alan9900/Thermal-coupling-analysis-under-drive-control-integration/reports/M3_HELICAL_CHECKLIST.md

# M3 斜齿限定修订验收表（2026-10-20）

PR #4 / stage/M3-geometry；本轮概念几何通过，M3整体仍PARTIAL。

- [x] 原三轴坐标、100/120mm中心距、20/60齿、9.0、50mm输出轴保持。
- [x] 固定端面模数2.5/3.0mm；mn=2.34923155/2.81907786mm，非标准法向模数如实说明。
- [x] 真实螺旋扫掠实体；每对相反旋向，真实B-rep长边反算±20°与端面齿数计数通过。
- [x] 原轴向位置及25/32mm齿宽，中间轴两齿轮间37mm保持。
- [x] Case0/A/B/C各完整、热版共8装配；18STEP实际导出并回读检查。
- [x] 3006对全装配AABB后精确布尔零体积穿透；14对旋转啮合几何检查通过。
- [x] 124个未改零件真实位置、边界框与原STEP一致。
- [x] 齿轮和整部件体积/质量/热容表齐备，541项逐体全/热版热容一致性通过。
- [x] 原直齿源码/CAD/结果、M2固定成果与原映射不覆盖。
- [x] 独立热源映射归一，原真实接触/冷却null保持；M1损耗暂沿用且未重标定。
- [x] 数量级轴向力记录；中间轴推力约6.624kN，明确不默认抵消。
- [x] 源代码、配置、报告MD/DOCX/PDF、5图、CSV/JSON/日志及来源PDF归档。
- [ ] 轴承轴向承载与定位验证：BLOCKED，本轮未扩展设计。
- [ ] 齿轮制造、疲劳、真实效率与温度标定：未完成，不在本轮范围。
- [ ] 原连接套/罩支点热态/实际接触及冷却限制：继续保留。
- [ ] 研究者批准M3合并/正式Tag及下一阶段：待审核；不合并、不打Tag、不进入M4。

5个可编辑Word公式与PDF实际渲染检查见document_checks.json；原始失败日志保留，测试通过不代表上述BLOCKED项通过。
