alan9900/Thermal-coupling-analysis-under-drive-control-integration/reports/M1_GATE_ACCEPTANCE_2026-10-19.md

# M1 正式验收关卡（2026-10-19）

研究者明确授权：按“具有明确来源、参数化假设和不确定性分析的概念数值热源模型”限定范围验收M1，要求合并PR #2并创建M1-v1.0；仅在远端归档核验成功后，从最新main创建M2阶段分支。

本次最终复核：原18组及新增11组MATLAB R2025a测试记录齐备；23整车轨迹、46对单侧CSV/JSON、322次敏感性结果及参数矩阵、MAT、PNG/SVG、日志、Markdown/Word/PDF报告和验收表均在Git中。Python独立检查已再次实际执行PASS。数值代码 `2b336e62485e0183f79428dd6009ec7aa32a1ab3`，原完整证据 `ec134044c346e10cac3f7d31e0bfc99dc641ec13`。数值代码未改，不重复宣称重新运行MATLAB。

验收不包括真实损耗标定、实体温度验证、连续能力或法规符合性：实际电流、铁/转子损耗分离、真实再生、减速器方向图/空载搅油、BMS及材料/冷却仍有缺口，**真实标定仍PARTIAL**。原NaN/null不回填；工程区间不是统计置信区间，各热源独立上界不能拼成共同工况，逆变器不默认计入电机绕组，转子其他不等同磁钢热源。

计算结果JSON中未批准/未建Tag字段是当时运行状态，不覆盖本次明确验收；当前审批及实际Tag目标以STAGE_VERSIONS和远端Git验证为准。M1-v1.0必须为本次实际main合并提交的附注Tag；不得指向仅代码提交或旧证据提交。M0-v1.0保持不变。

M2获准范围是单侧概念LPTN、来源与工程参数分离、四类工况、三类路径、能量/数值验证与敏感性，以及报告/PR。不包含M3 CAD、ANSYS或Fluent；M2 PR/正式Tag/进入M3均须用户另行批准。
