alan9900/Thermal-coupling-analysis-under-drive-control-integration/docs/DUAL_MOTOR_V03_ARCHITECTURE.md

# V0.3 双独立电机、单侧热耦合研究架构（当前有效）
日期：2026-10-18。此文件与 `configs/baseline_vehicle.yaml` 是新的**权威基准**；此前 V0.1/V0.2 文字中“中央单电机+差速器”全部为历史设计，不得用于新模型。数值属于概念研究假设，未经厂家或试验验证。

## 1. 机械拓扑和研究边界
1800kg前驱纯电动乘用车；前轴左、右各装**一台独立牵引电机、一套固定减速器、一套输出端内移摩擦制动盘与独立卡钳**；**无机械差速器**，车轮速度差通过电机独立调速实现。制动盘布置于**单侧减速器输出轴**，与对应车轮输出转速1:1（没有下游额外速比时），而不是电机输入轴转速。两个单元在整车动力学中同时存在；热网络/CAD/ANSYS/Fluent只对**单侧**详细建模。后轴保留常规制动器，在整车模型中承担其分配制动力。

## 2. 推荐参数（只为可复现概念基线）
| 项 | 整车/前轴 | 每侧电驱单元 |
|---|---|---|
| 整车质量 | 1800 kg | - |
| 前轴电机数量 | 2 | 1 |
| 电机峰值机械功率 | 合计120 kW | 60 kW |
| 电机峰值机械扭矩 | 峰值扭矩代数和260 N·m | 130 N·m |
| 电机候选最高转速 | - | 14000 rpm（未验证） |
| 传动比 | 两个独立9.0 | 9.0 |
| 减速器牵引效率 | - | 0.96，粗略假设；反拖分开 |
| 制动盘 | 前轴共2个 | 外径280mm、厚22mm、摩擦系数参考0.40 |
| 轮胎有效半径 | 0.32m | 对应轮速 |
| 轴距、重心高、静前轴载荷比 | 2.8m、0.55m、55% | 不再对单侧重复使用整车质量 |

潜在调整：如果每侧都需承担强的再生制动/高速驱动，选择65–75 kW、150–170 N·m也可作为后续替代方案，但前轴合计动力性能将提升，需要统一更新能耗与控制约束。**不要为了制动盘1132 N·m机械制动力矩就盲目把电机130 N·m放大到同等折算值**，摩擦制动盘由卡钳独立产生制动扭矩。

## 3. 自洽性验算（无风阻/滚阻/旋转惯量的演示）
`v=100/3.6=27.778 m/s`；`n_w=v/(2π*0.32)*60=828.93rpm`；`n_m=9*n_w=7460.39rpm`；每侧60kW/130Nm的理想基速`n_b=60k/(130*2π/60)=4407.37rpm`；100km/h时理想峰值转矩受功率限制为`76.80Nm`；160km/h电机转速约11936.6rpm。
每侧低速牵引轮端峰值转矩`130*9*0.96=1123.2Nm`；两侧之和2246.4Nm。注意这仅说明理想稳态动力输出与旧中央单电机方案一致，不代表加速极限受附着或电池功率满足。
100→0平动动能约694.44kJ。平路0.6g制动前轴理想动态分配系数`0.55+0.6*0.55/2.8=0.667857`，前轴总制动力约7075.8N；左右对称，各侧输出端摩擦盘需要`7075.8*0.32/2=1132.13Nm`（**仅零再生的例子**）。0.3g约516.12Nm，0.8g约1598.30Nm。与旧方案相比单盘负荷**不再除以二**：之前本身已有两个前盘。
100km/h下0.6g前轴需求总机械制动功率约`7075.8*27.7778=196.55kW`，单侧约98.28kW。每侧60kW为**电机峰值机械驱动额定定义**，不保证连续再生60kW，也不是卡钳摩擦制动上限。若做概念再生上限估算，单侧回生电机轴端与轮端的能量需要分清反拖效率，受电池接收功率、转矩、电压、SOC和温度制约；无数据默认零再生进行安全边界热负荷仿真。

## 4. 必须区分三个机械功率
1. 摩擦制动热功率`P_fric=T_fric_disc*omega_disc`。
2. 电机在驱动时机械轴端功率，及反拖时从轮端传入的机械功率；传动损耗方向不同。
3. 单侧减速器损耗热，在驱动/再生情况下按不同效率或损耗MAP单独计算。不可把整车制动功率全部作为摩擦热，也不可简单把摩擦热直接加到电机热节点。

## 5. 单侧热网络建议
节点：制动盘、摩擦片/卡钳、护罩、输出轴/轴承、减速器壳体、齿轮与油液、电机壳体/定子/绕组、转子磁钢、周围空气与冷却液边界。路径：盘→护罩/壳体辐射；热空气→壳体对流；盘→输出轴→轴承→壳体固体导热。电机自身铜耗/铁耗与减速器啮合/搅油损耗独立加入。冷却边界保持简单参数化，不先做全车热控制。

## 6. 优化设计
对照Case0 无护罩，CaseA单层，CaseB双层间隙，CaseC隔热+导流，CaseD CaseC参数优化。单侧模型保持相同制动机械热源和初始条件。变量`[盘-护罩间隙,厚度,导流出口角度,出口面积比]`。目标筛选为电机绕组最高温度、减速器油温、制动盘峰值温度与附加质量；在可靠热限未知前只做相对改善，不宣称可量产。
输入工况：M1首版0.3/0.6/0.8g零再生，再生场景需双方电机和电池总限值分配；M7主工况为高负荷牵引预热后循环制动。

## 7. 必须优先确认（P0）
(1) 60kW/130Nm单侧电机的最大转速与正/反拖效率或损耗MAP；(2) 单侧减速器速比/减速级数/齿轮箱几何/损耗；(3) 输出端制动盘实际质量、有效摩擦半径、卡钳转矩容量与热衰退；(4) **制动盘至减速器壳体的最小净距离**，并区分与制动盘到护罩间距；(5) 单侧电机和减速器冷却边界与允许温度；(6) 左右驱动功率/再生分配、后轴制动及轮胎附着约束。

## 8. Codex M0 Gate
M0首先检查项目中是否残存 `differential`、`single_motor`、`motor_peak_power_kw:120` 被当作*单侧*输入的旧逻辑。测试理想速度换算、60kW分段功率-转矩限制、左右功率合计、动力学制动力、单侧盘负荷及每侧热源能量闭合；未通过不进入M1。旧`docs/BASELINE_V02_AUDIT.md`历史数值仍可作为**整车制动边界**参照，但其“中央单电机”架构结论失效。所有结果标明ASSUMED/SYNTHETIC与模型版本。
