alan9900/Thermal-coupling-analysis-under-drive-control-integration/docs/M2_SOURCE_REVIEW.md

# M2 参数、资料与适用范围审查

本阶段为S3概念LPTN，未做实物温度标定。参考数据、方法依据和工程等效参数严格分开；`configs/baseline_vehicle.yaml`及已验收M1不改。检索采用已读取的nature-academic-search多来源检索流程：学术MCP未挂载，使用NIST、作者期刊页面、制造商原始资料和CrossRef；并非穷尽检索。

| 来源 | 核实内容与实际用途 | 限制 |
|---|---|---|
| ORNL 2011 Prius报告，表2.7，印刷46/PDF55页；M0已存原件 | 参考定子铁心10.36kg、绕组铜4.93kg、转子6.7kg（含电机轴）；作为等效热容的质量参照 | 不是本概念总成实测质量；输出轴为减速器另一根轴，不重复计入电机轴；材料复合热容仍是假设 |
| [NIST Copper](https://webbook.nist.gov/cgi/cbook.cgi?ID=C7440508&Mask=2) / [Aluminum](https://webbook.nist.gov/cgi/cbook.cgi?ID=C7429905&Mask=2) / [Iron](https://webbook.nist.gov/cgi/cbook.cgi?ID=C7439896&Mask=2)，Chase1998 | 固相Shomate式及摩尔质量；298.15K折算cp约385.08、897.14、449.41 J/(kg·K)，铜385、铝类900的候选量级可追溯 | 纯材料，不是浸漆绕组、叠片、齿轮钢或复合转子；模型常数cp忽略温变，整体热容仍S3 |
| [Hydro EN AW6082资料线索](https://www.hydro.com/Document/Index?id=7824&name=Hydro+EN+AW+6082.PDF) | 官方搜索索引可见密度2.71g/cm³、cp897 J/(kg·K) | 直接PDF获取失败，未声称取得本地原件。ρ2710、k170作为铝类S3候选，尤其k170未据此冒称具体牌号已核验 |
| [Fluke金属发射率表](https://www.flukeprocessinstruments.com/en-us/service-and-support/knowledge-center/infrared-technology/emissivity-metals) | 原厂页面可读，表明抛光/氧化与波段显著影响发射率；氧化铸铁可见约0.7–0.9的部分波段条目 | 红外测温表的谱发射率不等于本模型的总半球灰体值；盘0.8、壳体0.7、护罩0.2均为S3，不能由材料名直接标定 |
| [COMSOL自然/强迫对流方法说明](https://www.comsol.com/blogs/modeling-natural-and-forced-convection-in-comsol-multiphysics/) | h与自然/强迫流动、几何及工况相关，方法页举强迫换热量级 | 本模型h=h0+hv√v并非该文拟合关联式，未做CFD、未证实内移盘局部气流；所有面积/h/通风参数S3 |
| Xiao & Griffo 2020，[DOI10.1049/iet-epa.2020.0119](https://doi.org/10.1049/iet-epa.2020.0119) | 期刊全文浏览可读：电机定子、绕组、转子网络与热参数辨识；需要测温等证据才能辨识热阻 | 不移植其机器热阻或温度误差。Python直接下载失败，保留限制，不伪造本地全文 |
| Corley等2019，[DOI10.1049/joe.2018.9282](https://doi.org/10.1049/joe.2018.9282)，M1已有公开PDF | 分项损耗分别加载节点、C=mcp及热网络方法；CrossRef元数据复核 | 原对象为风机减速器，仅借鉴方法，不转用几何与标定 |
| NASA早期发射率检索路线 | 原始路线直接下载失败；另有表面氧化/高温谱发射率研究线索 | 未用于填任何“实测”参数，失败记录保留在manifest |

检索时间、URL、HTTP状态、摘要性用途及内容哈希见 `data/raw/m2/manifest.json`。可复算材料参考式/数值见 `material_reference_values.json`，不复制受版权限制的整页数据库。Fluke补充浏览核对在该材料登记中另列；并非热参数标定。资料可能有访问限制，未因下载失败而假造原件或无限等待。

## 数值候选与实际使用

13节点的质量、cp、ρ、k、ε、热容和假设级别均导出到 `results/m2/parameter_source_table.csv`。**只有质量×cp参与C；ρ、k是材料与后续几何审查候选，本阶段没有用它们反推出真实尺寸或接触R。** 质量和cp中部分S1/S2标量的组合不使整个节点或总成成为已标定对象。

盘4.5kg、片/钳等效2kg、输出轴1.2kg、轴承0.35kg、齿轮2.5kg、油0.8kg、减速器壳4kg、电机壳5kg、护罩0.4kg及局部空气0.05kg均为S3。片/钳合并保留总热容，仅预测平均等效温度，不给片面热点或制动液温度；转子/其他是合并损耗节点，不是永磁体热点；油节点也承担未分离齿轮箱其他损耗，不能等同真实均匀油池温度。

导热网络15条等效R（0.08–8K/W）、对流面积、有效辐射面积/视角因子、液冷G=25W/K均为S3。盘—轴、轴—轴承/齿轮、轴承—壳体、壳体法兰、定子/绕组接触及钳支架这9组等效R共同乘接触尺度0.3–3；该尺度覆盖的是包含接触与部分几何的等效热阻，不是分别识别的真实接触热阻。

环境和入口冷却液候选均298.15K，用以隔离热源效应；冷却液温度另扫到333.15K。液冷通过电机壳体的固定温度热库与总导热能力表示，不虚构流量或泵参数。若冷却液更热，热量可以倒流进入网络，必须保留负的“冷却净带走热量”。

## 不确定性口径

热容0.6–1.4、接触R0.3–3、对流0.5–2、液冷G0.5–2、辐射交换0.5–1.5、电机联合损耗0.8–1.2、减速器损耗0.7–1.3及冷却液298.15–333.15K为S3单因素探索范围，不是概率分布，也不保证包含真实值。辐射尺度改变内部有效交换，未穷尽外界辐射、遮挡、表面老化及几何不确定性。

两组M1分配参数联合端点也分别重算整套守恒分项，不拼接各项上界。总损耗尺度把相关分项共同缩放，保持组内预算，但没有重新求电池限充和再生控制；属于固定运动/控制工况下施加热源误差，不称为重新闭合的整车能量轨迹。

空载电驱拖曳、齿轮搅油与温度反馈仍未建模：停用时真实附加热可能大于零，乘法尺度不能恢复基准为零的损耗；真实油黏度、绕组R、磁性和冷却随温度变化会改变热源/热阻。当前不做闭环追加3RI²，避免在M1总预算之上重复加热。缺少真实冷却和内部热阻是绝对温度可信度的主要限制，不能用数值守恒替代实验验证。
