alan9900/Thermal-coupling-analysis-under-drive-control-integration/docs/REAR_DRIVE_V04_SOURCED_BASELINE.md

# V0.4 后驱分布式双电机 / 单侧驱制热耦合方案（当前权威）
更新：2026-10-18。主配置文件：`configs/baseline_vehicle.yaml`。原V0.1中央单电机、V0.3双前驱均**失效**，只作为历史记录。所有跨车型拼接的硬件为**概念研究**，不是实际大众ID.3或丰田电驱桥的量产总成。

**M0审查已完成（2026-10-18）**：见 [M0报告](../reports/M0_report.md)、[复算说明](../scripts/m0/README.md)。EPA MG2原包已下载并核验：`.m`含14×39联合电功率表，0–13000rpm、−200至200Nm；负转矩区由驱动损耗乘1.05镜像估计，**不是实测再生图**。另发现137个配对的独立电机/逆变器驱动效率点；仍没有绕组损耗图。13000–13500rpm不可直接外推。M0之后的热源、热场与优化仍须用户确认。

## 1. 来源可信度与引用
**整车尺寸参照**：Volkswagen ID.3（2023）官方技术资料：https://www.volkswagen.ie/idhub/content/dam/onehub_pkw/importers/ie/models/product-guides/my23/ID3_MY23.pdf ，可确认相关车型动力水平、160 km/h最高车速、215/55R18轮胎；轴距2765mm已在MY21官方PDF第19页图示L101目视核实：https://www.volkswagen.ie/idhub/content/dam/onehub_pkw/importers/ie/models/product-guides/2021/my21_master/ID3_MY21.pdf ，属于较早版本几何参照。Cd=0.27的2020官方技术页本次直接访问404，仅搜索索引可见，保留为未验证筛查值。概念车质量1800kg、后轴静载55%、重心高0.55m等是**工程假设**，不能归为同一版本厂商测量值。大众减速器资料：https://www.volkswagen-group.com/en/press-releases/in-brief-the-all-rounder-the-1-speed-gearbox-17030 ，公布2级单速减速器及约10倍速比（非本研究减速器9.0的真实来源）。
**电机额定能力参照**：Toyota 2009第三代Prius发布 https://global.toyota/en/detail/308252 (60kW、207Nm)；ORNL FY2009基准研究 https://info.ornl.gov/sites/publications/files/Pub21475.pdf (额定最大速度13500rpm、60kW、207Nm)；单侧电机为概念移植，**不代表此电机能在1800kg纯电后驱车中以60kW持续工作**。
**效率数据**：美国EPA https://www.epa.gov/vehicle-and-fuel-emissions-testing/combining-data-complete-emotor-alpha-maps ，其中“2010 Toyota Prius 60kW 650V MG2 EMOT”数据包。EPA定义EMOT=电机+逆变器（不包含齿轮）；**不等于纯电机铜/铁损耗MAP**。原包已于M0下载核验，原始文件及哈希见`data/raw/m0/`。数值再生区存在但为镜像估计；`3c`有独立电机和逆变器的稀疏驱动效率。不能据此直接建立绕组发热图，`motor_loss_map_file`仍为null。
**制动盘几何参照**：Brembo https://www.bremboparts.com/europe/en/view-document/catalogue/disc/09-9908-21 ，后轴通风盘：直径280mm、厚22mm、总高度42mm、中孔68mm。该产品是量产后制动盘几何参照，**不能直接断言可以安装于单侧电机减速器输出轴**；必须重新设计盘毂、轴承、卡钳支架并校核强度与温度。
**原方法学借鉴**：Park et al. (2025), Energy Conversion and Management 325,119406 DOI:10.1016/j.enconman.2024.119406，原文对象是轮边EMB执行电机，不等于主牵引电机。
文献都只支持其明确披露的参数；缺乏的重心、轴荷、负载、效率与结构尺寸全部按概念假设处理。

## 2. 当前架构
1800kg **后驱**纯电概念车型。后桥左侧、右侧各1套**独立永磁同步驱动电机(参考2010 Prius MG2) + 独立双级减速器(设计候选总速比9.0) + 减速器输出端内移摩擦制动盘**。不设机械差速器；每侧轮速/制动盘转速独立；前桥保留常规摩擦制动器。**只对一侧电机、减速器、内移制动器开展详细三维温度场/隔热导流优化**；整车制动力与再生分配必须同时计入两侧及前轴。对称直线工况每侧后轴需求 = 后轴总需求/2；非对称工况只在鲁棒性阶段处理。

## 3. 建议的当前基准值及判据
| 参数 | 数值 | 证据/状态 |
|---|---:|---|
| 整车质量 | 1800 kg | 概念基准（不是该版本ID.3实测值） |
| 轴距 | 2.765 m | ID.3级尺寸参照；待在具体车型官方规格中核实 |
| 后轴静态荷重比例 | 0.55 | 假设，扫描0.50–0.60 |
| 重心高度 | 0.55 m | 假设，扫描0.45–0.65m |
| 轮胎标称规格 | 215/55R18 | VW官方参考 |
| 轮胎标称未加载半径 | 0.34685m | 按轮胎标称尺寸几何换算 |
| 有效滚动半径 | 0.33 m | 假设，需测量/扫描0.32–0.34m |
| 设计最高车速 | 160 km/h | 参考ID.3目标；动力性能待验算 |
| 电机每侧 | 60kW、207Nm、13500rpm | Toyota/ORNL原始电机能力参照 |
| 软件牵引转矩限值 | 130Nm/侧 | 设计假设；非电机硬件铭牌值 |
| 电机连续功率、回生极限、铜/铁损耗 | 未知 | 必须确认；不可直接采用60kW |
| 每侧减速比 | 9.0 | 两级候选方案；需几何参数化 |
| 减速器驱动/反拖效率 | 分别初设0.96 | 粗略估计，后续损耗MAP |
| 制动盘几何 | φ280×22mm,高度42mm | Brembo原后制动盘参照，改内移需要设计 |
| 电驱冷却液温度/流量、允许温度、制动盘质量 | 未知 | P0/P1重点数据 |
| 盘-壳体净间距、轴径/支架/壳体几何 | 未知 | 不能提前冻结隔热罩 |

## 4. 可复核自洽性算例：驱动
`r=0.33m, i=9, P_motor_peak=60kW, T_motor_hardware_peak=207Nm, T_software_limit=130Nm`；假设平路直线、左右轮速相等。
- 100km/h `n_w≈803.81rpm; n_motor≈7234.32rpm`。
- 160km/h `n_motor≈11574.9rpm < 13500rpm`，**仅转速约束通过，不等于总动力/空气阻力/电池条件已验证**。
- 13500rpm对应的理想车速约186.61km/h，但整车设计最高车速仍保持160km/h。
- 原硬件60kW/207Nm理想恒转矩/恒功率转折点约2767.9rpm；若施加130Nm软件限扭并允许60kW，则理想转折点为4407.4rpm；两者不能混为一张真实MAP。
- 100km/h时，每侧理想60kW功率上限对应约79.20Nm轴端转矩。
- 软件限扭130Nm时，每侧低速轮端最大驱动转矩约1123.2Nm（粗略假设传动效率0.96），两侧总轮端2246.4Nm。该值还要受后轴轮胎附着限制。峰值硬件207Nm全开为1788.5Nm/侧，不应该默认用于整车。
- **再生**上限不等同60kW驱动上限。使用EPA MG2数据前，核验负转矩/发电区与电池功率吸收限制，不能将正向牵引效率简单逆用。

## 5. 可复核自洽性算例：制动（重点改动）
平直道路减速，动态后轴法向载荷比例
`f_rear_dynamic=0.55 - z*0.55/2.765`，其中`z=a/g`，这只是同附着利用率理想制动力分配基线，**不是量产EBD/ABS控制律**。忽略滚阻、风阻、旋转惯量，无再生、后轴左右对称，`m=1800, r=0.33m, v0=100/3.6m/s`：

| 减速度 | 后轴动态载荷比例 | 后侧单盘摩擦扭矩(Nm) | 初始单盘摩擦功率(kW) | 单盘接触摩擦总功(kJ) |
|---|---:|---:|---:|---:|
| 0.3g | 0.49033 | 428.6 | 36.1 | 170.3 |
| 0.6g | 0.43065 | 752.8 | 63.4 | 149.5 |
| 0.8g | 0.39087 | 911.1 | 76.7 | 135.7 |

**后驱与前驱必须区别**：制动时重心前移、后轴载荷比例下降；不能将先前“前盘0.6g约1132Nm”搬到后盘。此处0.8g需足够路面附着和前轴制动能力才能实现；例如假设`mu_tire=0.8`且整车理想四轮同利用率，已接近总附着极限。
此外，对本研究后轴双电机纯后驱：加速时后轴增载，后轴附着约束应为`a/g<=mu*0.55/(1-mu*0.55/2.765)=0.52327`（`mu=0.8`，忽略路阻）。M0修正了原稿正号分母及0.3796的错误。当前130Nm/侧软件限扭对应低速约0.38551g，先受力矩而非上述附着上限约束。先前单前驱和双前驱时的公式不能直接照搬。

**单盘接触热≠单盘储热，更不等于热侵入电机的能量**；需盘/片热分配、对流、辐射与输出轴导热求解。高SOC、电池低温、低速回生衰减可导致后轴摩擦热增加；也必须比较高负载驱动热浸后紧急/重复制动时的温升。

## 6. M1-M7对新架构的改变
M0读取本文件和V0.4配置，**阻断front_axle/differential/120kW_single_motor**旧变量作为当前参数；检查前后轴动态载荷与后轴左右各半、速度转矩和能量守恒。
M1单侧电机热源优先用来自EPA/ORNL的完整MAP；必须给出是否包含逆变器损耗，热源进入机壳/绕组/逆变器的比例需要进一步资料，不可把EMOT全部损耗加到电机绕组。减速器独立loss map。
M2热网络以单侧后制动盘、输出轴、轴承、减速器齿轮油液与壳体、电机定转子、护罩及空气为节点；包含辐射、自然/强制对流、盘-毂-轴-轴承固体导热。若逆变器未布置在单侧电机旁，可以作为电热功率边界不纳入单侧3D热域，但不能错误计入绕组。
M3/M4首先确认制动盘旋转支撑、夹紧反力路径、轴承负荷、壳体净间距，再设计Case0/A/B/C/D护罩方案。参考Brembo盘不能直接宣称可用。
M5局部CFD优先考虑内移制动盘附近真实底盘气流，单侧电驱周围空气对流的边界与轮边EMB不同；MRF稳态不能替代制动瞬态。
M6优化目标以`T_motor_winding_peak`、`T_gear_oil_peak`、`T_disc_peak`、附加质量/热侵入量为候选，敏感性决定主目标。
M7强调“高负载牵引预热后循环制动”、“再生功率受限”和“低速通风变弱”的联合工况。必须以热数据和符合能量收支的数值计算支撑结论。

## 7. 数据获取任务（Codex必须优先处理）
- 读取EPA页面MG2 EMOT ZIP，验证文件内轴转矩符号、扭矩转速范围、效率定义、发电象限、工作电压；保留原始引用URL及许可，自己编写读取/插值测试。
- 确认ORNL报告中的电机体积、热容、冷却方式和最高转速适用范围；若无法获得相匹配的电机内部发热分布，先研究总电热损耗的热网络并给不确定性区间。
- 选择固定单侧减速器的两级齿比组合与CAD尺寸，计算轴承力与输出端制动盘的安装空间，避免只用传动比代表实际产品。
- 根据可靠材料/部件数据确定绕组/磁钢/润滑油/卡钳热限。没有这些数据时保留null。

## 8. 来源和数据级别
S1：指定版本OEM/ORNL/EPA/Brembo原始数据。S2：论文同类数据。S3：解释明确的工程估算。S4：演示假设。每个参数另记物理范围、温变、设计模型版本和验证状态。**当前尚无该概念总成的实体实测验证**。
