alan9900/Thermal-coupling-analysis-under-drive-control-integration/data/raw/m0/epa_mg2/2- Related NCAT Packages.docx

2- Related NCAT Packages

The following is a listing of the NCAT Test Data and ALPHA Map Packages which contain results or testing associated with or referenced to the testing contained with the provided package. Use of any NCAT documents listed below, included as part of the complete test data package, should reference the suggested citation provided.

RELATED NCAT PACKAGES:

2010 Toyota Prius 60kW 650V MG2 EMOT – ALPHA Map Package

EST 2010 Toyota Prius 60kW 650V MG1 EMOT – ALPHA Map Package

NCAT – National Center for Advanced Technology National Vehicle and Fuel Emissions Laboratory – Office of Transportation and Air Quality U.S. Environmental Protection Agency
