alan9900/Thermal-coupling-analysis-under-drive-control-integration/reports/planning/research_work_plan_v04_2026-10-19_v1.prompt.md

# 工作安排图生成记录

日期：2026-10-19（Asia/Shanghai）。配置版本：V0.4。图片修订：v1（图稿版本，不是阶段Git Tag）。

模式：imagegen技能，内置image_gen工具；没有使用CLI或外部API脚本。

来源：`docs/REAR_DRIVE_V04_SOURCED_BASELINE.md`、`configs/baseline_vehicle.yaml`、`docs/CODEX_EXECUTION.md`、`docs/GIT_VERSIONING_POLICY.md`、本分支`docs/STAGE_VERSIONS.md`及当时打开的PR #1。

图片：`research_work_plan_v04_2026-10-19_v1.png`。内容表达M0–M7共8个阶段的先后安排，未分配工期。状态截点为2026-10-19：M0技术交付完成但待研究者验收，PR未合并，M1–M7未开始。图稿不表示阶段已获批准。

## 最终生成提示词

```text
制作一张高分辨率、中文文字清晰且完全准确的科研项目工作安排信息图，竖版，建议约1800×2600像素。主题是电动车驱制融合热耦合研究的八阶段计划，不是汽车宣传海报。使用纯白或极浅蓝背景、深海军蓝标题、蓝色和青色细线，只有当前M0使用琥珀色强调，简洁严谨的科研汇报风格。不要照片、写实汽车、无关插图、水印。大字体、充分留白。用纵向八行、从M0至M7的编号进度轴，右侧八张等宽卡片，必须恰好八个阶段，全部按顺序排列，不得遗漏重复。每卡写阶段标题、一行或两行工作内容和一行交付物，文字必须逐字遵守下列内容，不要新增数据、工期或已完成标记。

顶部主标题：“驱制融合热耦合研究工作安排”
副标题：“V0.4 后驱双独立电机｜共 8 个阶段”
对象说明：“1800 kg 概念车 · 左右独立电驱 · 无差速器 · 详细热场研究单侧”
醒目的当前进度横条：“当前：M0 已提交，待验收；M1—M7 尚未开始”

八张卡片文字：
M0 参数与资料准备
内容：“核验 EPA／ORNL 数据，审查整车参数、制动能量与功率匹配，登记未知项。”
交付：“交付：来源清单、计算脚本、参数审查报告”
状态小标：“待验收”

M1 多热源模型
内容：“建立制动摩擦、电机及减速器损耗模型，考虑再生限制并校核整车能量守恒。”
交付：“交付：MATLAB 热源程序、功率与能量曲线”
状态小标：“未开始”

M2 瞬态热网络
内容：“建立单侧盘—轴承—减速器—电机热网络，计算导热、对流、辐射与温度响应。”
交付：“交付：热网络、温度曲线、敏感性分析”
状态小标：“未开始”

M3 结构与安装方案
内容：“确定内移盘、轴承、支架和壳体布局，设计隔热与导流方案，检查受力与间隙。”
交付：“交付：参数化几何、候选结构与可行性清单”
状态小标：“未开始”

M4 ANSYS 瞬态传热
内容：“计算三维温度场与热侵入路径，检查网格及时间步独立性，对照热网络。”
交付：“交付：有限元模型、温度场与验证记录”
状态小标：“未开始”

M5 Fluent 流动换热
内容：“分析内移盘附近气流、旋转与通风，比较导流方案并提取换热边界。”
交付：“交付：流场、换热参数与数值检查记录”
状态小标：“未开始”

M6 多目标优化
内容：“开展试验设计、代理模型和多目标搜索，权衡部件温度与质量，回代验证。”
交付：“交付：Pareto 方案、优化结果与复核报告”
状态小标：“未开始”

M7 综合验证与论文
内容：“检查热浸后制动、重复及再生受限工况，评估不确定性，整理论文与复现资料。”
交付：“交付：综合验证、论文图表与研究归档”
状态小标：“未开始”

底部放清晰的制度流程条：“每阶段：独立分支 → 提交与推送 → PR 审查 → 用户批准后合并 → Tag 与版本登记”
在流程条下突出：“未经批准，不进入下一阶段”
小字注明：“按验收顺序推进；工期尚未确定。数值验证与实体实验须明确区分。”
最底部：“依据：仓库 V0.4 方案、阶段执行规范及 Git 版本制度｜状态：2026-10-19”

请确保简体中文没有错字，没有丢失标题与交付行，字号适合在聊天中放大阅读，八行之间用细箭头串联。
```
