alan9900/Thermal-coupling-analysis-under-drive-control-integration/docs/STAGE_VERSIONS.md

# 研究阶段版本登记（正式Tag由研究者审批后创建）

规则详见 [Git阶段版本管理制度](GIT_VERSIONING_POLICY.md)。研究基准V0.4是车型配置版本，不是里程碑Tag版本。

| 阶段 | 审核状态 | Git Tag | Commit SHA | PR | 配置版本 | 测试与成果 |
|---|---|---|---|---|---|---|
| M0 参数审查 | APPROVED（参数与资料准备范围） | [M0-v1.0](https://github.com/alan9900/Thermal-coupling-analysis-under-drive-control-integration/releases/tag/M0-v1.0)，附注Tag已推送验证 | 验收main `b13f265b1ff0add1f9e8b166d2c1bfa4ac8a8d16`；Tag对象 `d50d3896b71480bc3793a82d274f862afac1f8ec` | [PR #1](https://github.com/alan9900/Thermal-coupling-analysis-under-drive-control-integration/pull/1)，MERGED | V0.4 | [关卡记录](../reports/M0_GATE_ACCEPTANCE_2026-10-19.md)；Python 3项／MATLAB既有12组检查及18组制动积分通过；批准日期2026-10-19，用户授权简验后进入M1 |
| M1 热源建模 | APPROVED（概念数值模型）；真实标定PARTIAL | [M1-v1.0](https://github.com/alan9900/Thermal-coupling-analysis-under-drive-control-integration/releases/tag/M1-v1.0)，附注Tag已推送核验 | 验收main `9d545ab39a3efcce857573af74f7e325b74a2b15`；Tag对象 `9b3c7f97c63b56b50eb7c0477a72ad03060cae39` | [PR #2](https://github.com/alan9900/Thermal-coupling-analysis-under-drive-control-integration/pull/2)，MERGED | V0.4 | [报告](../reports/M1_report.md) / [Word](../reports/M1_report.docx) / [PDF](../reports/M1_report.pdf) / [验收表](../reports/M1_ACCEPTANCE_CHECKLIST.md)；R2025a原18+新11测试组、23整车轨迹、46单侧接口及322敏感性运行通过；Python独立复核通过；严格模式拒绝、工程模式S3；M2 NOT EXECUTED |
| M2 热网络 | APPROVED（概念瞬态网络限定范围）；实物标定未完成 | M2-v1.0，附注Tag已推送核验 | 验收main `1d51c22d94577ff8f52be785300b5f6b4aadee37`；Tag对象 `4ad89c4a220174de741b4ba48706279d3b7cb2d1` | [PR #3](https://github.com/alan9900/Thermal-coupling-analysis-under-drive-control-integration/pull/3)，MERGED | V0.4 | [报告](../reports/M2_report.md) / [Word](../reports/M2_report.docx) / [PDF](../reports/M2_report.pdf) / [验收表](../reports/M2_ACCEPTANCE_CHECKLIST.md)；11组测试、4+3+18场景及Python/SciPy复核PASS；2026-10-20批准，真实几何/热阻/换热/温度未标定 |
| M3 几何设计 | APPROVED（参数化概念几何及传热准备）；机械认证未完成 | [M3-v1.0](https://github.com/alan9900/Thermal-coupling-analysis-under-drive-control-integration/releases/tag/M3-v1.0)，附注Tag已推送核验 | 验收main `7a6b9b1512495283fa12dd4a2a7ffdf698554d3e`；Tag对象 `c958ec76330c016e0dc3f8ca141f2b139f6c53f3` | [PR #4](https://github.com/alan9900/Thermal-coupling-analysis-under-drive-control-integration/pull/4)，MERGED | V0.4 | [斜齿修订报告](../reports/M3_helical_revision.md) / [Word](../reports/M3_helical_revision.docx) / [PDF](../reports/M3_helical_revision.pdf) / [验收表](../reports/M3_HELICAL_CHECKLIST.md)；[批准范围](../reports/M3_APPROVED_SCOPE_2026-10-21.md)；2026-10-21批准，18 STEP及66个Git blob核验；轴向承载、连接、实际接触与冷却等限制保留 |
| M4 ANSYS | PARTIAL（暂停求解；后续零再生计划待执行） | NOT CREATED，未经批准不创建 | 既有云图交付登记 `602e72e34301bd2ae27c0c7abde84e27c06ea863`；本轮计划更新另见最新登记 | [PR #5](https://github.com/alan9900/Thermal-coupling-analysis-under-drive-control-integration/pull/5)，DRAFT | V0.4 | [历史报告](../reports/M4_report.md) / [验收表](../reports/M4_ACCEPTANCE_CHECKLIST.md) / [当前零再生计划](NO_REGEN_WORK_PLAN.md)；原含再生证据保留，未生成新零再生结果，数值与敏感性验证待后续授权 |
| M5 Fluent | NOT_STARTED | NOT CREATED | — | — | V0.4 | 后续采用零再生热负荷，需前序归档及独立授权 |
| M6 优化 | NOT_STARTED | NOT CREATED | — | — | V0.4 | 零再生条件下隔热导流比较；未经批准不开展 |
| M7 验证 | NOT_STARTED | NOT CREATED | — | — | V0.4 | 零再生单次/重复制动与预热组合；未经批准不开展 |

正式完成时需将Git Tag、PR URL、Git commit SHA、配置版本、批准日期、测试通过/失败/未运行项目写入此表。禁止将本次增加管理制度的Git commit SHA冒充M0正式版本。

下文按时间顺序保留历史送审与开发状态；当前阶段状态以本表和最新登记为准。2026-10-22再次核对远端M0–M3 Tag对象及目标均未改动，main仍为M3验收合并提交；无M4-v1.0。

M0本次使用`stage/M0-parameter-audit`分支补齐历史成果送审。`PARTIAL`表示正式审批流程尚未完成，不表示已重新验收失败；技术完整性与未验证数据见验收摘要。原M0结果、配置及报告不被此次复核覆盖。候选版本名不代表Git Tag已经存在，尚未尝试创建正式Tag。

治理基线为`fe434fb1f846b96474a6736d77bdc20f66dc2cb7`；这不是已批准的M0阶段版本。M1–M7保持`NOT_STARTED`。后续批准后只从相应验收后的main创建下一阶段分支；修复另建版本，禁止移动或删除旧Tag。

复核脚本提交为`10f16519e332dcb32ac9c8927a5a303cbf8b54a6`。上述复核证据SHA固定指向保存日志、MAT、CSV与图的提交；本次PR链接登记在后续提交中，避免文档自引用自身提交SHA。批准后需登记实际验收main提交及不可变Tag，不将证据SHA或登记SHA自动当作正式版本。

2026-10-19送审说明补充：[工作安排图片](../reports/planning/research_work_plan_v04_2026-10-19_v1.png)及[生成提示词](../reports/planning/research_work_plan_v04_2026-10-19_v1.prompt.md)随现有M0分支提交PR #1。`v1`仅指图稿修订，不是正式阶段版本；未改变M0待验收及M1–M7未开始的状态。

## 2026-10-19当前关卡更新

用户已授权简单验收M0通过后进入M1，复核已通过。上方旧送审说明、验收摘要及工作安排图均为其生成时状态，保留追溯；当前状态以上表与[M0关卡记录](../reports/M0_GATE_ACCEPTANCE_2026-10-19.md)为准。合并后将验证Tag是否成功创建并在后续提交登记实际SHA；不把拟议Tag冒充现有Tag。

M0已于本轮合并且附注Tag实际创建成功，远端剥离Tag后的目标SHA已核对为`b13f265b1ff0add1f9e8b166d2c1bfa4ac8a8d16`。本登记属于之后的M1开发提交，**M0-v1.0固定指向实际验收合并提交**，不移动Tag以包含后来的登记文字。M1仅被授权开发，M2–M7仍未授权。

## M1 数值交付（2026-10-19）

分支 `stage/M1-heat-sources` 直接从已验收的M0 main提交创建。全部23组轨迹保存在 `results/m1/traces/`，配置快照、文本SHA-256、实际MATLAB日志、MAT结果、曲线和独立复核见 `results/m1/`；复现命令见 `scripts/m1/README.md`。数值代码SHA与输入哈希固定在 `inputs.json` 和 `independent_checks.json`。报告包含27个可编辑公式，Word经实际导出PDF并逐页检查。真实标定缺口使本阶段保持PARTIAL；M1未合并、TAG NOT CREATED，M2–M7未开展。

证据归档提交：`2514a6d337eb5300b4f807419a3e1f7b66a72cd7`，含报告Markdown/Word/PDF、23条CSV轨迹、MAT、图表、运行日志、独立复核与文档检查；本行在后续登记提交加入，避免提交SHA自引用。送审为上述PR #2，不将草稿PR视为已验收版本。

## M1 参数化与不确定性补充（2026-10-19）

用户已授权继续同一分支/PR，允许明确标识的工程替代模型，不批准合并/Tag/M2。代码提交 `d3dbf6c5839b9d228db8665e76da0c5d7549c0dd` 引入参数化分项；`2b336e62485e0183f79428dd6009ec7aa32a1ab3` 补充时序输入溯源保护及图表标识，最终实际运行采用后者。旧证据提交保留，可从历史恢复；本轮更新M1报告及结果，不改M0固定版本。

独立工程配置 `configs/m1_source_partition.yaml`，资料审查 `docs/M1_SOURCE_REVIEW.md`，未来输入合同 `docs/M1_HEAT_SOURCE_INTERFACE.md`。46对CSV/JSON、161×2参数运行、MAT/图表/日志及检查位于 `results/m1/engineering/`。范围为固定联合/传动总损耗下的守恒分配及条件区间，非实测置信区间；真实绕组数据仍NaN/null。概念数值验收条件已具备，研究者验收PENDING；M1未合并，TAG NOT CREATED，M2–M7未开展。

本轮完整证据归档SHA：`ec134044c346e10cac3f7d31e0bfc99dc641ec13`。含12页Markdown/Word/PDF报告、52个可编辑数学对象、5幅报告图、验收表、46对单侧接口、322次敏感性结果及参数矩阵、独立检查与运行日志。文档逐页视觉检查PASS；本行在后续登记提交加入，避免自引用。后续登记不改数值代码或证据内容，不表示已经批准M1。

## M1 最终验收授权

2026-10-19研究者按“具有明确来源、参数化假设和不确定性分析的概念数值热源模型”验收M1，批准合并PR #2及附注Tag归档；真实损耗标定仍PARTIAL。见reports/M1_GATE_ACCEPTANCE_2026-10-19.md。下阶段授权须以M1远端归档核验成功为前提。旧段落及计算JSON中的待审状态是历史快照，当前以本关卡为准。合并及Tag核验后的准确SHA在后续登记，Tag固定指向实际合并main提交。

## M1远端归档核验与M2启动

PR #2已合并，M1-v1.0附注Tag对象 `9b3c7f97c63b56b50eb7c0477a72ad03060cae39`，远端剥离目标已核对为实际验收main合并提交 `9d545ab39a3efcce857573af74f7e325b74a2b15`。M0-v1.0仍为 `b13f265b1ff0add1f9e8b166d2c1bfa4ac8a8d16`。本段在之后的M2分支登记，Tag固定在真实验收提交，不移动Tag以包含后续登记文字。M2分支从该最新main创建，M2合并/正式Tag/M3仍须另行批准。

## M2数值送审（2026-10-19）

运行源提交`ff818ccb35daf8d70d0cbafbf28fc6690ab457a8`；后续仅完善资料说明、图稿颜色/布局及报告。13节点、4基础场景、3路径移除、18敏感性均已实际运行MATLAB25.1/R2025a。11组测试PASS；C名义/细步峰值差0.001203K，D0.001562K；全网络最大相对能量残差5.28e-14；Python独立复核7场景及自适应RK45比较PASS，最大温差0.002916K。初次12,000s无源测试未达0.1K要求，日志保留；延长至24,000s后通过，未放宽阈值。

成果位置`results/m2/`，代码`scripts/m2/`，配置`configs/m2_thermal_network.yaml`，来源审查`docs/M2_SOURCE_REVIEW.md`。限S3概念预测；M1真实损耗仍PARTIAL，实际热阻/冷却/几何未知，空载拖曳、零功率搅油及温度反馈尚未建模。完整证据SHA在后续登记提交追加，避免自引用。本次没有M2验收授权，PR保持草稿、正式Tag NOT CREATED；M3/CAD/ANSYS/Fluent未开展。

### 2026-10-20中断恢复及完整证据登记

完整证据提交为`d19bae2f3691ee2501c1659beb8135a2e004ee9d`，包含7场景CSV/JSON、18敏感性MAT结果、原始源项、PNG/SVG、实际日志、独立检查及9页Word/PDF（18个可编辑数学对象、6幅报告图、逐页视觉检查PASS）。报告/资料/图稿布局准备提交为`229939cb588a8cb52c6c43b62b28ae9255799cc9`；数值方程/配置实际运行源仍为`ff818ccb35daf8d70d0cbafbf28fc6690ab457a8`，未因恢复归档而改写模型或重称新数值运行。

恢复后实际重跑Python独立复核PASS；7场景最大能量相对残差1.4539e-13，与SciPy温度差0.002916K；归档完整性检查PASS，记录于`results/m2/delivery_checks.json`。56个新增证据文件按有限结果归档方案保存，最大MAT约13MB；源码、原始未知量及M0/M1固定文件未改。当前PR #3仍待研究者批准；M2未合并、无正式Tag，M3未开始。本行在证据提交后的登记提交加入，不将证据SHA误称已验收main版本。

## M2正式验收授权（2026-10-20）

研究者已按“具有明确工程假设、通过能量守恒及数值验证的概念瞬态热网络模型”批准M2、PR #3合并和M2-v1.0附注Tag。真实几何、热阻、换热及温度标定仍未完成，见reports/M2_GATE_ACCEPTANCE_2026-10-20.md。本轮独立复核再次PASS；报告仅更新批准口径，数值方程和候选参数未改。只有远端Tag实际核验成功后才开展M3，实际合并SHA/Tag对象在后续登记，不覆盖M0/M1。本段之前PENDING描述与运行JSON是历史快照。

## M2远端归档核验及M3启动

实际合并提交`1d51c22d94577ff8f52be785300b5f6b4aadee37`，远端M2-v1.0附注Tag对象`4ad89c4a220174de741b4ba48706279d3b7cb2d1`，剥离目标与合并提交一致。M0/M1原Tag对象及目标不变。M3分支stage/M3-geometry从该最新main创建；本登记属于后续M3提交，不移动M2 Tag以包含后续登记。M3只做几何与热参数候选，禁止提前运行M4 ANSYS/Fluent或声称降温效果。

## M3概念几何送审（2026-10-20）

实际CadQuery2.8.0/OpenCascade7.9.3.1生成源`3ea9c6bd2af2cde56d17c1ce5f56ba446813477b`；4装配32/36/40/36命名部件与连通空气域、共同零件及新增结构共56 STEP，有限总量约78MB。有效Brep及回读体积误差约1e-13；283对无>0.001mm³交叠；8组回归/18齿轮相位PASS；2187解析组合中729拒绝，25mm紧凑包络实际触发干涉。原始失败/修复日志保留。

报告9页、21个可编辑数学对象、5幅图，Word导出PDF并逐页检查PASS；M2固定文件无差异。热阻/热容/视角仅新候选，未重算M2温度、不声称降温。45mm轴余量小，40mm拒绝；轴向定位、花键、壳体分型、轴承寿命/密封、预紧/防滑、车辆包络和真实冷却仍缺。M3等待研究者验收，不合并、不创建正式Tag、不开展M4。完整证据SHA后续登记，避免自引用。

M3完整证据提交：`0dc265e7329870c92e849abe89fb9c2d12378c77`，已推送；包括56 STEP、144行质量/C、283对干涉、2187解析范围、CSV/JSON/图和三格式报告。独立交付检查PASS，另逐一读取该提交的110个源/成果Git blob核对保存的SHA-256，全部一致，STEP原始字节未被Git换行转换。后续登记不改CAD几何，不把该证据SHA冒充main或正式M3版本。最终批准状态PENDING；PR #4保持草稿。

## M3几何正确性复核与有限元前精化（2026-10-20）

继续`stage/M3-geometry`及[PR #4](https://github.com/alan9900/Thermal-coupling-analysis-under-drive-control-integration/pull/4)。状态**PARTIAL_WITH_BLOCKED_ITEMS**，不是M3正式验收；Tag **NOT CREATED**，M4/ANSYS/Fluent **NOT EXECUTED**。原`cad/m3`、`scripts/m3`、`results/m3`和原M3报告均保留，M2-v1.0固定文件不变。

最终几何生成由提交`700edf045c03ea63ed27e197e2020048ceb98995`启动；后续断言/参数元数据和审查文档更新未改变几何，当前源对所有Case0部件体积回归通过。旧生成器在写结果时取HEAD的问题已用独立launch/result-write字段纠正，未伪称重新运行CAD。提交`c4aace5`补充罩支点差动热膨胀BLOCKED及未来导入清单；本轮完整证据SHA在之后登记，避免自引用。

交付`cad/m3_review`：10份完整/热装配（4方案50mm及Case0的45mm对照）、5份局部连通空气域及共同零件，共144 STEP约152.5MB；全对筛选后3686对精确布尔无>0.001mm³交叠，最大回读误差2.28e-13；16组审查、18啮合相位、24盘/钳旋转配对通过。测试通过表示审查正确，不把失败工况当通过。50mm驱动Kt2约162.34MPa，45mm约222.74MPa（180MPa阈值为S3）；0.6g/0.8g零再生单盘752.839/911.057N·m。

补充报告`reports/M3_geometry_review.md/.docx/.pdf`：9页、8个可编辑OMML公式、7幅真实CAD/工程图，Pandoc转换与Word导出后逐页视觉检查PASS。配置/接口`configs/m3_geometry_review.yaml`、`configs/M3_to_M4_mapping.json`；结果和测试`results/m3_review`；补充验收表`reports/M3_GEOMETRY_REVIEW_CHECKLIST.md`；未来几何准备清单`docs/M4_GEOMETRY_IMPORT_PREPARATION.md`。

轴承装入问题改为可拆套候选，但传扭/热松脱、预紧防滑、局部凸台/疲劳/位移、端部绝缘、滚动接触与油膜、冷却端口和装车包络仍BLOCKED。罩300K/箱100K差动膨胀约0.406mm超过0.2mm孔隙，需滑移/柔性支点复审。允许作为ANSYS导入候选，不等于可直接做可信样机温度或优化结论。原始未知值保持null，未修改旧Tag、合并M3或进入M4。

本轮完整精化证据提交：`40c95c1a1eb9de5584e899df70ec887cce9488a6`，已推送并核对远端分支。其交付清单222个文件逐一读取实际Git blob核对SHA256全部通过，含144 STEP与三格式报告，见`results/m3_review/git_blob_checks.json`。后续只追加核验记录、登记及针对CR行尾的Git检查属性，不重写证据提交。远端main仍为M2合并`1d51c22d94577ff8f52be785300b5f6b4aadee37`；M0/M1/M2原附注Tag对象及剥离目标不变，M3-v1.0不存在。PR #4待复核，BLOCKED条件继续有效。

### 用户提出输出大齿轮疑似干涉后的复核

2026-10-20实际在本机SolidWorks2023打开Case0_d50_full并完成装配干涉检测，129叶零件、未忽略隐藏体，结果0。OCCT原齿轮对前/后壳体交集均0，最短距离18.646322/10mm；半径93mm完整360°扫掠包络亦无干涉，齿顶至内底壁径向留11mm；26个旋转/箱体配对通过。只调整观察显示，未修改CAD尺寸或零件位置。

见`reports/M3_OUTPUT_GEAR_CLEARANCE_RECHECK.md`及`results/m3_review/output_gear_clearance/`，带尺寸真实截面和独立运行脚本已归档。旧报告中SolidWorks未执行属历史交付快照；此次后续确已执行，不改写历史报告。其余机械/热边界BLOCKED继续有效，M3未合并/无正式Tag，M4未开展。

专项复核完整证据提交`4e02ef6b544d6c336ca12e6623d5a46b98b93b05`已推送至同一开发分支/PR #4，含原STEP哈希、旋转/扫掠布尔与距离、实际SolidWorks导入位置/检测记录和显示截图。此处后续追加准确证据SHA，不移动旧Tag或修改归档模型。

## M3两级斜齿限定修订（2026-10-20，待审核）

版本`m3-helical-concept-1.0-draft`；分支`stage/M3-geometry`；[PR #4](https://github.com/alan9900/Thermal-coupling-analysis-under-drive-control-integration/pull/4)。**本轮PASS_CONCEPT_GEOMETRY，M3整体PARTIAL；未批准合并，正式M3 Tag NOT CREATED；M4/ANSYS/Fluent NOT EXECUTED。**

只将原两级直齿改为真实螺旋扫掠斜齿，保持三轴坐标、100/120mm中心距、20/60齿、9.0、50mm输出轴及原轴承/壳体/电机/制动器/Case0/A/B/C。端面模数2.5/3.0mm固定，20°螺旋角，法向模数2.34923155/2.81907786mm为非标准概念值；原端面20°压力角及全齿高保留，非标准法向刀具设计。小齿轮RH、大齿轮LH，齿宽中面对相；33–58/95–127mm及中间37mm间隔保持。

CAD启动源`225c1a217c1983fa3b654bf26c6d1365906382e7`；主体模型/报告证据`18dee1a5d66b40ba34d0e26dc993f1270d3ec970`；映射字节保真提交`5ddb4db7da89c4f4179da42ca4517416c3eec8f2`。最终含全部18STEP回读测试的验收证据快照 **`3e26ee8ae1864135fe0427904b71f4bce28726c4`**，66个实际Git blob逐一SHA256核验通过，见`results/m3_helical/git_blob_checks.json`。后续登记提交不移动该快照或旧Tag。

实际CadQuery2.8.0/OCCT7.9.3.1执行：8装配+10修订零件STEP约145.6MB；3006对AABB后精确布尔无>0.001mm³交叠；8装配回读最大相对体积误差6.25e-13，10零件回读最大2.55e-13。四真实B-rep边反算±20°、端面齿数20/60、14对旋转啮合通过；124个未改部件位置核对、541项逐体热容一致性通过，热版最大相对热容差1.80e-10。报告6页，5个可编辑OMML公式/5图，实际Word导出PDF并逐页视觉检查PASS。初次并行汇总及文档转换失败记录保留。

成果：`cad/m3_helical/`、`scripts/m3_helical/`、`configs/m3_helical.yaml`、独立`configs/M3_helical_to_M4_mapping.json`、`results/m3_helical/`、`reports/M3_helical_revision.md/.docx/.pdf`、`reports/M3_HELICAL_CHECKLIST.md`；公开来源PDF与SHA位于`data/raw/m3_helical/`。原直齿、原M3映射和M2固定成果均未覆盖。M1损耗暂沿用，斜齿效率和轴向载荷附加损耗未重标定；真实接触/冷却null不变，不声称提高效率或降低温度。

限定轴向力检查：130Nm输入下一级/二级约1.893/4.732kN，当前旋向使中间轴推力相加约6.624kN，反拖符号反转；轴承轴向承载、定位与旧连接套/罩支点/热接触/冷却等仍BLOCKED。本轮没有扩展疲劳、制造、预紧或热膨胀优化。M0/M1/M2原附注Tag及目标和main `1d51c22d94577ff8f52be785300b5f6b4aadee37`已核对不变；无M3正式Tag。

## M3正式批准（2026-10-21）

研究者已批准限定概念模型验收并授权合并PR #4、创建M3-v1.0。最终复核见reports/M3_APPROVED_SCOPE_2026-10-21.md：66个Git blob重新SHA256通过；18 STEP及源码、参数、报告、图、测试证据齐备。验收不包括机械安全、疲劳/制造认证或真实温度标定；轴向承载、连接套、接触与冷却等限制继续保留。Tag将在实际合并提交上创建，准确合并SHA在归档成功后追加，不移动旧版本。

## M3-v1.0远程归档成功（2026-10-21）

PR #4已按研究者授权合并；main合并SHA `7a6b9b1512495283fa12dd4a2a7ffdf698554d3e`。正式附注Tag `M3-v1.0` 对象 `c958ec76330c016e0dc3f8ca141f2b139f6c53f3`，远程剥离目标经git ls-remote核验为上述合并提交。此前M0/M1/M2标签未改动。验收范围和限制见reports/M3_APPROVED_SCOPE_2026-10-21.md，历史PARTIAL/BLOCKED记录不抹除。本段为归档后的登记，Tag保持指向实际验收合并提交。

M4已获开发授权，从上述最新main创建stage/M4-ansys，仅先开展Case0。M4未经批准不合并、不创建M4-v1.0、不进入M5。

## M4开发记录（2026-10-21，未验收）

分支`stage/M4-ansys`，草稿[PR #5](https://github.com/alan9900/Thermal-coupling-analysis-under-drive-control-integration/pull/5)，状态PARTIAL / IN PROGRESS，无M4正式Tag。输入与网格启动证据`72332cd`、热边界复核`e4e281d`、接触面及储热积分`1492340`、首次完整原生热平衡证据`5da3d22`均已推送。后续细化提交以PR记录为准，不覆盖原阶段版本。

实际运行ANSYS2024R1：导入129部件/131实体；保留28组/30实体；粗网格332431实体单元/88049实体节点。后续明确面接触版本Mechanical实际报告Solved；初次整零件接触版本发生结果转移失败，保留SolveFailed记录并独立恢复原生46时刻RTH。首次诊断热平衡最大相对残差约9.81e-6（0.000981%），但这不代表网格/时间步独立性通过。摩擦片初始自动扫掠仅一层，已拒绝将面内加密当作厚度收敛，正在执行明确6/12/24层的细化。

成果入口`docs/M4_RUNBOOK.md`，源码`scripts/m4`，配置`configs/m4_case0.json`及`configs/M4_materials.xml`，证据`results/m4`。原生模型压缩输入位于`results/m4/model_input`，大体积RTH及Workbench项目留在文档登记的本地运行目录并记录校验和。全部温度为S3概念预测；真实接触、冷却、材料温变及温度标定未完成。不得用前处理12组PASS或单元基准算例代替M4整体数值验证。

### M4细化验证进展（2026-10-21，未验收）

已推送证据提交 `099e84a57b63c6bca9750206e0b47a5daa8e93b8`：三套35.2/43.9/81.8万实体单元实际网格，原生默认形状检查0错误限值单元、493/494/500警告；全部28区域中/细网格温差通过工程阈值；三个独立辐射面简化检查通过。时间步及剩余敏感性仍在运行，不提前判为阶段通过。

报告 `reports/M4_report.md`，验收表 `reports/M4_ACCEPTANCE_CHECKLIST.md`，状态自动证据 `results/m4/acceptance_checks.json`。一层摩擦片峰值已拒绝；局部低于初值的数值欠冲原样保留；安装链TCC扫描不覆盖全部电机内部/油膜与材料不确定性。真实标定仍PARTIAL；无M4正式Tag，PR #5保持草稿，不进入M5。后续追加准确完整交付SHA，不把本登记当成正式验收版本。

### M4暂停总结交付（2026-10-22，PARTIAL，未验收）

成果提交 `d3945de9c7963b0794095f6a8e1c9dd09b0f9faf`；分支 `stage/M4-ansys`，草稿 [PR #5](https://github.com/alan9900/Thermal-coupling-analysis-under-drive-control-integration/pull/5)。按研究者要求暂停进一步研究，队列及剩余两个原生求解已停止，未完成结果不计通过。没有合并M4、创建M4正式Tag或进入M5；M0–M3归档版本未覆盖。

已完成A中网格重试、C/D多热源场与热流、B两档时间步及局部网格细化；C/D整体热平衡最大相对残差约0.001957%/0.000507%。同网格C−A电驱储热增量55.344 J，增量收支最大残差0.019954%；不是完整热空气耦合或温度标定。空间细化主要覆盖制动盘/片，不能宣称内部热源全部空间误差已验证。

Word/PDF报告均来自Markdown；实际Word渲染9页，10个可编辑公式、7幅图，逐页视觉检查通过并登记文件哈希。报告：[Markdown](../reports/M4_report.md)、[Word](../reports/M4_report.docx)、[PDF](../reports/M4_report.pdf)；验收表：[M4_ACCEPTANCE_CHECKLIST.md](../reports/M4_ACCEPTANCE_CHECKLIST.md)。尚缺三档时间步闭合、完整接触/冷却敏感性及内部发热工况全面空间验证；详见 `results/m4/acceptance_checks.json` 和 `results/m4/attempts/user_requested_pause_20261022.json`。大容量原生结果仅本地保留并登记SHA256，未宣称全部上传。

### M4云图逐图讲解补充交付（2026-10-22）

成果提交 `bcf0e6377a84eef96ef7d82d49485bed40be1f5b`，继续使用 `stage/M4-ansys` 和草稿PR #5。将已有D预热后制动结果导出为29幅原生云图（整体1幅、部件28幅），不新增求解。保存截图、输出时刻、温度范围、来源哈希及导出宏至 `results/m4/contour_captures/`。

图册为 [M4_contour_explained.docx](../reports/M4_contour_explained.docx)，保留Markdown源稿与PDF。Pandoc生成Word后，通过实际Word渲染检查30页、29幅图，逐页视觉检查通过；证据 `results/m4/contour_captures/document_checks.json`。整体图采用76.7535 s同步状态，各部件采用各自记录峰值时刻，分别注明独立色标及S3假设。M4仍为PARTIAL且暂停新增研究，未合并、未创建正式Tag、未进入M5。

### 后续无再生制动工作计划调整（2026-10-22）

研究者明确决定后续仿真等工作暂不考虑再生制动，以电机内部热源、摩擦制动热及各部件热耦合为主线。计划版本 `no-regen-plan-1.0`，见 [NO_REGEN_WORK_PLAN.md](NO_REGEN_WORK_PLAN.md)。本轮仅授权调整计划与更新GitHub，继续使用 `stage/M4-ansys` 和草稿PR #5；未授权恢复模型实施、生成新热源或运行MATLAB/ANSYS/Fluent/优化。

后续顺序为：独立零再生M1派生时序与整车能量检查→相同工况M2对照→Case0单次及驱动预热后零再生制动→网格、时间步及热源/接触/冷却不确定性→匹配热源归因与重复零再生制动→M4验收。重点为盘、轴承、油液、壳体、定子和绕组的最高/平均温度、峰值时刻及制动附加温升。M5—M7后续亦使用零再生边界并等待各阶段授权。

旧B时间步重试和C接触/冷却队列不再作为默认续算任务；旧30kW再生限制下的53.25°C盘峰值和云图继续保留其历史含义，不改名为零再生结果。模型源码、运行配置、CAD、原始数据、结果及三格式报告未改动；M0—M3标签保持不变，无M4正式Tag。本轮验证限于Markdown链接、计划入口/授权一致性、Git差异及历史文件保护，不把文档检查称为模型测试通过。计划提交SHA在后续登记中追加。

本地准备提交为 `f55509692bb1781a67eabb0f60739188b9e5b0e0`，共8份Markdown文档；Git传输中断后改用GitHub连接器发布相同计划，远程证据SHA在随后登记追加。95个本地链接存在性检查及文档限定范围检查通过，`configs/scripts/cad/data/results/reports`与本轮开始时一致。本登记只追加证据SHA，不修改任何阶段Tag或正式验收状态；PR仍为#5草稿。

GitHub连接器发布的计划证据提交为 `b82976de96d98d493097cdbf60bb5ed6437743fa`，父提交为原远端 `602e72e34301bd2ae27c0c7abde84e27c06ea863`；只包含上述文档变更，原本地准备提交另保留备份引用。此处登记不构成M4验收或恢复仿真授权。

### 项目总结与创新评估报告（2026-10-22）

按研究者要求交付 [项目总结Word](../reports/PROJECT_REVIEW_AND_NEXT_PLAN.docx)，保留[Markdown](../reports/PROJECT_REVIEW_AND_NEXT_PLAN.md)及PDF归档。总结M0—M4已完成工作、测试及限定验收，区分旧含再生结果与未来零再生计划；有限核对5项相关原始研究，明确潜在贡献尚未充分验证，不作全球首创、性能提升或实物标定声明。

报告实际Word渲染10页，3个可编辑公式、2幅既有图、8张表，逐页视觉检查通过。源文件哈希和审阅记录在 `reports/project_review_evidence/`；格式化工具 `scripts/reporting/format_project_review.py`仅用于文档。本轮没有启动仿真或修改模型/既有阶段成果，M4仍PARTIAL且暂停，PR #5保持草稿，无正式M4 Tag。准确交付提交SHA在随后登记追加。

总结报告交付证据提交为 `1bec72d63a3e39b238979758ccded62ddbea34e1`，已推送至同一M4分支；Word/PDF/Markdown及当前哈希检查记录齐备。本登记追加提交SHA，不修改报告证据快照、阶段标签或暂停状态。

### M4存储清理：先保留核心结果，再删除原生模型（2026-10-23）

研究者明确授权保存现有核心结果后删除占空间的ANSYS模型文件。归档前核验29张原生云图、9份三格式报告文件及4个精确执行输入包；独立ZIP逐成员回读SHA256/大小通过，共1934个成员。归档准备及删除清单证据提交为`863e78a`；[完整记录](M4_STORAGE_CLEANUP.md)、[归档凭证](../results/m4/storage_cleanup_20261023/archive_verification.json)、[实际删除回执](../results/m4/storage_cleanup_20261023/deletion_receipt.json)。最终清理证据提交在PR及Git日志中登记。

本地归档`E:/ansys_runs_archives/M4_core_results_20261023.zip`，391,664,998字节，SHA256 `444e0f781eb2b5f8fd13935e6b254f4923e65ec905b233390d8eb43acffbf067`；未声称上传该ZIP。删除五个已核对的本项目原生工程/完整场/缓存目录，共1028个文件、逻辑大小156.27 GiB，E盘实测空闲增加约106.07 GiB。原有Git受控文件、报告、29张云图、温度与热流时序、选定场子集、CAD、可复算输入、代码和M0—M3标签均保留。

删除的完整RTH与Workbench工程不在ZIP内，后续任意时刻完整三维场浏览需重新求解。旧清单中的原生路径和哈希继续作为历史记录，不代表文件仍存在。历史结果保留30kW再生限制的工况含义，未改名为零再生；本次不运行仿真、不改变模型及验收状态。M4仍PARTIAL且暂停，分支`stage/M4-ansys`、草稿PR #5，不合并、不打M4正式Tag、不进入M5。

最终清理成果提交为`76f928af63000c4ac89eecc65367adea685bfac9`，已推送原M4开发分支；包含实际删除回执、140行既有场景/部件峰值索引、最终保护/链接检查和当前存储状态说明。此次Git版本仅登记维护证据，不表示M4正式验收，未创建或移动任何阶段Tag。

### M4 P1-A 零再生单次制动热源（2026-10-23，专项交付待审）

研究者明确授权仅实施P1-A。基线`9eb27e074ce218da9843e241ea7e4cf21f49819b`，分支`stage/M4-ansys`、草稿[PR #5](https://github.com/alan9900/Thermal-coupling-analysis-under-drive-control-integration/pull/5)；本节与本轮成果在同一个聚焦提交中，准确交付SHA由该提交Git记录及PR登记。本项不是M4正式验收版本，没有创建、移动或删除任何Tag。

独立配置`configs/m4_no_regen_brake_baseline.json`，场景`M4_P1A_NR_SINGLE_80KMH_06G_CASE0`。复用原M1接口，实际MATLAB R2025a单次运行生成80→0 km/h、0.6g、左右零再生、含风阻滚阻的190点制动时序；配置步长0.02 s，实际端点对齐步长0.0199758571790134 s，总时长3.77543700683354 s。数据保存在`results/m4/no_regen_baseline/`，报告[M4_NO_REGEN_BASELINE.md](../reports/M4_NO_REGEN_BASELINE.md)。

独立Python14组审计及5项故障拒绝通过；最大点功率残差9.3132e-10 W，最大累计能量残差1.9791e-9 J/4.4529e-15；解析路阻功与梯形积分另差0.110292 J/初始动能2.4816e-7，均满足运行前登记标准。每侧接触摩擦能92.937867 kJ，盘/片名义83.644080/9.293787 kJ，前轴245.739973 kJ，路阻12.828738 kJ。1404个既有受控文件及阶段标签引用保护检查通过，M0—M3与旧M4 studies未覆盖。

校准绕组NaN/null保留，电机和减速器零损耗预算仅为未知拖曳/空载项省略近似，不称实测零损耗。未运行run_m1/run_m1_sources、ANSYS、Fluent、M2温度、预热、冷却、重复制动或优化。M4仍PARTIAL，PR保持草稿；P1-A完成后停止，等待研究者审查和下一条执行命令。

### M4 P2-A 单侧M2源项输入适配与独立预检（2026-10-23，专项交付待审）

研究者仅授权输入适配和预检。父基线为P1-A交付`1db75d9f7cf58560b8ee01d444e2160a72d3545e`，分支`stage/M4-ansys`、草稿[PR #5](https://github.com/alan9900/Thermal-coupling-analysis-under-drive-control-integration/pull/5)；本节与P2-A成果同一聚焦提交，准确交付SHA由该Git提交和PR登记，不构成M4正式版本。

配置`configs/m4_no_regen_m2_baseline.json`，场景`M4_P2A_NR_SINGLE_80KMH_06G_M2_INPUT`，报告[M4_NO_REGEN_M2_PREFLIGHT.md](../reports/M4_NO_REGEN_M2_PREFLIGHT.md)。只加载P1-A左侧热量，右侧核对对称；原M2最大步长0.25 s，原积分核端点对齐后16区间/实际0.235964812927096 s，总3.77543700683354 s。输出`results/m4/no_regen_m2_baseline/`，含CSV/JSON、f输入MAT、13节点及映射快照、逐项积分审计和日志。

实际MATLAB R2025a输入准备、MAT回读及Python12组独立预检通过，11项故障拒绝通过；最大源项积分差1.4552e-11 J，相对1.7397e-16，最大分项功率闭合残差2.2919e-10 W，运行前阈值分别1e-6 J/1e-6相对/1e-7 W。1424个既有文件及阶段标签引用未变，P1-A及M0—M3/旧M4 studies未覆盖。

预期源项掩码`[0,0,1]`，逆变器在热域外，校准绕组NaN/null保留，空载损耗仍未知；M2原护罩节点未修改，不声称已成为Case0无护罩网络。调用记录证明未运行run_m2/m2_simulate/m2_flux/m2_export，没有温度、预热、冷却、重复循环、ANSYS/Fluent或优化结果。P2-A完成后停止；M4仍PARTIAL，不合并、不创建M4-v1.0、不进入M5。
