alan9900/Thermal-coupling-analysis-under-drive-control-integration/docs/RESEARCH_PLAN.md

> **V0.4权威架构提示（2026-10-18）**：本文件编写于更早的前驱/中央电驱方案，涉及 `front`、中央电机、差速器、前轴制动盘转矩的具体数值或指令已失效。当前方案为**后驱双独立电机**（每侧参考60kW/207Nm/13500rpm，研究软件限扭130Nm）、**每侧9.0独立减速器和内移盘**、**只分析单侧热场**。必须优先以 [V0.4权威研究说明](REAR_DRIVE_V04_SOURCED_BASELINE.md) 与 [当前配置](../configs/baseline_vehicle.yaml) 为准。以下仅保留通用方法及历史追溯；Codex不可执行与V0.4冲突的旧架构说明。

> **V0.3 架构变更通知（2026-10-18，必须先读）**：本文件原编写于“中央单电机+机械差速器+左右输出盘”阶段，其中**具体机械拓扑、单电机120 kW/260 N·m与差速器相关指令均已失效**。现行方案为左右各一台60kW/130N·m独立电机及9.0减速器、每侧输出端内移盘、**无差速器**、只分析单侧详细热场。现行权威资料为 [V0.3架构](DUAL_MOTOR_V03_ARCHITECTURE.md) 和 [V0.3配置](../configs/baseline_vehicle.yaml)。以下保留作为方法论/变更历史参考，Codex不得照搬失效指令。

# 详细研究计划 V1.0

**当前计划入口（2026-10-22）**：[无再生制动热耦合研究工作计划](NO_REGEN_WORK_PLAN.md)。本文件主体为历史方法资料，旧机械拓扑、再生工况扫描及周数估计均不作为当前执行安排。后续聚焦零再生时电机—减速器—内移制动器热耦合；本轮仅更新计划，未恢复仿真。

## 1. 研究定位与物理对象
拟题：**内移式制动器与电驱动总成多热源热耦合机理及定向隔热导流结构优化研究**。
构型：前驱单电机→减速齿轮→差速器→左右输出半轴，两个摩擦制动盘分别安装在减速器两侧输出端；制动钳独立操纵，保留后轴常规制动。驱动电机邻接减速器。若后期明确为后驱，则重算轴荷与制动分配。
**边界：**只对这套前轴总成进行详细三维热场建模；后轴用纵向动力学与能量分配表示。新结构优先选择制动盘靠壳体一侧的**隔热导流罩**。水套/油液采用已有边界，不另开发高风险的水冷制动盘，PCM作为后续探索而非首期主线。

## 2. 文献借鉴与差异
Park et al., Energy Conversion and Management 325 (2025) 119406, DOI:10.1016/j.enconman.2024.119406：轮边EMB执行电机受摩擦制动热和局部绕组发热影响，研究热沉+隔热+PCM；其研究方法（热源分解→瞬态计算→对照组→极端工况与材料敏感性→验证）可借鉴。不能照搬其12.5V/50A小型执行电机、145°C线圈限值或在不同几何下忽略辐射的假定。本项目热源为制动摩擦、电驱主电机损耗、齿轮与轴承损耗，辐射、盘周空气流动、输出轴接触导热均需检验。

## 3. 研究假设与机理假说（需要验证）
H1：内移制动盘与壳体距离缩短时，制动辐射+热空气对流与通过轮毂/半轴/轴承固体导热均可能增大壳体热负荷，主导路径随速度/间距/温度改变。
H2：完全封闭隔热可以保护电驱，但可能降低制动盘散热；有合理进出口的定向隔热导流罩存在性能权衡最优区域。
H3：高负载预热后连续制动时，电驱内部损耗与外部摩擦热叠加可能引起最不利热点；再生比例变化会重新分配摩擦盘与电机热源。以上为**待检验假说**，不预设方向与降温幅度。

## 4. 数学模型设计
### 4.1 动力学和热源 M1
车辆：`m_eff*dv/dt = F_drive - F_brake - F_drag - F_roll - mg*sin(grade)`，旋转惯量未知时先设 `m_eff≈m` 并估计误差。动态前轴法向载荷（平路减速，加速度绝对值a）`N_front≈m*g*f_front_static + m*a*h_cg/L`，后轴为总重减前轴，且轮胎附着限制 `|F_x,axle|<=mu_tire*N_axle`。
总制动需求 `T_req_wheel=F_brake*r_w`，明确左右分配。每侧差速器后制动盘 `omega_rotor≈omega_wheel`，不是 `9*omega_wheel`。电机 `omega_motor≈i_total*omega_wheel`（忽略车轮左右速差）。
前轴车轮制动力矩：`T_front_req=T_regen_at_wheel+T_friction_front`。受电机电磁转矩极限、机械转速、逆变器限制、电池可接受功率/SOC及轮胎附着制约。再生能量与效率独立于牵引效率。左右盘的摩擦发热 `P_fric,left/right=T_fric,left/right*omega_rotor,left/right`。使用盘/片热分配系数并检查 `E_kinetic + potential - losses = E_regen_battery + E_friction + E_other_losses`。
电机损耗：驱动 `P_elec,in-P_mech,out`，再生 `P_mech,in-P_elec,out`；缺 MAP 时仅做参数扫描/代理假设，明确 C/D 级。减速器热源用正向及反拖功率差与相关损耗映射计算，避免重复扣减。
### 4.2 热网络 M2
节点至少包括：左盘、左钳/片、左输出轴、左侧轴承/壳体、减速器油液、齿轮、主壳体、驱动电机定子/绕组、转子/永磁体、右盘/钳/片/轴承、护罩和环境；可先创建合并节点简化，再逐步增加。每节点 `C_i*dT_i/dt=Q_gen_i+ΣG_ij(T_j-T_i)-Q_cool_i + Q_rad_i`；辐射 `q=epsilon_eff*sigma*A*F*(T_hot,K^4-T_cold,K^4)`，使用 K 与视角系数、遮挡面积；对流 `q=h(v,omega,T)*A*(T_surface-T_air)`；导热用 `R_cond+R_contact`。所有热容、阻抗、温变物性必须登记。
双向耦合：盘对电驱可能加热，电驱/护罩亦会影响盘散热；热阻/空气温度不应无依据固定为“盘越热、电机固定吸收 x%”。
### 4.3 三维热计算 M4/M5
M4：CAD简化盘/轴/壳体/水套等效热边界，ANSYS Mechanical瞬态导热+表面对表面辐射；先以h范围表征盘风冷，对比无护罩/单层/双层。
M5：采用局部 Fluent 辐射+流场/共轭传热，研究进出口与旋转诱导气流。稳态MRF辅助提取h与热流分配，典型工况做瞬态交叉检查；不能把MRF稳态直接宣称为全程真实制动瞬态。需要验证自然/强制对流和辐射贡献；留意旋转半轴与密封。
### 4.4 定向隔热导流结构
Case0 无新护罩；CaseA 单层隔热罩；CaseB 双层带通风间隙；CaseC 隔热罩+定向进/出口；CaseD CaseC 优化后的参数。必须控制比较时的相同制动热输入、同环境、相同壳体/水套边界及相同材料。
初始设计变量 `x=[gap,shield_thickness,duct_exit_angle,outlet_area_ratio]`，探索范围分别 `[3,10]mm,[0.5,2]mm,[15,60]deg,[0.2,0.8]`，在CAD干涉、制动盘热膨胀、材料、支架结构约束后才能冻结。记录护罩可能增大制动盘温度的权衡。
### 4.5 优化 M6
目标候选：`min(T_winding_peak, T_magnet_peak, T_gearbox_oil_peak, T_brake_disc_peak, shield_added_mass)`，建议筛成2–3个主目标，其他为硬约束，以控制样本需求。可引入 **制动热侵入累计正向能量** `E_in=∫max(q_brake→drive,0)dt` 作为解释指标。温限需由目标部件资料确认，不能照搬EMB执行电机温限。
设计试验：约30–50组LHS仅作初步探索，不保证足够；低成本热计算筛选→Kriging/RBF代理拟合→交叉验证/独立测试→NSGA-II Pareto→代表性解ANSYS/Fluent复算→扩样至误差收敛。不得把代理预测值当有限元验证值。
### 4.6 多工况 M7
C1 单次中等减速；C2 重复高速摩擦制动（考虑冷却间歇）；C3 **高负载牵引预热后重复制动**（主工况）；C4 电池高SOC/低温等再生受限；C5 左右不对称制动/不同环境作为鲁棒性可选项。各工况输入速度-时间、轴荷及制动力分配、再生限制、盘/片热量、预热初温、环境/风速/流量。报告失效边界而不只展示成功工况。

## 5. 建议输出
图01总成拓扑与关键间距；图02整车速度/制动力/再生转矩；图03三热源时间历程；图04热网络及热流桑基/矩阵；图05基准温度场；图06辐射/对流/轴导热贡献；图07各方案温度曲线；图08隔热与制动盘升温权衡；图09敏感性/响应面；图10 Pareto；图11高负载后连续制动鲁棒性；图12参数不确定性影响。表：参数及来源、网格无关性、试验矩阵、性能对比、误差预算。

## 6. 计划进度（按工作量调整）
第1–2周M0；第3–5周M1；第6–8周M2；第9–12周M3/M4初版；第13–17周M4/M5；第18–21周M6；第22–24周M7及论文材料。若CFD算力紧张则减少CFD方案数量、优先完成M1/M2/M4+优化的闭环。
