alan9900/Thermal-coupling-analysis-under-drive-control-integration/docs/PARAMETER_REGISTER.md

> **V0.4权威架构提示（2026-10-18）**：本文件编写于更早的前驱/中央电驱方案，涉及 `front`、中央电机、差速器、前轴制动盘转矩的具体数值或指令已失效。当前方案为**后驱双独立电机**（每侧参考60kW/207Nm/13500rpm，研究软件限扭130Nm）、**每侧9.0独立减速器和内移盘**、**只分析单侧热场**。必须优先以 [V0.4权威研究说明](REAR_DRIVE_V04_SOURCED_BASELINE.md) 与 [当前配置](../configs/baseline_vehicle.yaml) 为准。以下仅保留通用方法及历史追溯；Codex不可执行与V0.4冲突的旧架构说明。

> **V0.3 架构变更通知（2026-10-18，必须先读）**：本文件原编写于“中央单电机+机械差速器+左右输出盘”阶段，其中**具体机械拓扑、单电机120 kW/260 N·m与差速器相关指令均已失效**。现行方案为左右各一台60kW/130N·m独立电机及9.0减速器、每侧输出端内移盘、**无差速器**、只分析单侧详细热场。现行权威资料为 [V0.3架构](DUAL_MOTOR_V03_ARCHITECTURE.md) 和 [V0.3配置](../configs/baseline_vehicle.yaml)。以下保留作为方法论/变更历史参考，Codex不得照搬失效指令。

# 参数登记与未知项（2026-10-18，V0.1）

## 结论
**应尽早指定一辆实际应用车型或一套自洽的概念车参数**。否则可以计算演示工况，但不能得到可验证的温度和结构最优值。现使用前轴单电机+差速器+左右输出轴摩擦盘，保留后轴常规制动。数值仅为假设。

## P0 关键参数：优先补齐
| 组 | 待确认输入 | 缺失的影响 | 当前状态/办法 |
|---|---|---|---|
| 车辆 | 轴别、质量（整备/满载）、轴距、轮距、前后轴荷、重心高度、轮胎有效半径 | 制动力与动态轴荷失真 | 暂设前驱、1800 kg、2.8 m、55%静前轴、重心0.55m、轮胎0.32m |
| 电机 | 额定/峰值功率与转矩、最高转速、转矩-转速曲线、驱动及再生效率/损耗MAP | 电机损耗、再生上限不可信 | 暂设峰值120kW/260N·m；MAP未知 |
| 减速器 | 总速比、各级速比、效率/损耗、差速器输出几何、轴承/油液状态 | 齿轮发热与转速错误 | 暂设总速比9；实际损耗未知 |
| 制动器 | 左右盘直径/厚度/质量/材质、摩擦有效半径、摩擦系数随温度变化、盘片热分配、卡钳可输出力矩 | 制动热流密度与安全性不可信 | 暂设外径280mm、厚22mm、μ0.40，其余未知 |
| 工况 | 100→0制动时间/减速度、轴间制动力分配、再生SOC/充电功率限制、重复次数 | 摩擦热与电机热负荷分配不确定 | 仅有100→0km/h示意 |
| 包装 | 盘到壳体间距、隔热罩空间、支架强度、制动盘热变形间隙 | 隔热导流结构不具备可制造性 | 未知 |
| 温限 | 绕组、永磁体、润滑油、制动盘/卡钳允许温度 | 不能定义优化约束 | 未知；严禁套用EMB论文145°C |
| 散热 | 冷却液入口温度及流量、水套几何、空气流场、发射率、接触热阻 | 不能可靠预测最高温度 | 未知 |

## P1 提升精度的参数
- 主电机各部件损耗分配、热容/热阻、铜电阻温变和磁钢温度。
- 变速箱齿轮/轴承/搅油损耗，润滑油热容与粘温关系，轴-轴承-壳体热阻。
- 制动盘的材料温变物性、对流系数-转速关系、辐射发射率、非均匀接触热流。
- 气流边界、环境温度、导流罩材料/表面处理、安装公差与热变形。
- 风险分析：制动安全冗余、差速器与输出半轴故障后的制动功能、密封件耐热。

## 参考计算，不是结果
1800kg, 100km/h → 0 的**整车平动动能**（忽略旋转惯量、空气阻力与滚阻）：
`E=0.5*m*(100/3.6)^2 ≈ 694.4 kJ`。
仅做示例，如果前轴分担65%的减速功、前轴没有再生，左右对称则**每侧摩擦接触产生**约225.7kJ；盘片热分配后只有部分热存入盘。不得把225.7kJ直接施加至电机或减速器。实际制动力分配需满足载荷转移和附着、EBD等约束。

## 来源等级与冻结
A：指定部件厂家/台架实测；B：相关公开数据；C：有解释的工程估算；D：仅流程调试合成。每个输入记录 id、值、单位、source URL/文献、日期、适用范围、状态、来源等级、不确定性范围和版本。

**Gate 0**：固定轴别/机械拓扑及初始质量、半径、轴荷、速比、盘布置，列出缺项。
**Gate 1**：完成动力学、再生/摩擦分配和能量平衡测试。
**Gate 2**：结构间隙、材料/温限及冷却边界得到来源或有范围包络，才允许定量热场比较。
**Gate 3**：代理模型误差验证且有限元复核之后，才能报告优化收益。

建议 Codex 生成 `results/parameter_audit.csv`，含字段 `id,priority,value,unit,status,source_grade,uncertainty,blocks_stage,action`。
