alan9900/Thermal-coupling-analysis-under-drive-control-integration/docs/BASELINE_V02_AUDIT.md

# V0.2 1800 kg概念车型参数自洽性审查
审查日期：2026-10-18。基础文件：`configs/baseline_vehicle.yaml`（v0.1）。**本文件为解析与建议；原始参数未被覆盖；所有新增量是工程探索假设，不是厂家数据。**

## 1. 总体结论
整车质量1800 kg、轮胎有效半径0.32 m、总传动比9.0、电机峰值120 kW/260 N·m、前轴两个直径280 mm输出端摩擦制动盘在代数上**不矛盾**；但不足以证明电机的实际峰值转速、制动器载荷能力、总成包络与热管理可行性。关键缺项是电机转速限值、驱动/再生损耗MAP、机械制动控制/卡钳容量、盘实际质量及材料、盘至壳体实测最小间隙、轴承/密封/冷却边界。

## 2. 可以复核的算例（只用于模型单元测试）
设m=1800 kg，r=0.32 m，i=9.0，h=0.55 m，L=2.8 m，静态前轴比λf0=0.55，峰值功率120 kW，峰值转矩260 Nm；忽略旋转惯量、空气阻力及滚阻。
- 100 km/h：v=27.7778 m/s；轮速829 rpm；电机转速7460 rpm；电机峰值功率约束下的扭矩上限 `120000/(7460*2*pi/60)=153.6 Nm`。**不得给此转速同时套用260 Nm**。
- 理想电机恒转矩与恒功率分界 `120000/260=461.54 rad/s=4407 rpm`；对应车速约59.1 km/h；它只是假设的分段外特性，真实T-n需要选型确认。
- 160 km/h：电机约11937 rpm。若设计最高速度160 km/h，最大机械转速需大于该值并留裕度；14000 rpm仅是候选假设，不能直接赋值为已验证。
- 峰值260 Nm时，假设减速器牵引效率0.96，轮端前轴合计扭矩 `260*9*.96=2246.4 Nm`，轮端驱动力约7020 N，相当于忽略阻力/附着限值时加速度0.398g。**此处是理想低速牵引校验，不代表制动能力或再生极限**。
- 100→0 km/h：车辆平动动能 `0.5*1800*(100/3.6)^2 = 694.44 kJ`；不要将其全部分给前轴摩擦盘。
- 平路减速动态前轴载荷比例 `λf=0.55+|a|*0.55/(g*2.8)`。按理想前后轴制动力同利用率分配（仅校核基线，非固定商用EBD算法）：

| 减速度 | 制动时间(s) | 制动距离(m) | 理想前轴比例 | 无再生、左右对称时单个前盘所需摩擦制动力矩(Nm) | 单盘接触摩擦总功(kJ) |
|---|---:|---:|---:|---:|---:|
| 0.3g | 9.44 | 131.1 | 0.6089 | 516 | 211.4 |
| 0.6g | 4.72 | 65.5 | 0.6679 | 1132 | 231.9 |
| 0.8g | 3.54 | 49.2 | 0.7071 | 1598 | 245.5 |

表中假设摩擦制动承担理想前轴全部制动力，**单盘摩擦接触热不等于盘储热或电驱吸热**。真实热分配必须包括摩擦片、制动盘、环境和输出轴等。
- 若以固定前轴65%做0.8g的示意，前轴动态载荷已为70.7%；后轴承担35%力但仅有29.3%法向载荷，对后轮要求的附着系数约0.956，可能在0.8附着系数路面先达到后轴限制。故`front_braking_fraction_demo_only=0.65`不能作为所有工况的控制律。
- 100km/h、0.6g、理想前轴66.8%时，前轴制动功率初值约196.6 kW，总制动需求初值约294.3 kW。**120kW牵引峰值不等于再生峰值，也不等于电池可吸收功率**。再生受转矩、转速、SOC、温度和充电能力共同限制。

## 3. 构型不可忽略的物理边界
- 制动盘固定在差速器**之后**的左右输出轴时，盘角速度=对应半轴/车轮角速度（如果无额外传动）；电机速度约=9×车轮平均速度。独立卡钳使左右摩擦制动可独立施加，但传动轴断裂、差速器故障、支架失效后的制动可用性不能仅凭拓扑证明。
- 280mm盘外径与22mm厚度不能确定质量、有效摩擦半径、制动片覆盖区或热容；卡钳夹紧力与强度暂不能校验。
- 制动盘到减速器壳体净距离**不等于**盘到隔热罩间距；后者在原配置中的3–10mm优化区间，须在前者确定、考虑热膨胀后才能确定。
- `drive_efficiency_assumption=0.96`与`regeneration_efficiency_assumption=0.96`只能作为减速器前期粗略损耗参数，且必须明确所属子系统，不能将其再次应用于电机损耗MAP导致重复扣减。
- 25°C初温只能代表冷态起步，不能代表高负载预热后制动的初温；后者由预热仿真继承热状态，不得直接把所有节点设置为相同高温。
- 参考EMB论文中145°C执行电机限值不可当作本项目主牵引电机的绕组限值；磁体、油液、卡钳密封和盘的限值须按部件材料确定。

## 4. 参数优先级与试探范围
下表**仅为敏感性扫描范围，不等于部件选型和有效性能参数**：
| 参数 | V0.1 | 建议探索范围或候选值 | 类型/优先级 |
|---|---|---|---|
| 车重kg |1800| 1600/1800/2100（载荷工况）| 条件变量P0 |
| 轴距m |2.8| 2.6–3.0 | 设计检查P0 |
| 静态前轴荷比 |0.55| 0.50–0.60 | P0 |
| 重心高度m |0.55| 0.45–0.65 | P0 |
| 车轮半径m |0.32| 0.30–0.34 | P0 |
| 电机到车轮速比 |9.0| 8.0–10.0 | P0 |
| 电机峰值功率kW |120| 100–150 | P0 |
| 电机峰值扭矩Nm |260| 220–320 | P0 |
| 电机最大转速rpm |未知| 12000–16000，依目标最高车速检查 | 必补P0 |
| 减速器传动效率 |0.96| 0.94–0.98 粗略筛选，驱动/反拖需分开 | 必补MAP P0 |
| 盘外径mm |280| 260–320 | P0 |
| 盘厚mm |22| 20–28 | P0 |
| 单盘质量kg |未知| 4–8（只作热容影响筛选） | 必补P0 |
| 摩擦有效半径m |未知| 0.10–0.12（针对280mm盘初筛） | 必补P0 |
| 盘/片摩擦系数 |0.40| 0.30–0.50，后续温度依赖 | P0 |
| 盘吸收接触热份额 |未知| 0.70–0.95，只作灵敏度范围，不替代热浸透率校核 | P1 |
| 环境温度°C |25| 0/25/40（常温/极端场景） | P1 |
| 冷却液进口温度°C |未知| 35–65（仅换热边界探索） | P1 |
| 冷却液总质量流量kg/s |未知| 0.05–0.25（仅候选，不预设水套有效） | P1 |
| 盘表面发射率 |未知| 0.30–0.90（材料/氧化/温变不确定性） | P1 |
| 盘-罩间距mm |3–10| 3–10（需包络确认）| 几何硬约束 |
| 盘-壳体最近距离 |未知| **不允许强行选固定值**；测量或CAD决定 | 必补P0 |
| 摩擦制动减速度 |未知| 0.3g/0.6g/0.8g，附着约束验证 | M1可暂用 |
| 前轴分配 |示例0.65| 首版按动态轴荷比例校核，控制律独立参数化 | M1必改 |

其他材料物性（c_p、k、密度、黏度和温度极限）、热阻和换热系数仍未知。不要用上表的探索范围冒充真实物性数据库。温度限值在部件选型前**保持null**。

## 5. 下一步必须向研究者索取的六项
1. 研究最高车速（建议先研究120/160 km/h之一，最高车速约束影响电机最高转速）。
2. 减速器输出端、半轴、轴承及壳体的概念几何或已有CAD：盘到壳体最短距离、轴径、卡钳空间。
3. 是否能选用公开电机转矩-转速与正/反向效率或损耗MAP；若无，暂按几档效率做不确定性研究，不做确定性温升结论。
4. 摩擦盘材质、质量、有效半径、摩擦片规格、左右卡钳制动力容量；可先采用具体商用尺寸作为几何参照。
5. 给出至少1个100→0的减速度/时间曲线、重复制动次数/间隔及预热工况；再生电池受电功率场景建议做0/30/60kW**演示**扫描。
6. 电机水套/减速器油液初步冷却边界与绕组/永磁体/润滑油/制动器热限，缺数据则范围化并标注来源级别。

## 6. Codex验收修订
M0应先核对本文件全部解析算例（允许数值舍入容差）；计算`dynamic_axle_load`、`rpm_conversions`、`motor_power_limit`、`front_rear_brake_allocation`、`brake_kinetic_energy`测试。生成`results/parameter_audit.csv`和`reports/M0_report.md`。在P0数据不足时M1只生成“合成演示案例”的能量闭合结果；不得将其作为实物热仿真定量依据。
