alan9900/Thermal-coupling-analysis-under-drive-control-integration/reports/planning/research_work_plan_v04_2026-10-19_v1.png

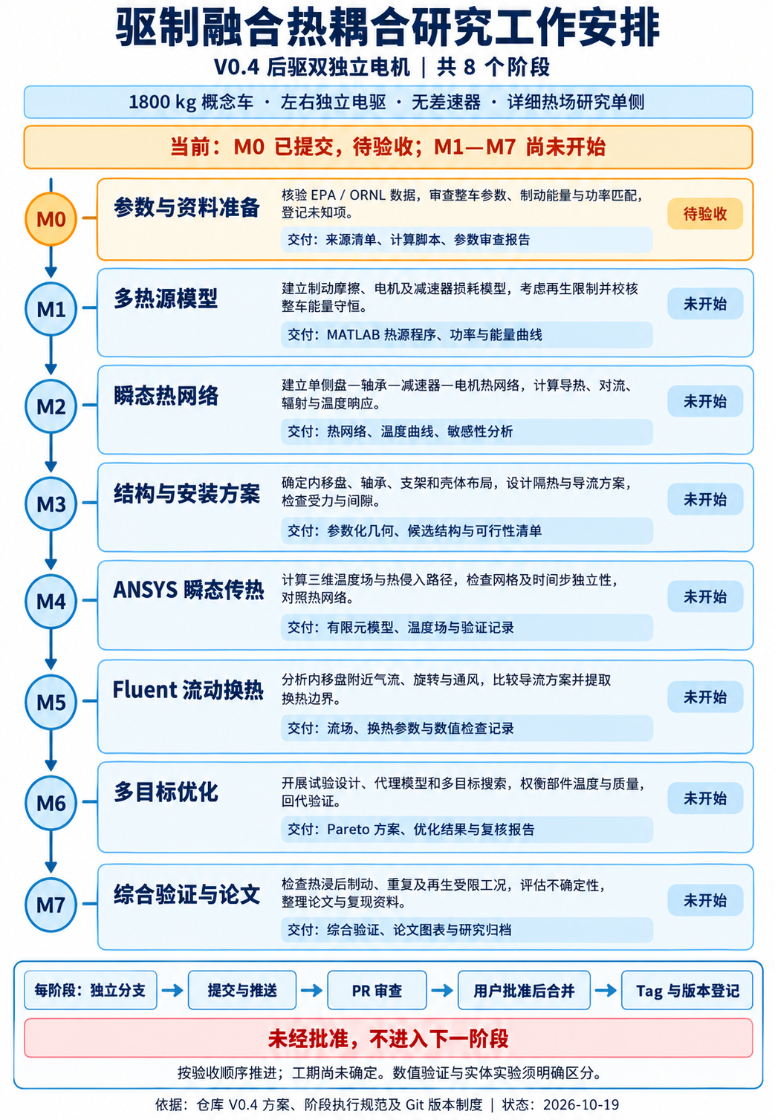
reports/planning/research_work_plan_v04_2026-10-19_v1.png
