alan9900/Thermal-coupling-analysis-under-drive-control-integration/results/m0/report_pages_contact.png

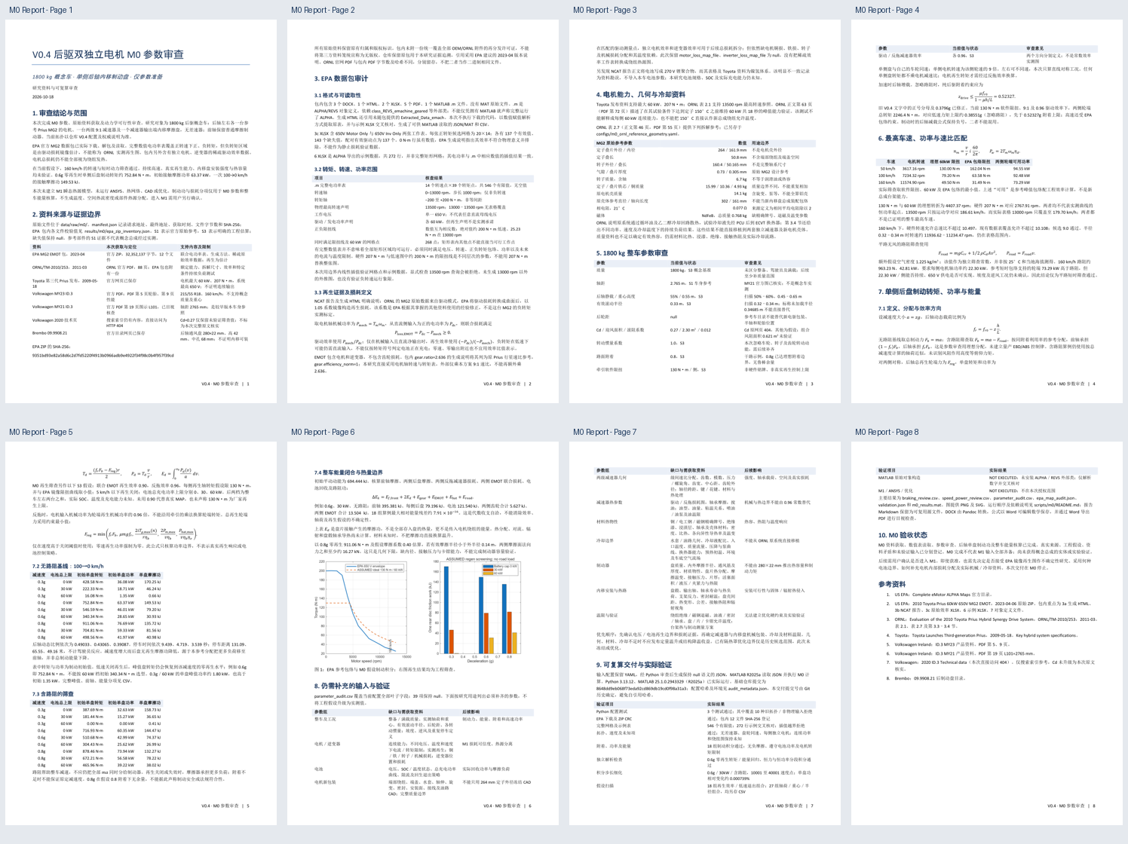
results/m0/report_pages_contact.png
