alan9900/Thermal-coupling-analysis-under-drive-control-integration/results/m1/report_pages_contact.png

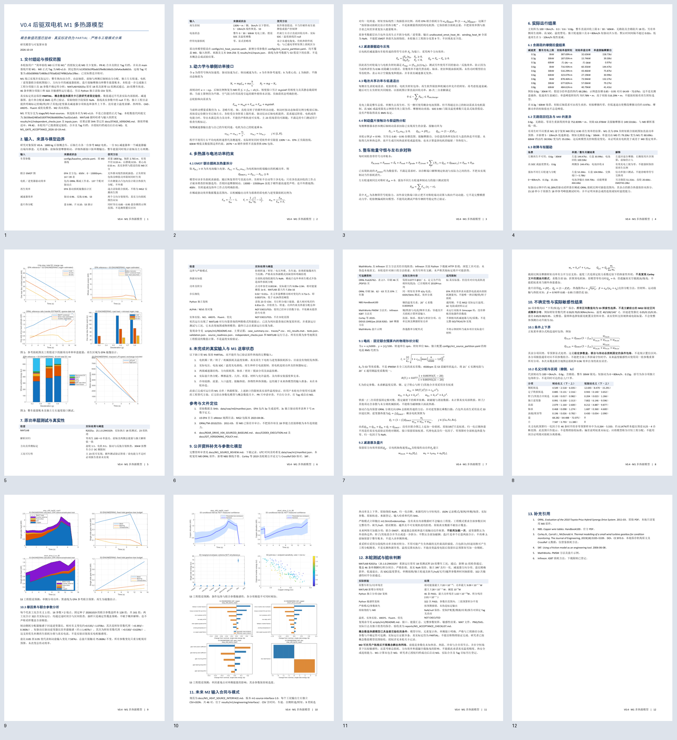
results/m1/report_pages_contact.png
