alan9900/Thermal-coupling-analysis-under-drive-control-integration/results/m3_review/mechanical_sensitivity.png

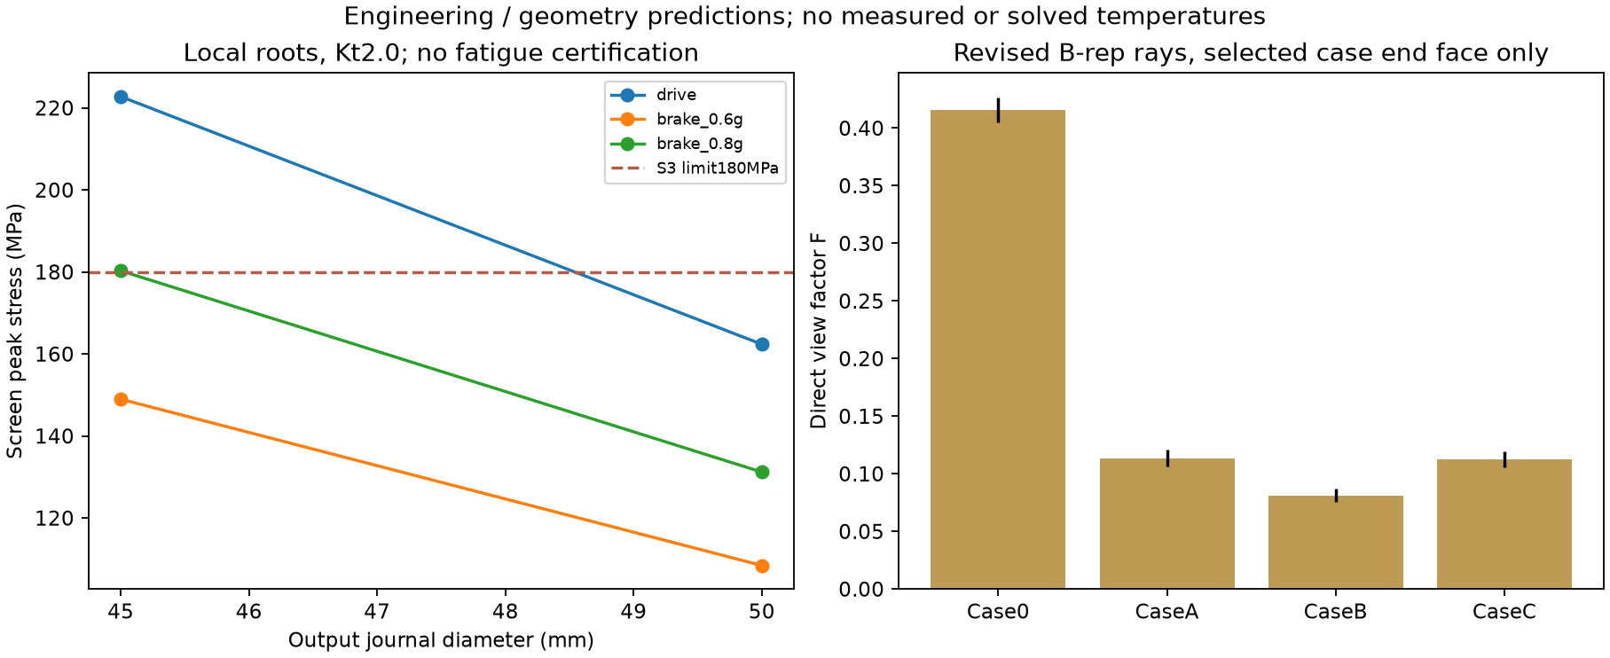
results/m3_review/mechanical_sensitivity.png
