alan9900/Thermal-coupling-analysis-under-drive-control-integration/results/m4/face_scoped/Mechanical_actual_temperature_at_33p775s.png

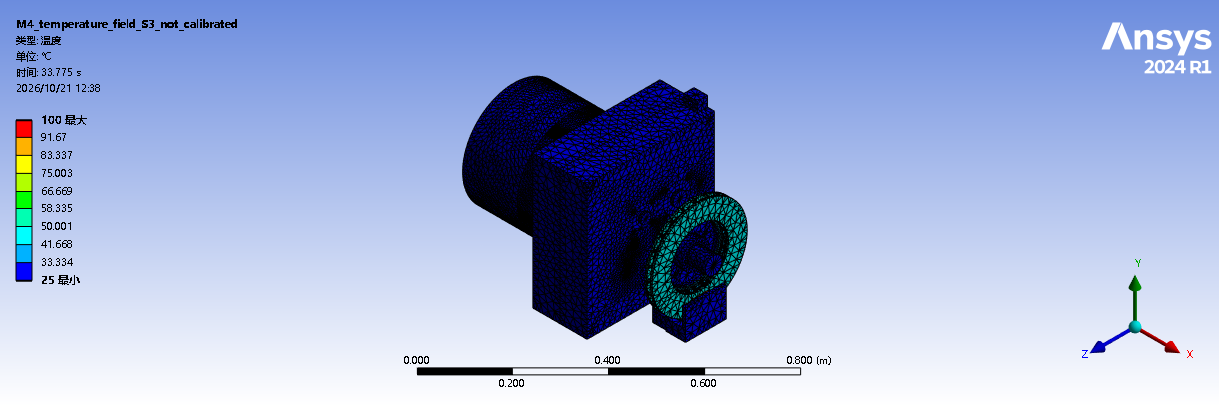
results/m4/face_scoped/Mechanical_actual_temperature_at_33p775s.png
