alan9900/Thermal-coupling-analysis-under-drive-control-integration/results/m4/studies/C_normal12_dt1/component_peak_fields.png

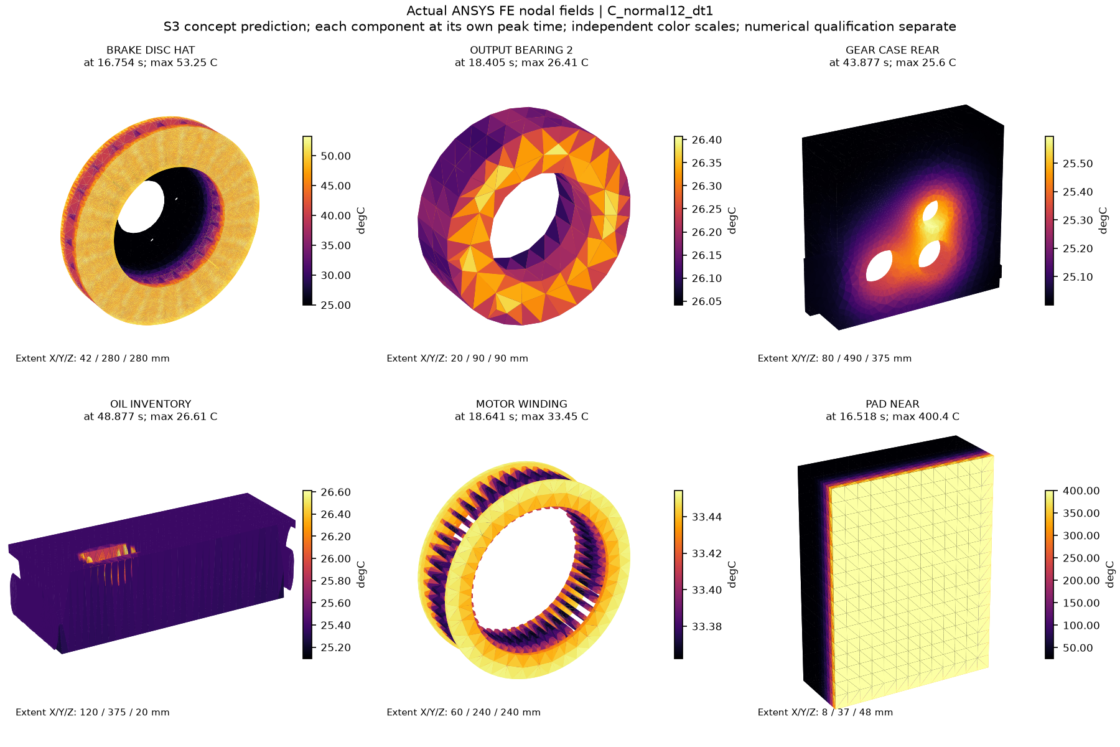
results/m4/studies/C_normal12_dt1/component_peak_fields.png
