alan9900/Thermal-coupling-analysis-under-drive-control-integration/cad/m3/CaseC_assembly.step

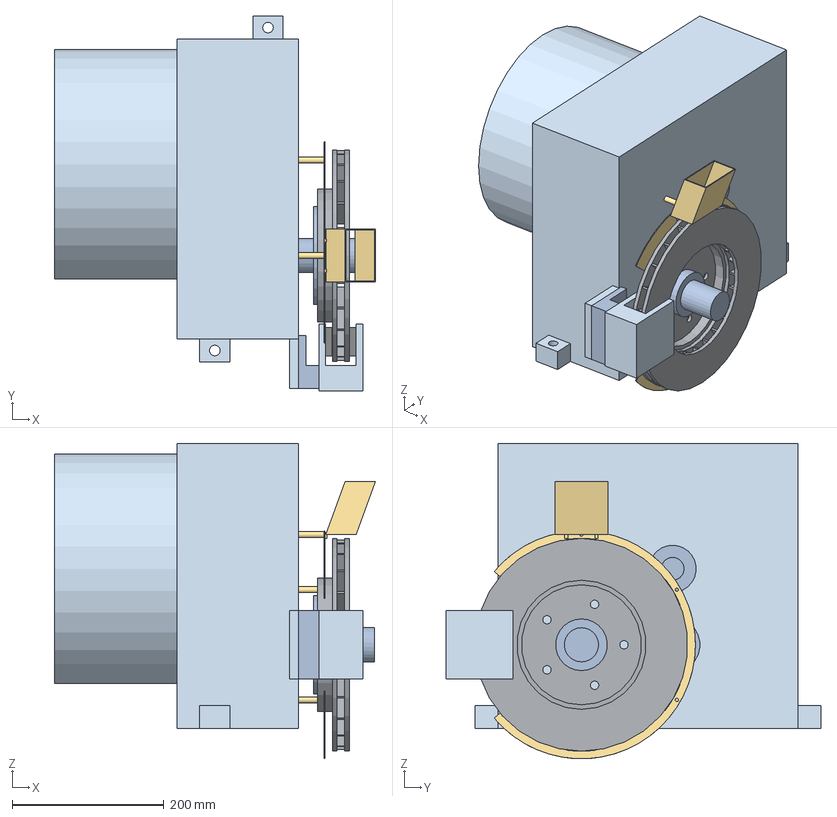
[picture p69: CAD file, 2026-10-21]
cad/m3/CaseC_assembly.step
422.5 x 493.0 x 414.7 mm
motor_case
motor_water_jacket
motor_stator
motor_winding
motor_rotor_other
input_rotor_shaft
intermediate_shaft
output_shaft
stage1_pinion
stage1_gear
stage2_pinion
stage2_gear
input_bearing_1
input_bearing_2
intermediate_bearing_1
intermediate_bearing_2
output_bearing_1
output_bearing_2
gear_case
motor_mount_bolt_1
motor_mount_bolt_2
motor_mount_bolt_3
motor_mount_bolt_4
oil_inventory
brake_disc_hat
disc_hub
caliper
pad_near
pad_far
caliper_reaction_bracket
caliper_mount_bolt_1
caliper_mount_bolt_2
shield_layer_1
shield_standoff_0_0
shield_standoff_0_1
shield_standoff_0_2
