alan9900/Thermal-coupling-analysis-under-drive-control-integration/cad/m3/CaseA_air_domain.step

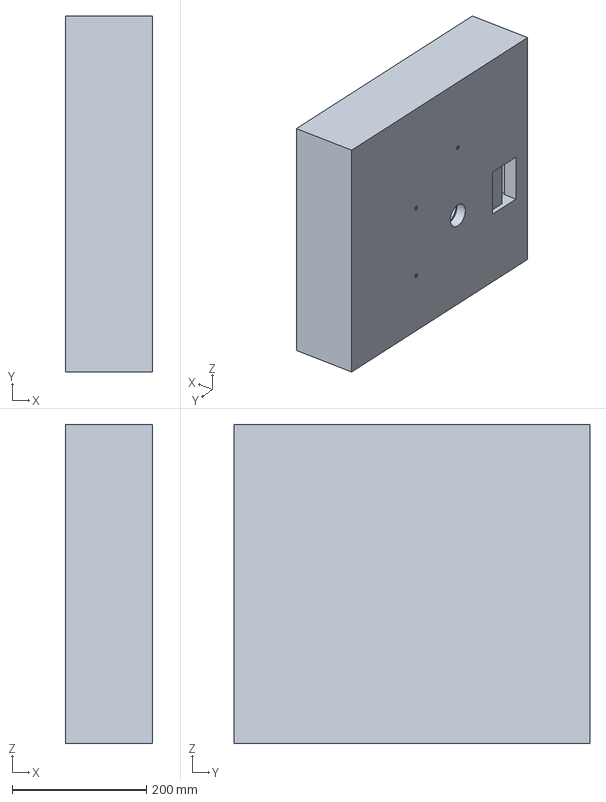
[picture p72: CAD file, 2026-10-21]
cad/m3/CaseA_air_domain.step
130.0 x 530.0 x 475.0 mm
