alan9900/Thermal-coupling-analysis-under-drive-control-integration/cad/m3_helical/parts/oil_inventory_full.step

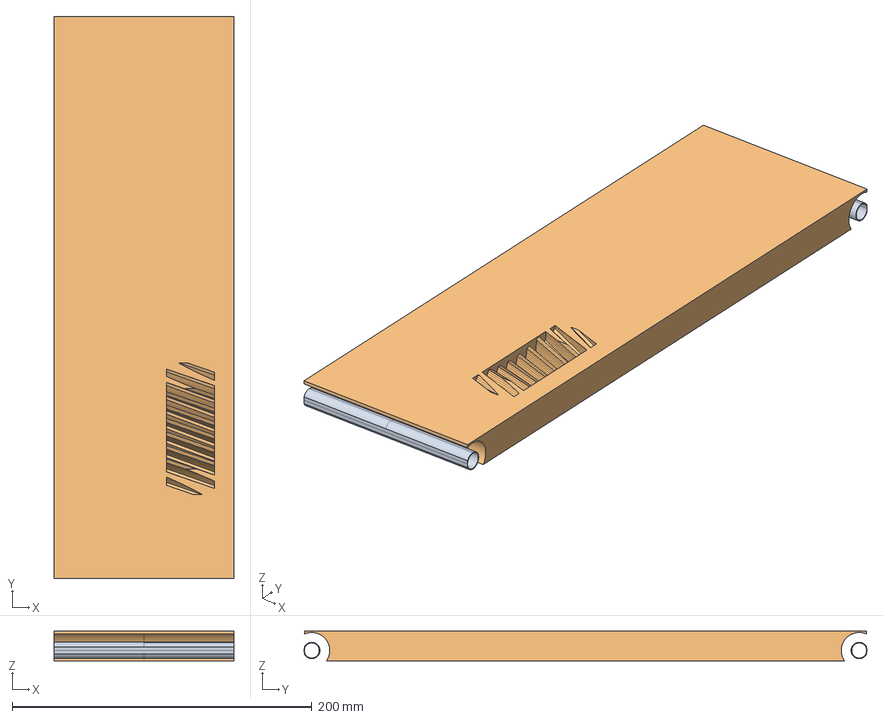
[picture p74: CAD file, 2026-10-21]
cad/m3_helical/parts/oil_inventory_full.step
120.0 x 375.0 x 20.0 mm
