alan9900/Thermal-coupling-analysis-under-drive-control-integration/cad/m3_helical/parts/stage2_gear_full.step

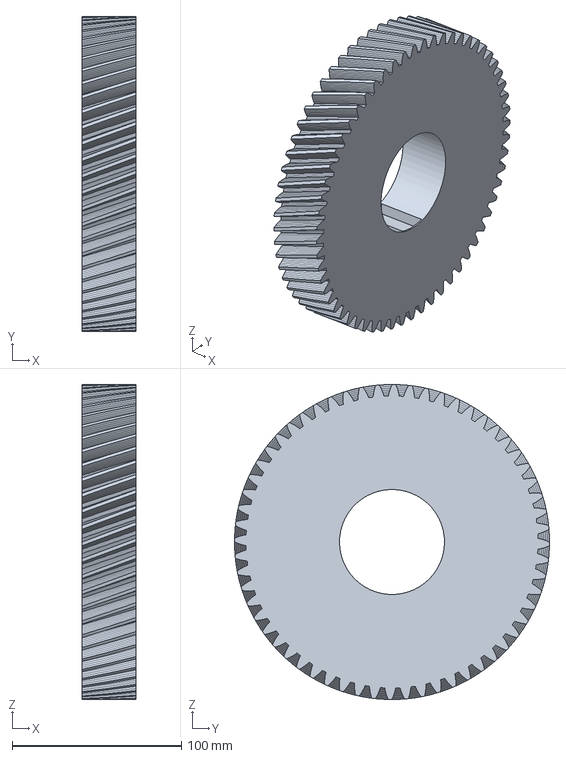
[picture p76: CAD file, 2026-10-21]
cad/m3_helical/parts/stage2_gear_full.step
32.0 x 186.0 x 186.0 mm
