alan9900/Thermal-coupling-analysis-under-drive-control-integration/cad/m3_review/CaseC_d50_full_air.step

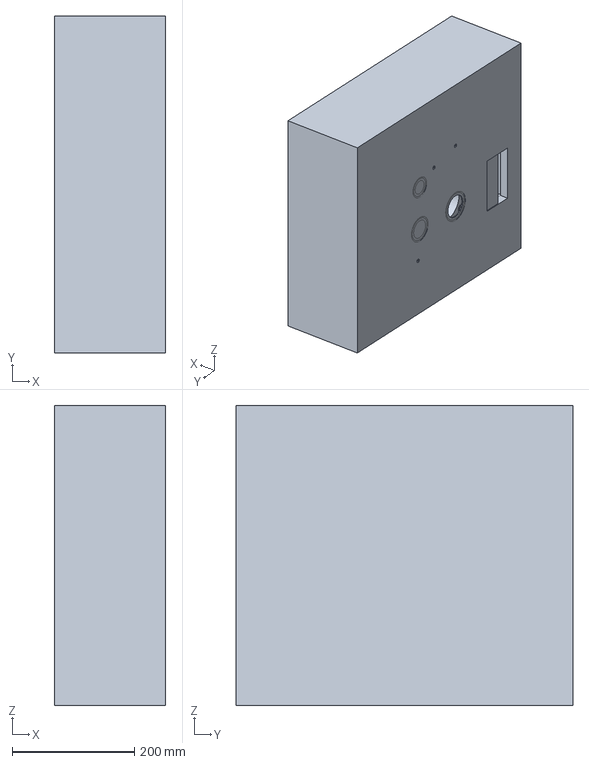
[picture p77: CAD file, 2026-10-21]
cad/m3_review/CaseC_d50_full_air.step
182.0 x 550.0 x 490.0 mm
