alan9900/Thermal-coupling-analysis-under-drive-control-integration/cad/m3/base_parts/disc_hub.step

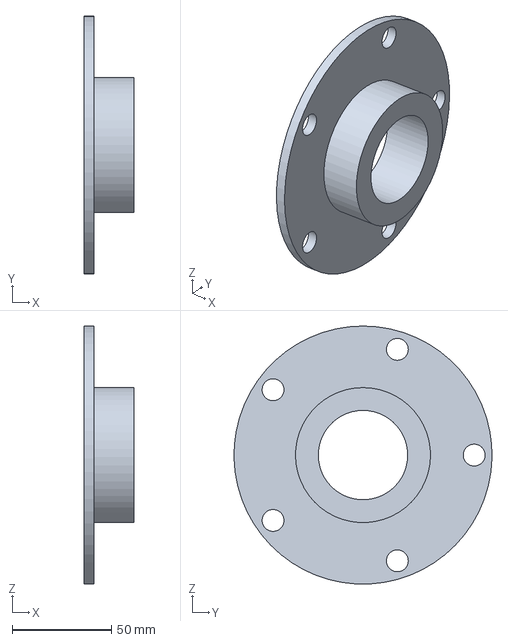
[picture p78: CAD file, 2026-10-21]
cad/m3/base_parts/disc_hub.step
25.0 x 130.0 x 129.9 mm
