alan9900/Thermal-coupling-analysis-under-drive-control-integration/cad/m3/CaseA/shield_standoff_0_1.step

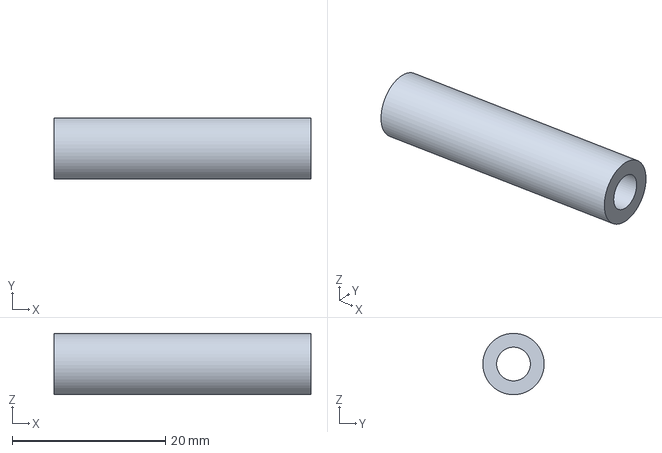
[picture p79: CAD file, 2026-10-21]
cad/m3/CaseA/shield_standoff_0_1.step
33.5 x 8.00 x 7.99 mm
