alan9900/Thermal-coupling-analysis-under-drive-control-integration/cad/m3/CaseB/shield_layer_2.step

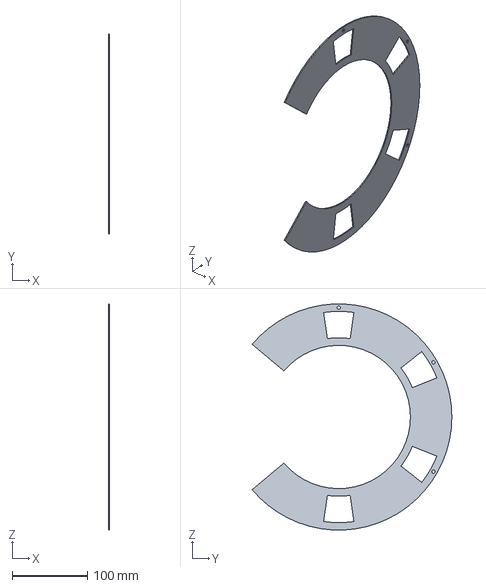
[picture p80: CAD file, 2026-10-21]
cad/m3/CaseB/shield_layer_2.step
1.50 x 264.9 x 299.7 mm
