alan9900/Thermal-coupling-analysis-under-drive-control-integration/cad/m3_helical/parts/stage2_gear_thermal.step

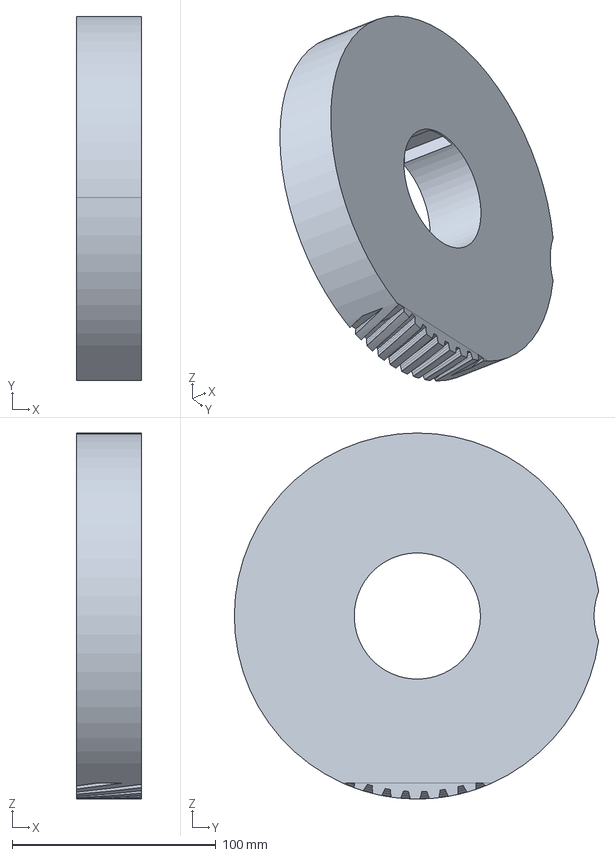
[picture p81: CAD file, 2026-10-21]
cad/m3_helical/parts/stage2_gear_thermal.step
32.0 x 179.0 x 179.8 mm
