alan9900/Thermal-coupling-analysis-under-drive-control-integration/cad/m3_review/revised_parts/wheel_halfshaft_interface.step

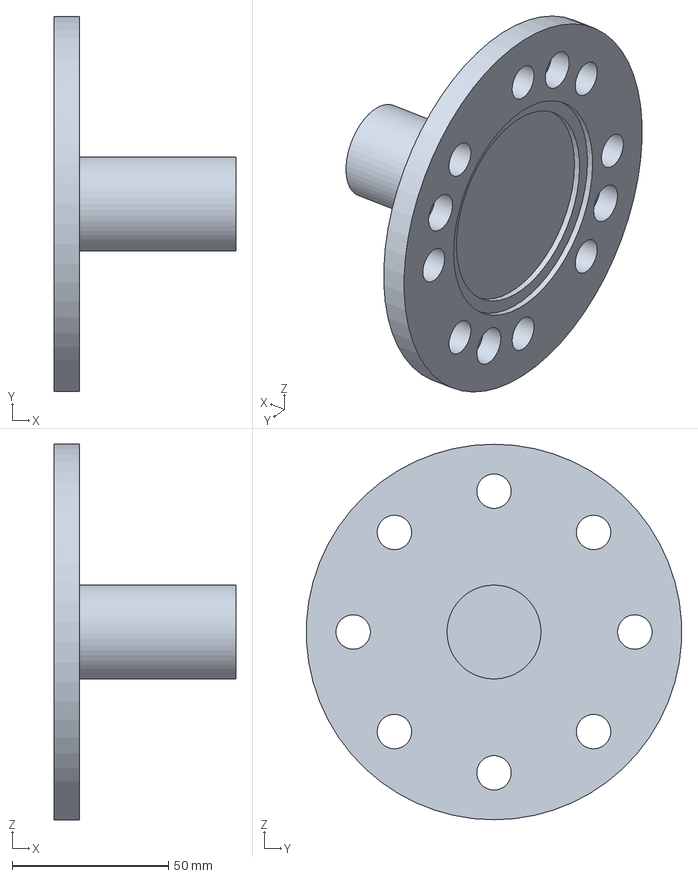
[picture p82: CAD file, 2026-10-21]
cad/m3_review/revised_parts/wheel_halfshaft_interface.step
58.0 x 119.8 x 120.0 mm
