alan9900/Thermal-coupling-analysis-under-drive-control-integration/cad/m3/base_parts/motor_case.step

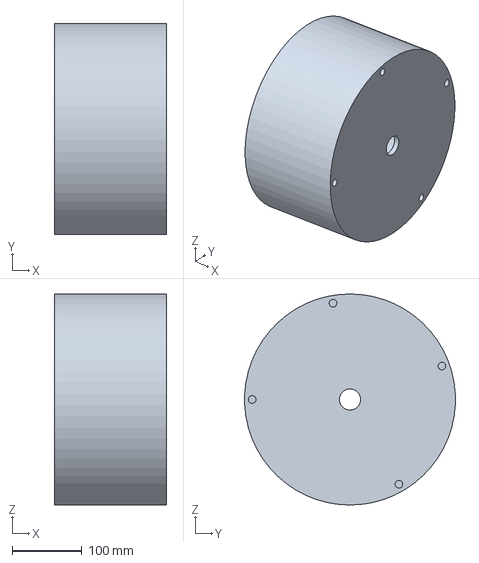
[picture p83: CAD file, 2026-10-21]
cad/m3/base_parts/motor_case.step
161.0 x 301.6 x 302.0 mm
