alan9900/Thermal-coupling-analysis-under-drive-control-integration/cad/m3/CaseB/shield_standoff_1_0.step

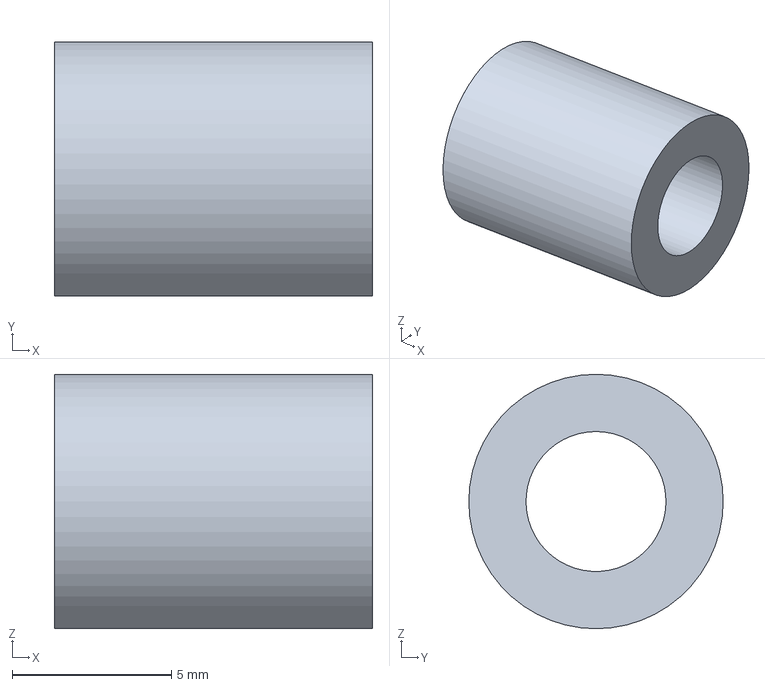
[picture p84: CAD file, 2026-10-21]
cad/m3/CaseB/shield_standoff_1_0.step
10.0 x 8.00 x 8.00 mm
