alan9900/Thermal-coupling-analysis-under-drive-control-integration/cad/m3_helical/Case0_d50_helical_thermal.step

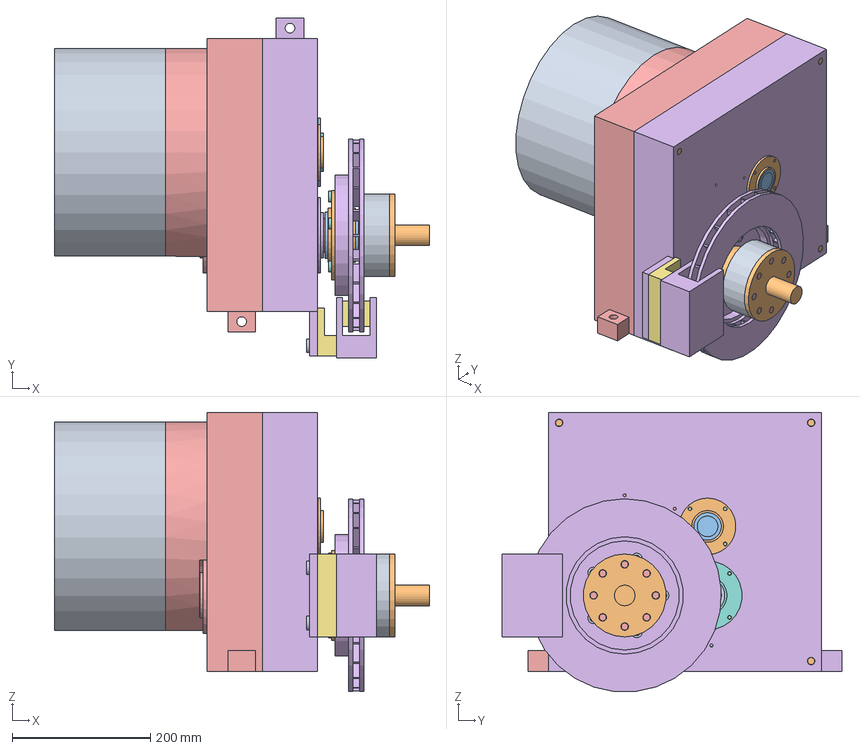
[picture p85: CAD file, 2026-10-21]
cad/m3_helical/Case0_d50_helical_thermal.step
543.0 x 493.0 x 404.2 mm
motor_case
motor_water_jacket
motor_stator
motor_winding
motor_rotor_other
brake_disc_hat
pad_near
pad_far
motor_rotor_shaft
motor_input_coupling
coupling_motor_key_-1
coupling_motor_key_1
coupling_input_key_-1
coupling_input_key_1
motor_mount_bolt_1
motor_mount_bolt_2
motor_mount_bolt_3
motor_mount_bolt_4
motor_gear_adapter
input_bearing_1
input_bearing_2
input_front_retaining_ring
input_rear_clamp_collar
input_front_outer_retainer
input_rear_outer_retainer
input_front_seal
input_rear_seal
intermediate_bearing_1
intermediate_bearing_2
intermediate_front_retaining_ring
intermediate_rear_clamp_collar
intermediate_front_outer_retainer
intermediate_rear_outer_retainer
intermediate_front_seal
intermediate_rear_seal
output_bearing_1
output_bearing_2
output_front_retaining_ring
output_rear_clamp_collar
output_front_outer_retainer
output_rear_outer_retainer
output_front_seal
output_rear_seal
intermediate_gear_key
intermediate_gear_key_opposed
stage1_gear
intermediate_gear_retaining_collar
output_gear_key
output_gear_key_opposed
stage2_gear
output_gear_retaining_collar
hub_key_-1
hub_key_1
disc_hub_bolt_1
disc_hub_bolt_head_1
disc_hub_nut_1
disc_hub_bolt_2
disc_hub_bolt_head_2
disc_hub_nut_2
disc_hub_bolt_3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
