alan9900/Thermal-coupling-analysis-under-drive-control-integration/cad/m3_helical/parts/stage1_gear_thermal.step

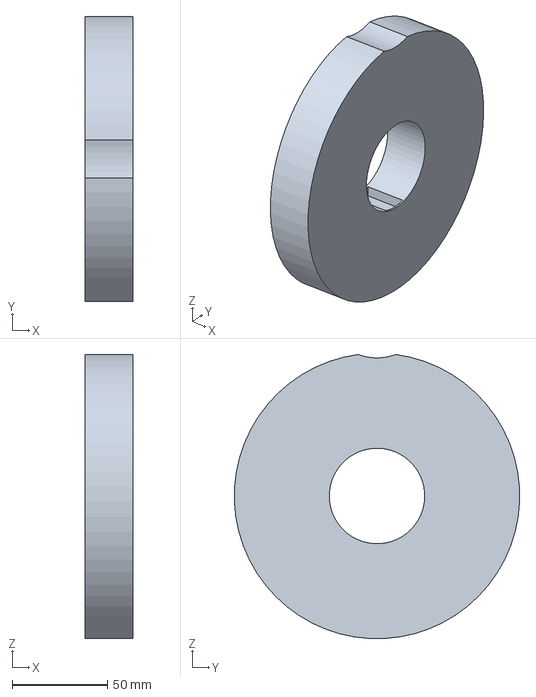
[picture p86: CAD file, 2026-10-21]
cad/m3_helical/parts/stage1_gear_thermal.step
25.0 x 149.4 x 148.8 mm
