alan9900/Thermal-coupling-analysis-under-drive-control-integration/cad/m3_review/revised_parts/pad_near.step

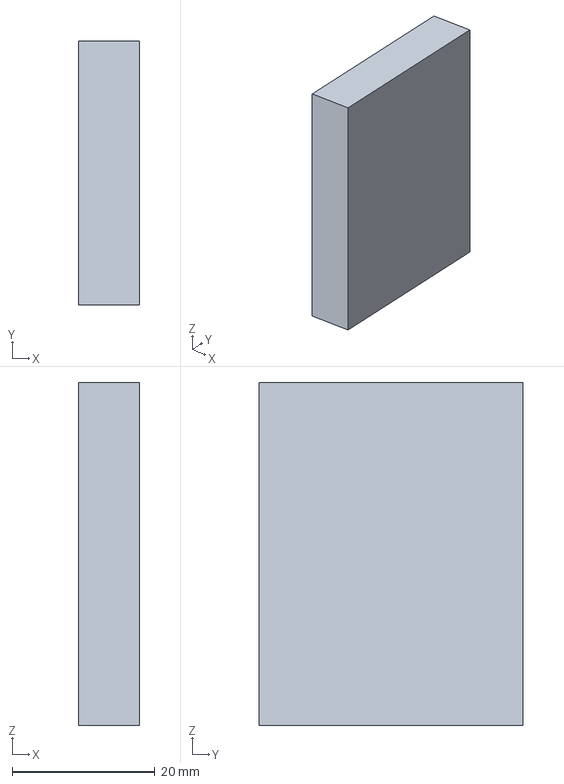
[picture p87: CAD file, 2026-10-21]
cad/m3_review/revised_parts/pad_near.step
8.50 x 37.0 x 48.0 mm
