alan9900/Thermal-coupling-analysis-under-drive-control-integration/cad/m3/base_parts/intermediate_bearing_2.step

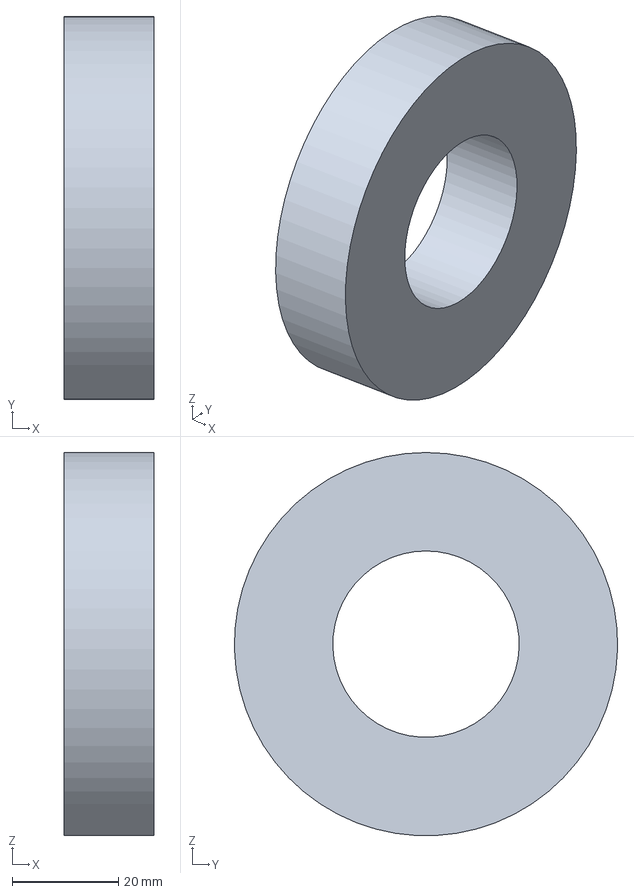
[picture p88: CAD file, 2026-10-21]
cad/m3/base_parts/intermediate_bearing_2.step
17.0 x 72.0 x 71.9 mm
