alan9900/Thermal-coupling-analysis-under-drive-control-integration/cad/m3/CaseB/shield_standoff_0_0.step

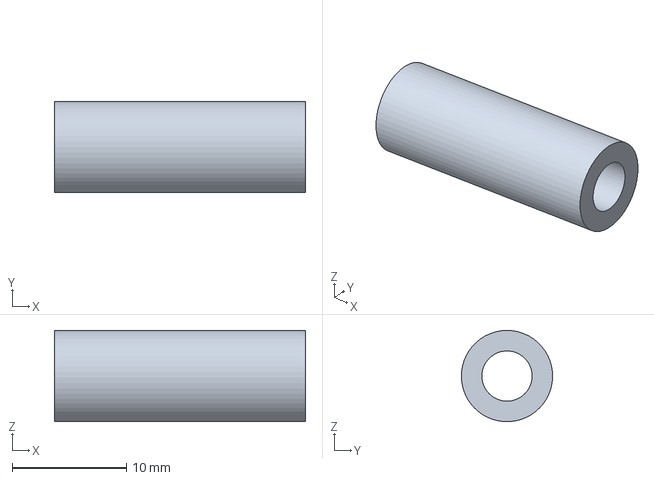
[picture p89: CAD file, 2026-10-21]
cad/m3/CaseB/shield_standoff_0_0.step
22.0 x 8.00 x 7.99 mm
