alan9900/Thermal-coupling-analysis-under-drive-control-integration/cad/m3_review/revised_parts/input_front_seal.step

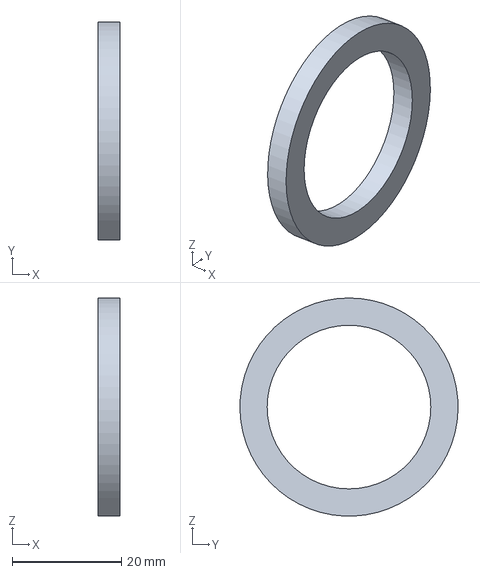
[picture p90: CAD file, 2026-10-21]
cad/m3_review/revised_parts/input_front_seal.step
4.00 x 40.0 x 40.0 mm
