alan9900/Thermal-coupling-analysis-under-drive-control-integration/cad/m3/base_parts/output_bearing_1.step

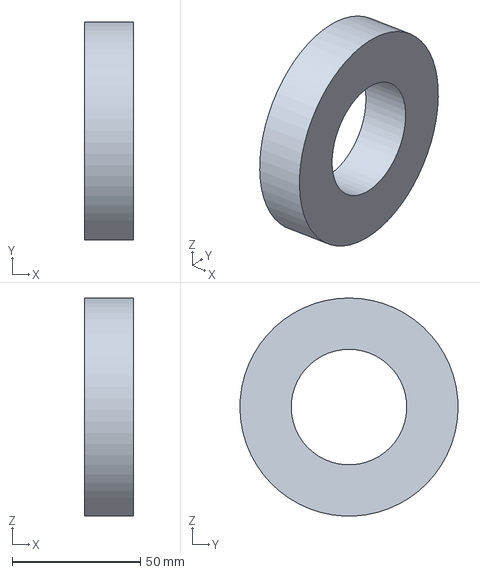
[picture p91: CAD file, 2026-10-21]
cad/m3/base_parts/output_bearing_1.step
19.0 x 85.0 x 84.9 mm
