alan9900/Thermal-coupling-analysis-under-drive-control-integration/cad/m3_helical/parts/intermediate_shaft_thermal.step

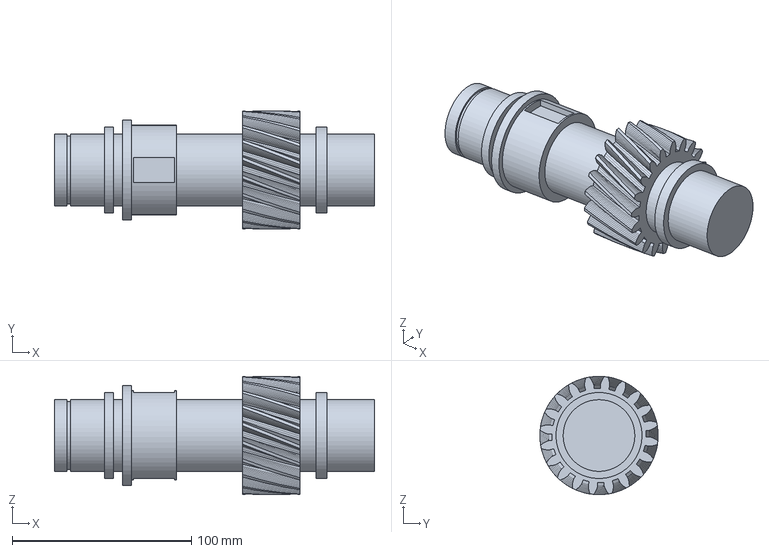
[picture p92: CAD file, 2026-10-21]
cad/m3_helical/parts/intermediate_shaft_thermal.step
178.5 x 66.0 x 66.0 mm
