alan9900/Thermal-coupling-analysis-under-drive-control-integration/cad/m3/base_parts/input_rotor_shaft.step

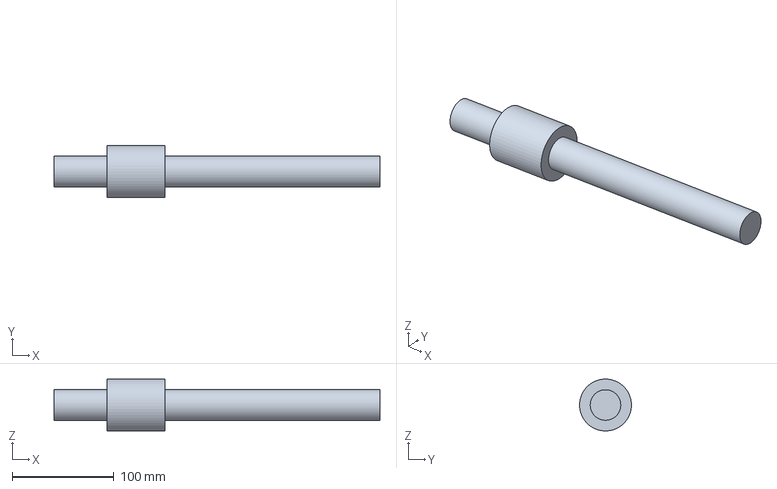
[picture p94: CAD file, 2026-10-21]
cad/m3/base_parts/input_rotor_shaft.step
320.0 x 51.0 x 51.0 mm
