alan9900/Thermal-coupling-analysis-under-drive-control-integration/cad/m3/base_parts/motor_stator.step

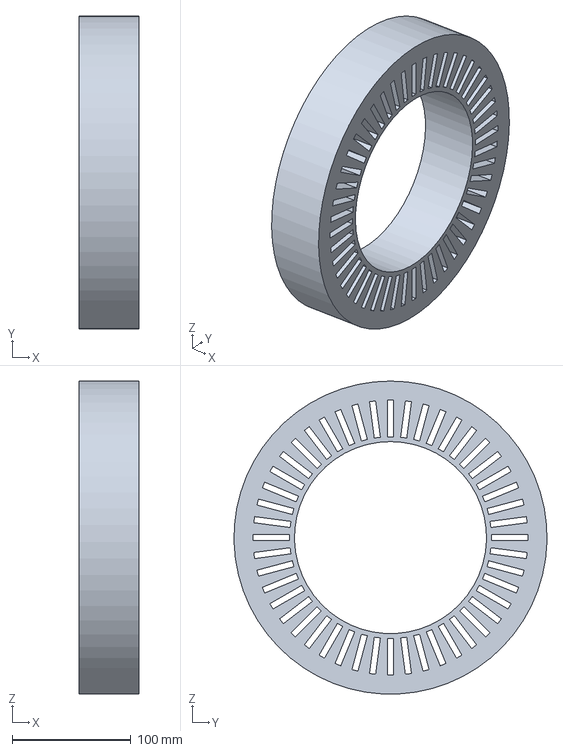
[picture p95: CAD file, 2026-10-21]
cad/m3/base_parts/motor_stator.step
50.8 x 263.9 x 263.8 mm
