alan9900/Thermal-coupling-analysis-under-drive-control-integration/cad/m3_review/revised_parts/input_shaft.step

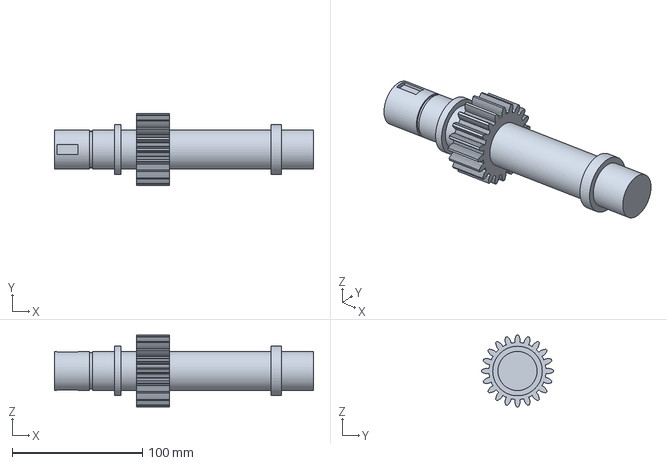
[picture p96: CAD file, 2026-10-21]
cad/m3_review/revised_parts/input_shaft.step
198.5 x 55.0 x 55.0 mm
