alan9900/Thermal-coupling-analysis-under-drive-control-integration/cad/m3/base_parts/stage2_gear.step

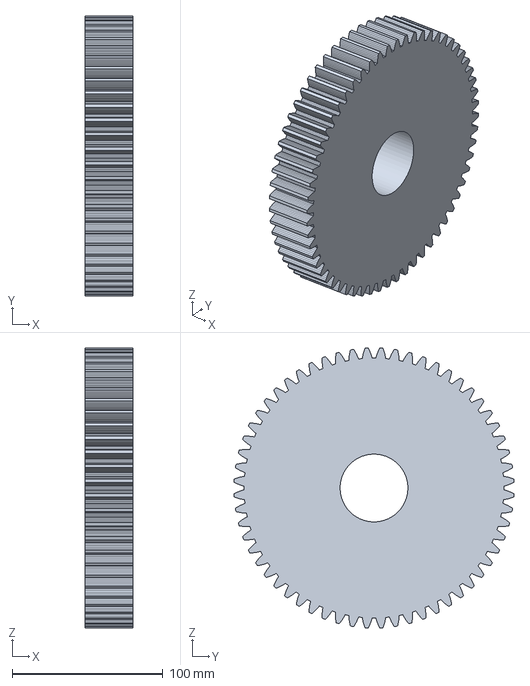
[picture p97: CAD file, 2026-10-21]
cad/m3/base_parts/stage2_gear.step
32.0 x 185.8 x 185.8 mm
