alan9900/Thermal-coupling-analysis-under-drive-control-integration/cad/m3_review/revised_parts/hub_key_1.step

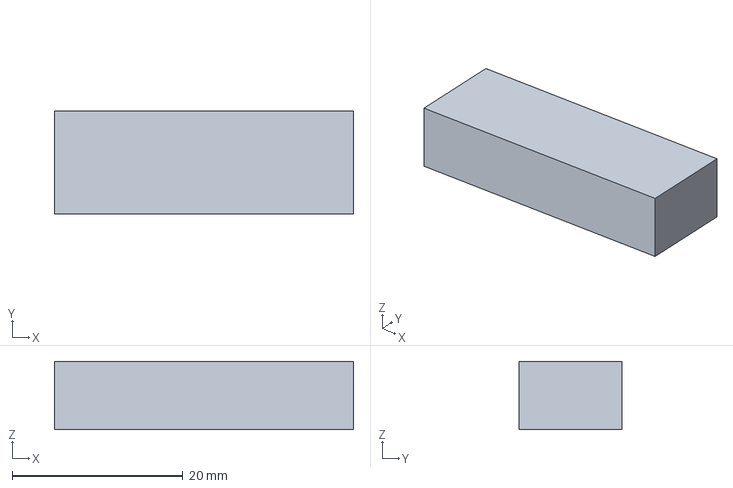
[picture p98: CAD file, 2026-10-21]
cad/m3_review/revised_parts/hub_key_1.step
35.0 x 12.0 x 8.00 mm
