alan9900/Thermal-coupling-analysis-under-drive-control-integration/cad/m3/base_parts/input_bearing_1.step

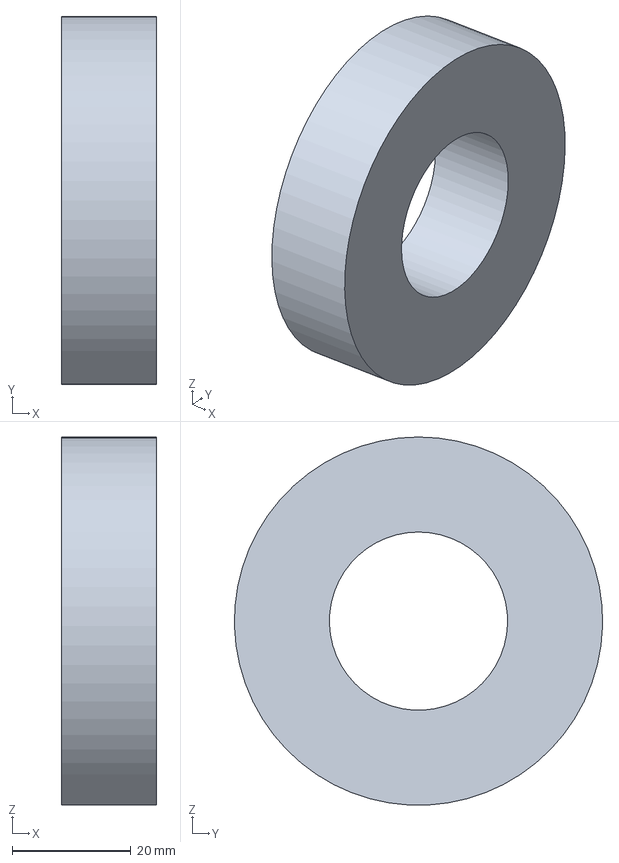
[picture p99: CAD file, 2026-10-21]
cad/m3/base_parts/input_bearing_1.step
16.0 x 62.0 x 62.0 mm
