alan9900/Thermal-coupling-analysis-under-drive-control-integration/cad/m3/base_parts/output_shaft.step

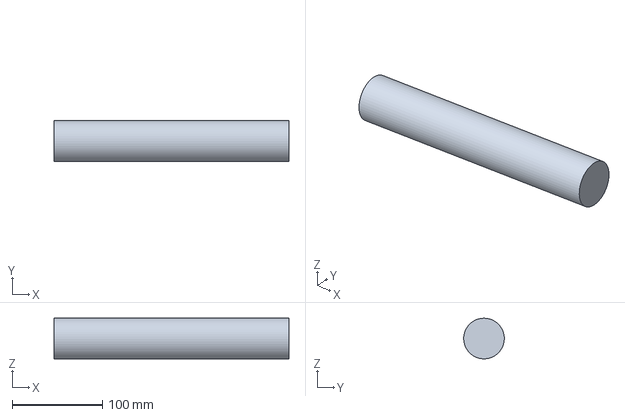
[picture p100: CAD file, 2026-10-21]
cad/m3/base_parts/output_shaft.step
260.0 x 45.0 x 45.0 mm
