alan9900/Thermal-coupling-analysis-under-drive-control-integration/cad/m3_review/revised_parts/motor_water_jacket.step

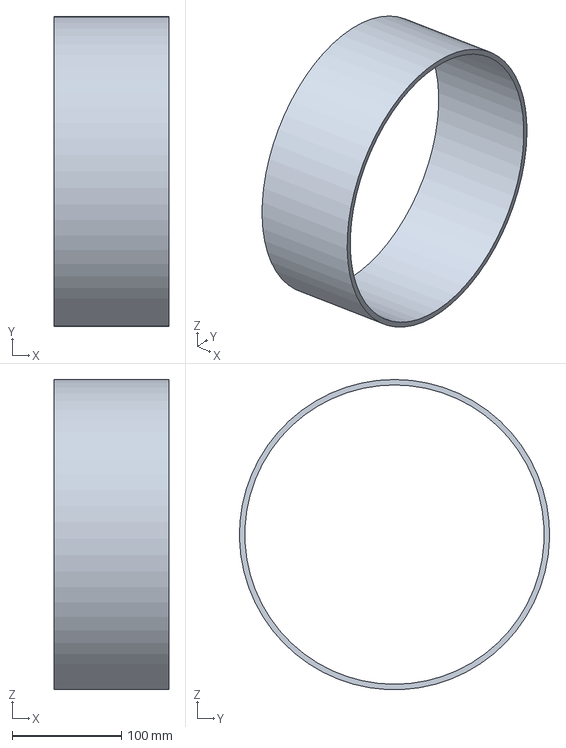
[picture p101: CAD file, 2026-10-21]
cad/m3_review/revised_parts/motor_water_jacket.step
105.0 x 283.9 x 283.8 mm
