alan9900/Thermal-coupling-analysis-under-drive-control-integration/cad/m3/base_parts/brake_disc_hat.step

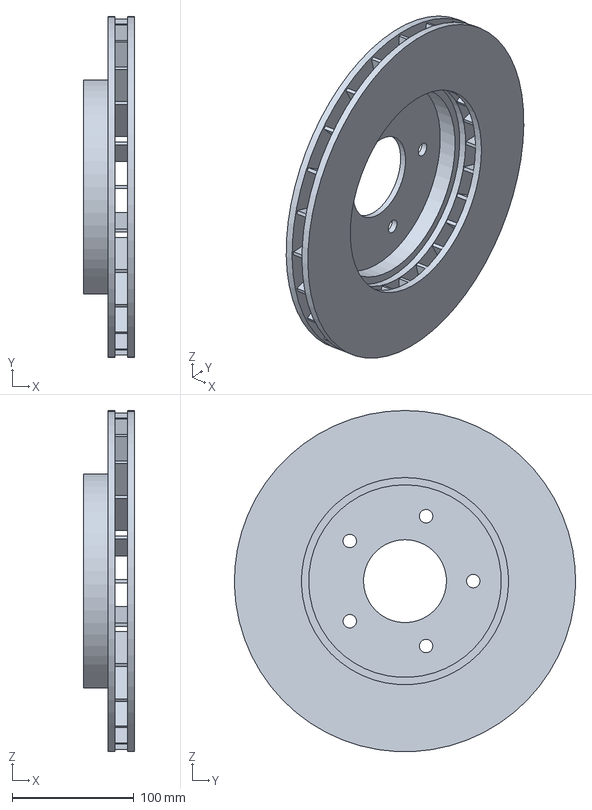
[picture p102: CAD file, 2026-10-21]
cad/m3/base_parts/brake_disc_hat.step
42.0 x 279.9 x 279.8 mm
