alan9900/Thermal-coupling-analysis-under-drive-control-integration/cad/m3_review/revised_parts/caliper_reaction_bracket.step

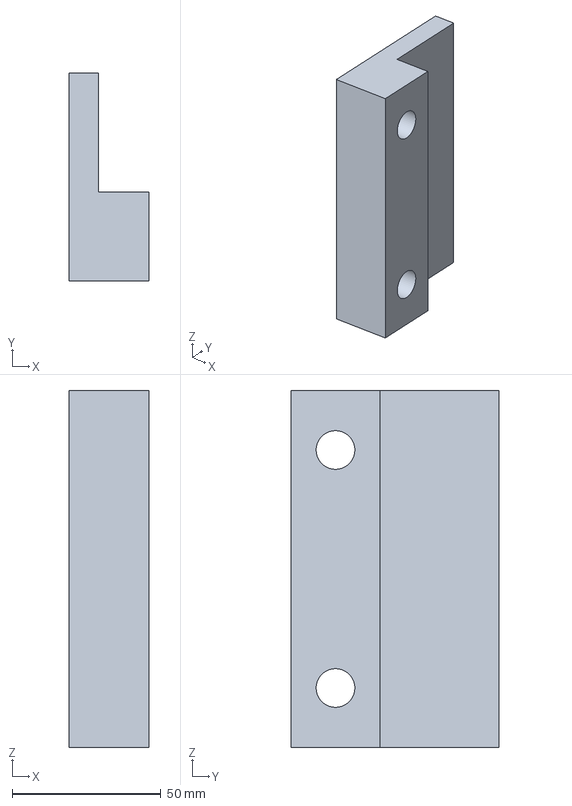
[picture p103: CAD file, 2026-10-21]
cad/m3_review/revised_parts/caliper_reaction_bracket.step
27.0 x 70.0 x 120.0 mm
