alan9900/Thermal-coupling-analysis-under-drive-control-integration/cad/m3_review/revised_parts/output_shaft.step

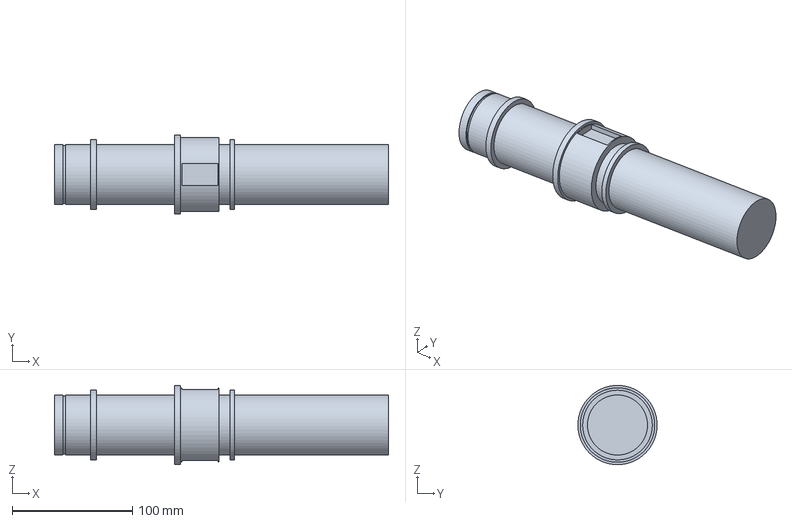
[picture p104: CAD file, 2026-10-21]
cad/m3_review/revised_parts/output_shaft.step
278.0 x 66.0 x 65.9 mm
