alan9900/Thermal-coupling-analysis-under-drive-control-integration/cad/m3/base_parts/motor_rotor_other.step

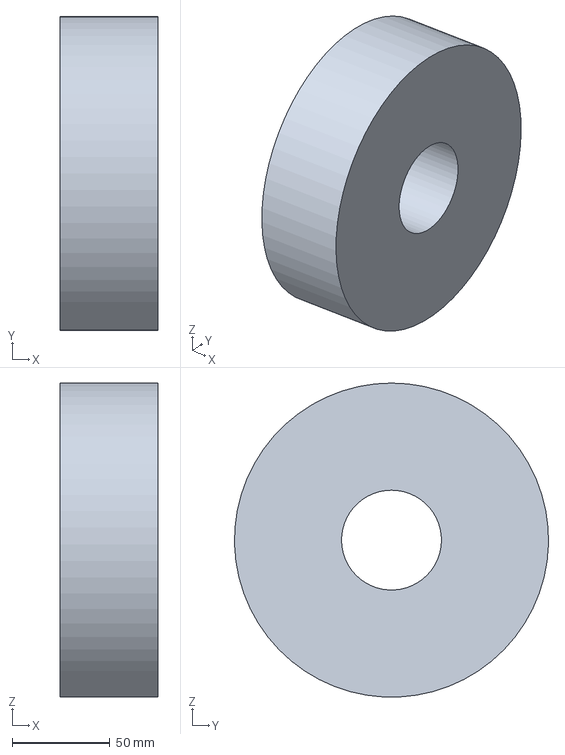
[picture p105: CAD file, 2026-10-21]
cad/m3/base_parts/motor_rotor_other.step
50.2 x 160.3 x 160.3 mm
