alan9900/Thermal-coupling-analysis-under-drive-control-integration/cad/m3_review/revised_parts/disc_hub.step

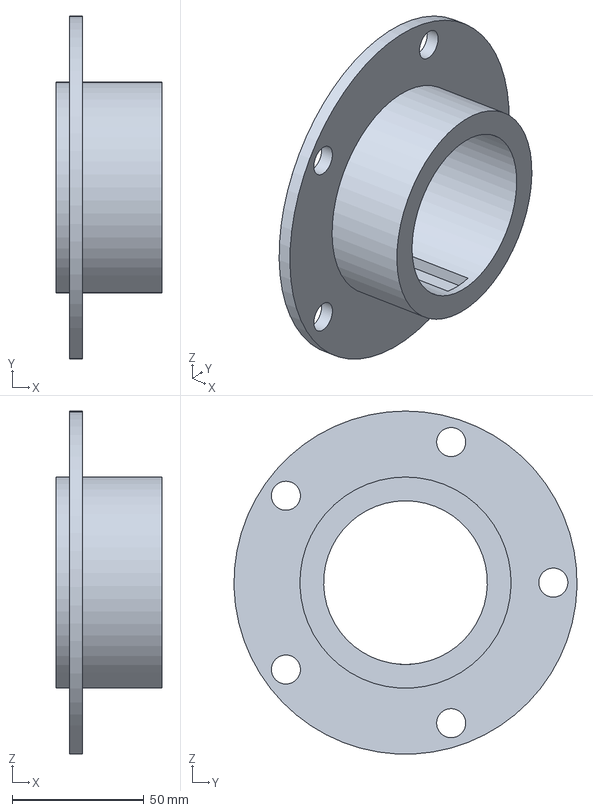
[picture p106: CAD file, 2026-10-21]
cad/m3_review/revised_parts/disc_hub.step
40.0 x 130.0 x 129.9 mm
