alan9900/Thermal-coupling-analysis-under-drive-control-integration/cad/m3_review/revised_parts/output_rear_outer_retainer.step

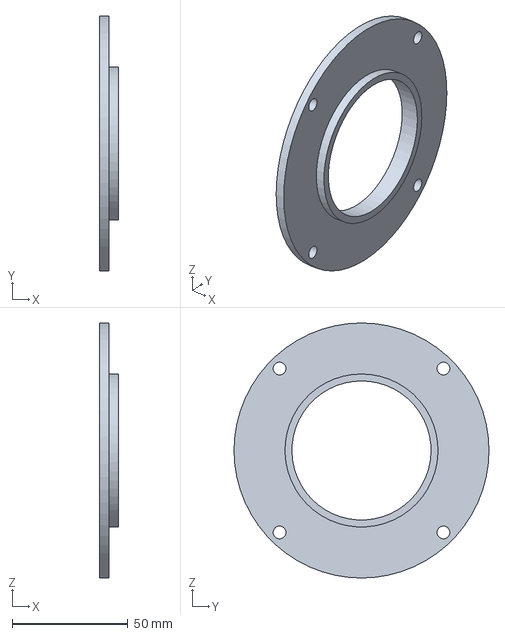
[picture p107: CAD file, 2026-10-21]
cad/m3_review/revised_parts/output_rear_outer_retainer.step
8.00 x 110.0 x 110.0 mm
