alan9900/Thermal-coupling-analysis-under-drive-control-integration/cad/m3_review/revised_parts/output_bearing_2.step

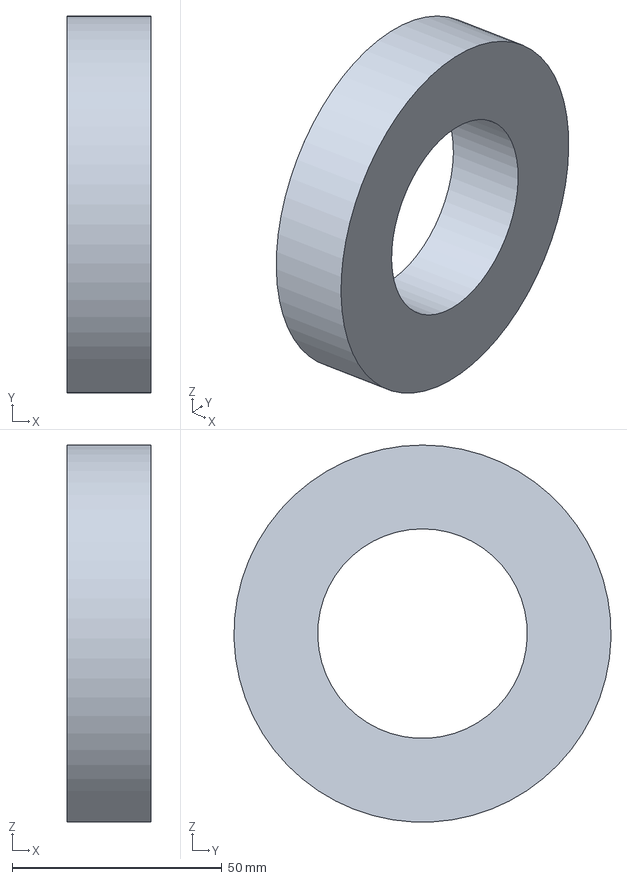
[picture p108: CAD file, 2026-10-21]
cad/m3_review/revised_parts/output_bearing_2.step
20.0 x 90.0 x 89.9 mm
