alan9900/Thermal-coupling-analysis-under-drive-control-integration/cad/m3/base_parts/stage2_pinion.step

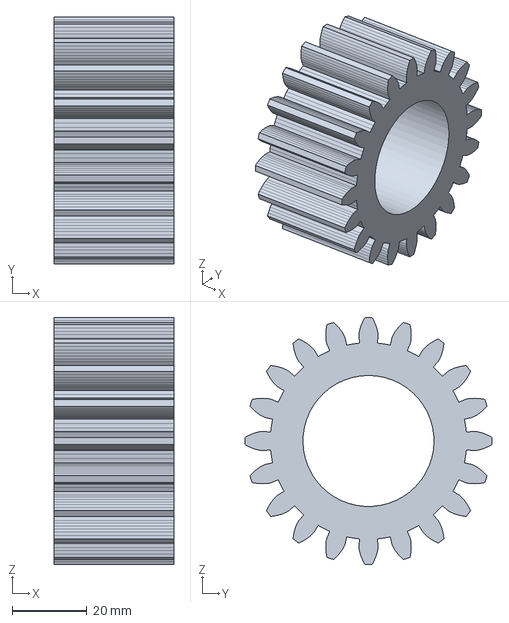
[picture p109: CAD file, 2026-10-21]
cad/m3/base_parts/stage2_pinion.step
32.0 x 66.0 x 66.0 mm
