alan9900/Thermal-coupling-analysis-under-drive-control-integration/cad/m3/base_parts/intermediate_shaft.step

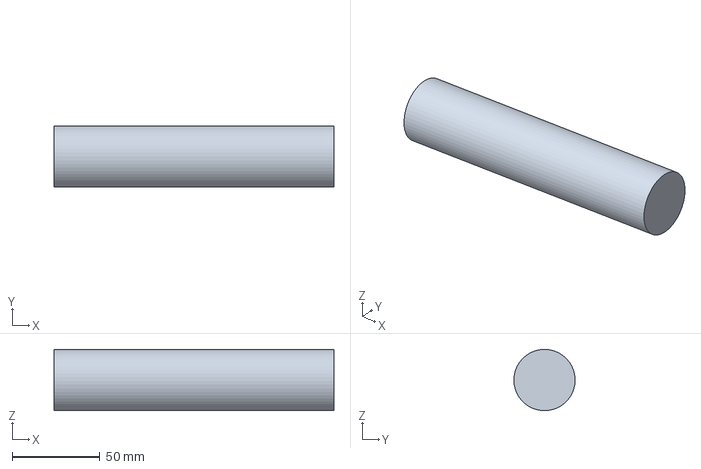
[picture p110: CAD file, 2026-10-21]
cad/m3/base_parts/intermediate_shaft.step
160.0 x 35.0 x 35.0 mm
