alan9900/Thermal-coupling-analysis-under-drive-control-integration/cad/m3/base_parts/gear_case.step

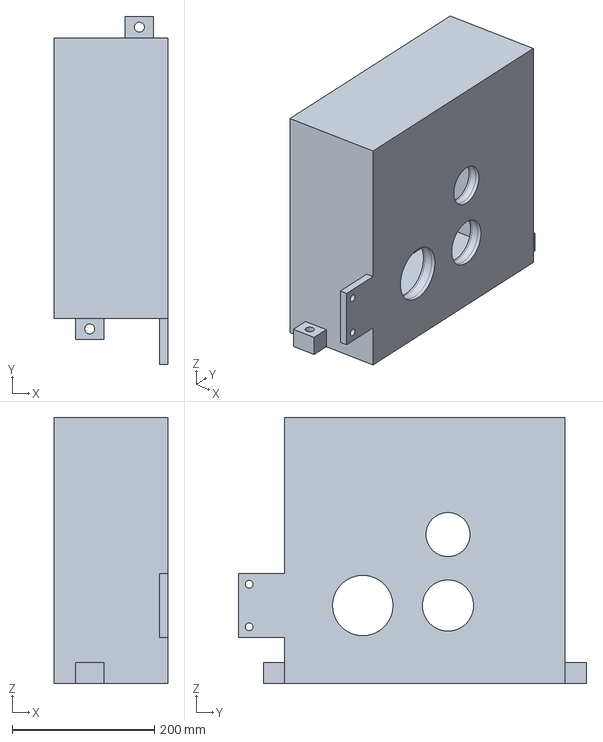
[picture p111: CAD file, 2026-10-21]
cad/m3/base_parts/gear_case.step
160.0 x 490.0 x 375.0 mm
