alan9900/Thermal-coupling-analysis-under-drive-control-integration/cad/m3/base_parts/caliper.step

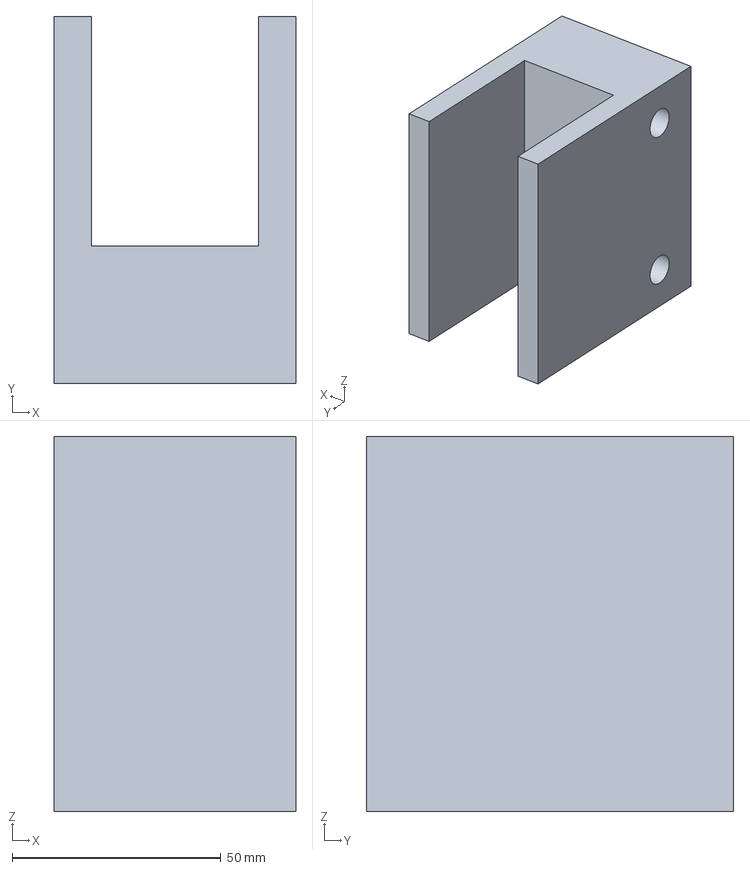
[picture p112: CAD file, 2026-10-21]
cad/m3/base_parts/caliper.step
58.0 x 88.0 x 90.0 mm
