alan9900/Thermal-coupling-analysis-under-drive-control-integration/cad/m3_review/revised_parts/output_rear_clamp_collar.step

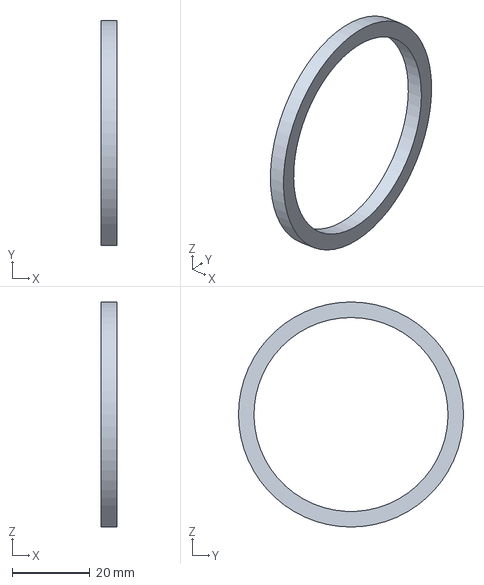
[picture p113: CAD file, 2026-10-21]
cad/m3_review/revised_parts/output_rear_clamp_collar.step
4.00 x 58.0 x 58.0 mm
