alan9900/Thermal-coupling-analysis-under-drive-control-integration/cad/m3_review/revised_parts/intermediate_shaft.step

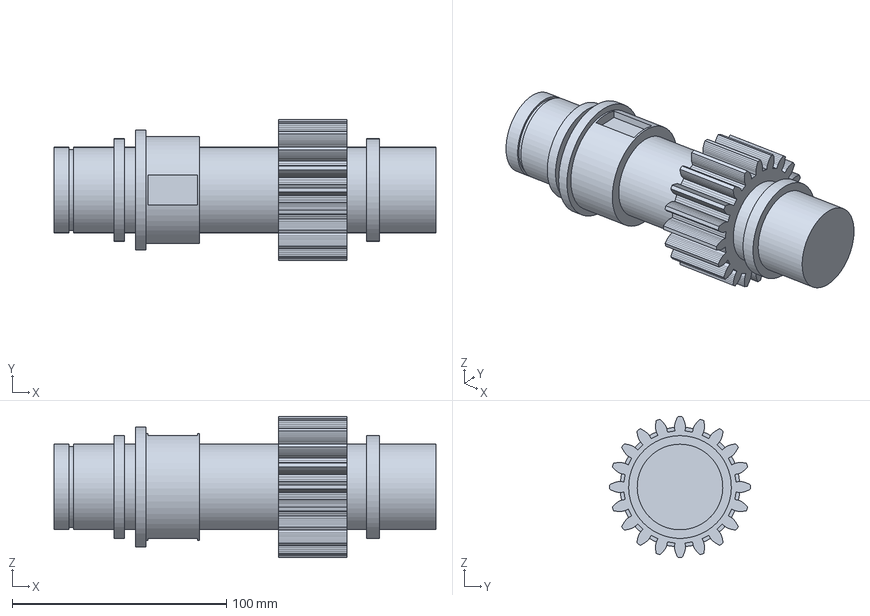
[picture p114: CAD file, 2026-10-21]
cad/m3_review/revised_parts/intermediate_shaft.step
178.5 x 66.0 x 66.0 mm
