alan9900/Thermal-coupling-analysis-under-drive-control-integration/cad/m3_review/revised_parts/motor_input_coupling.step

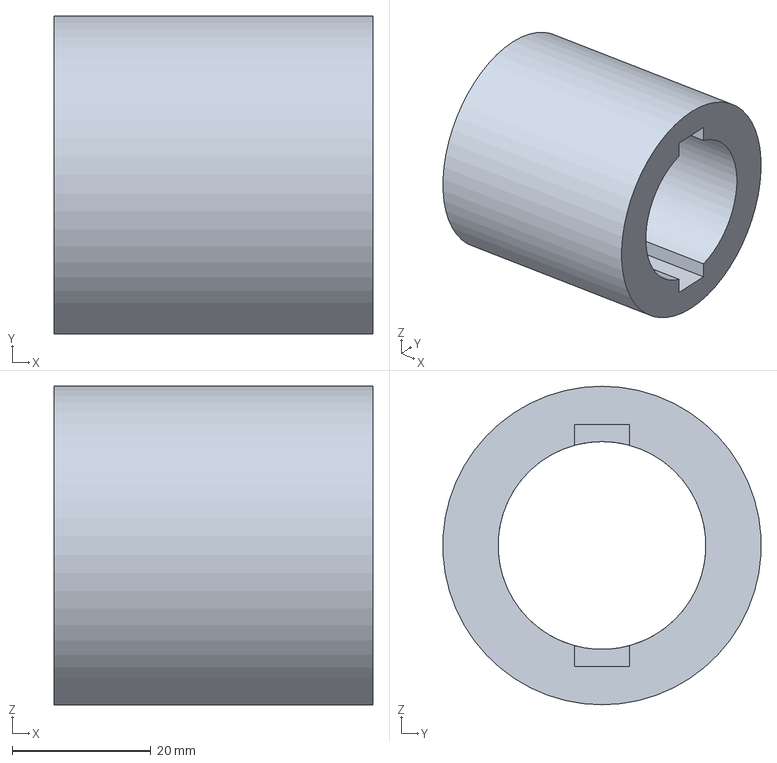
[picture p115: CAD file, 2026-10-21]
cad/m3_review/revised_parts/motor_input_coupling.step
46.0 x 45.9 x 46.0 mm
