alan9900/Thermal-coupling-analysis-under-drive-control-integration/cad/m3_review/revised_parts/intermediate_front_outer_retainer.step

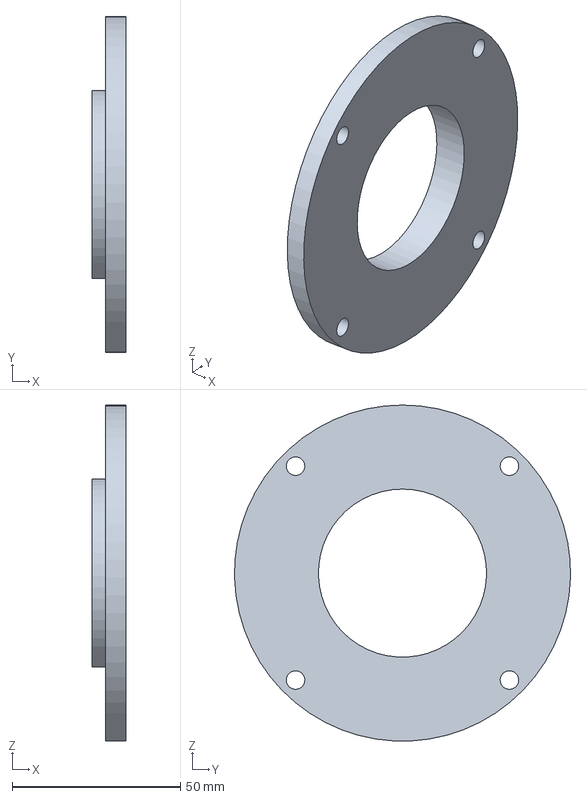
[picture p116: CAD file, 2026-10-21]
cad/m3_review/revised_parts/intermediate_front_outer_retainer.step
10.0 x 100.0 x 99.9 mm
