alan9900/Thermal-coupling-analysis-under-drive-control-integration/cad/m3_review/revised_parts/halfshaft_drive_dowel_2.step

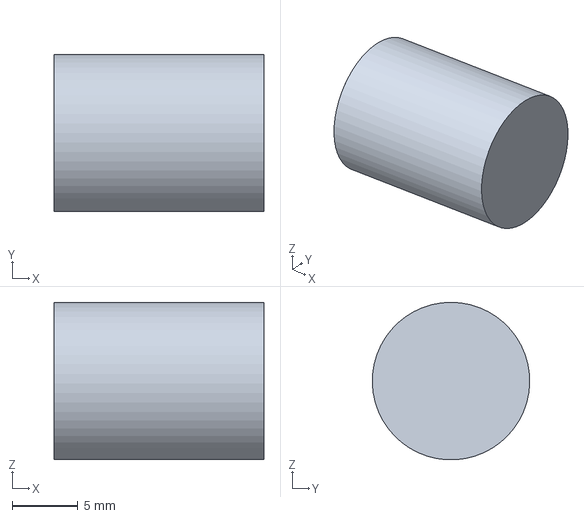
[picture p117: CAD file, 2026-10-21]
cad/m3_review/revised_parts/halfshaft_drive_dowel_2.step
16.0 x 12.0 x 12.0 mm
