alan9900/Thermal-coupling-analysis-under-drive-control-integration/cad/m3_review/revised_parts/caliper.step

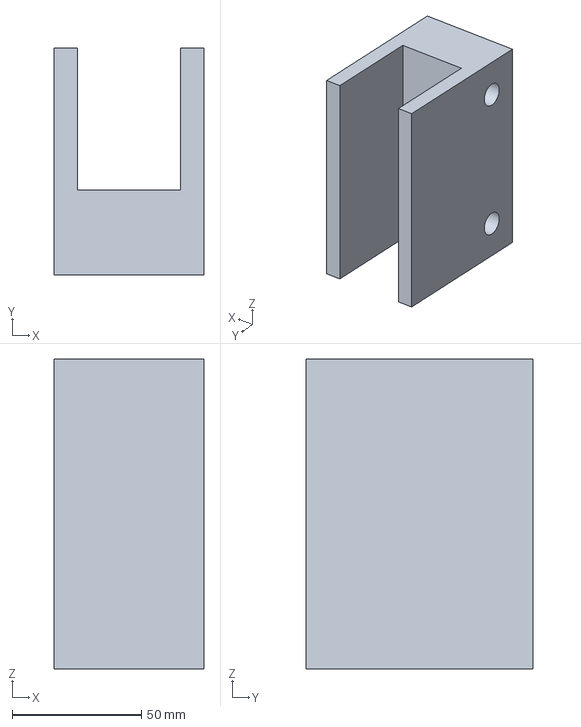
[picture p118: CAD file, 2026-10-21]
cad/m3_review/revised_parts/caliper.step
58.0 x 88.0 x 120.0 mm
