alan9900/Thermal-coupling-analysis-under-drive-control-integration/cad/m3_review/revised_parts/intermediate_bearing_1.step

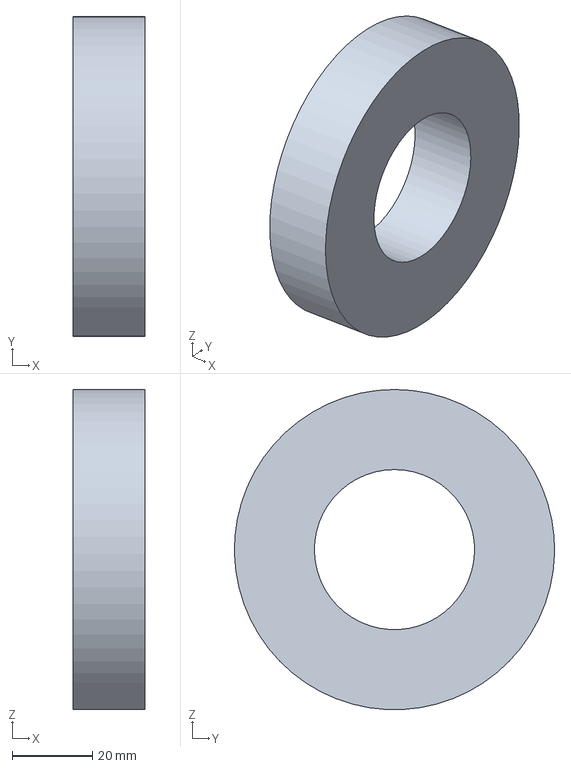
[picture p119: CAD file, 2026-10-21]
cad/m3_review/revised_parts/intermediate_bearing_1.step
18.0 x 80.0 x 79.9 mm
