alan9900/Thermal-coupling-analysis-under-drive-control-integration/cad/m3_review/revised_parts/stage2_gear.step

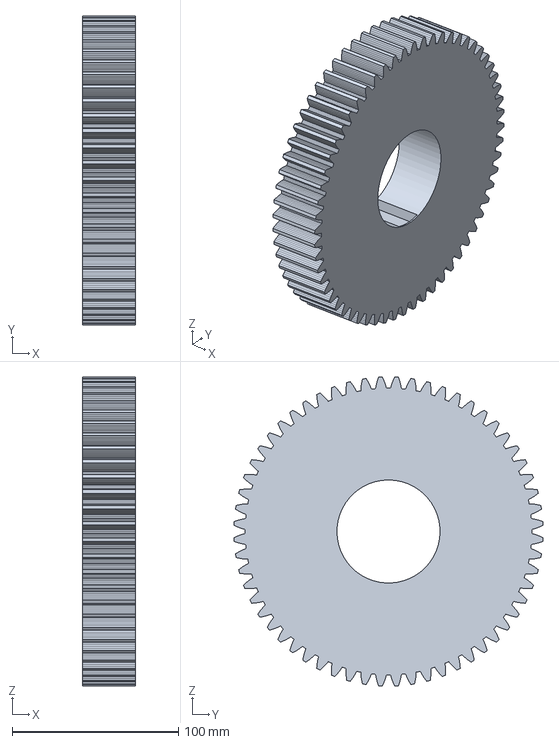
[picture p120: CAD file, 2026-10-21]
cad/m3_review/revised_parts/stage2_gear.step
32.0 x 185.8 x 185.8 mm
