alan9900/Thermal-coupling-analysis-under-drive-control-integration/cad/m3_review/revised_parts/output_front_seal.step

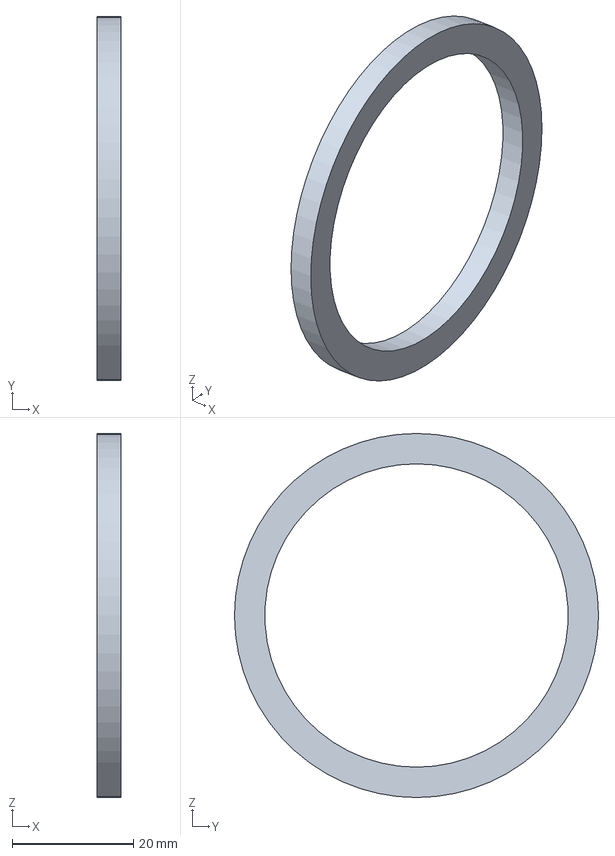
[picture p121: CAD file, 2026-10-21]
cad/m3_review/revised_parts/output_front_seal.step
4.00 x 60.0 x 60.0 mm
