alan9900/Thermal-coupling-analysis-under-drive-control-integration/cad/m3_review/revised_parts/intermediate_gear_key_opposed.step

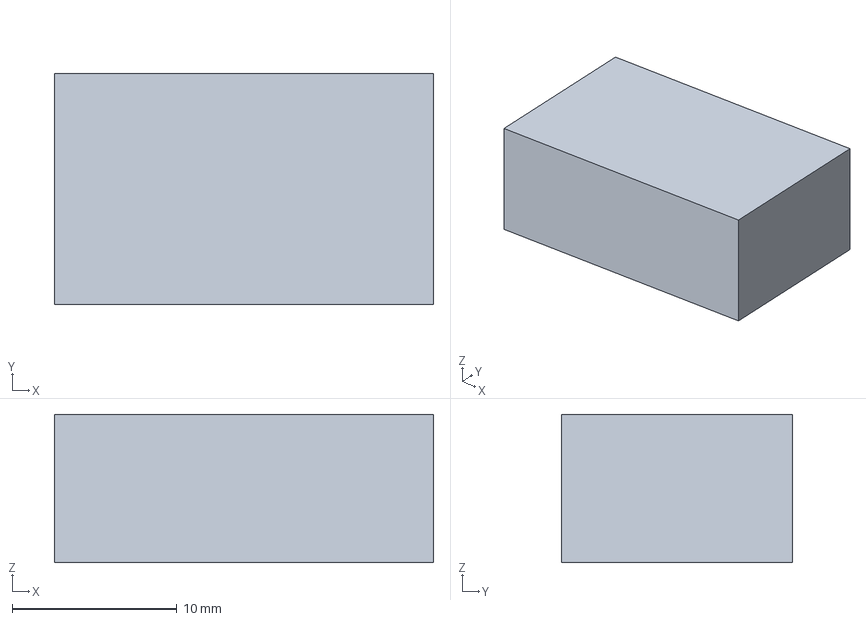
[picture p122: CAD file, 2026-10-21]
cad/m3_review/revised_parts/intermediate_gear_key_opposed.step
23.0 x 14.0 x 9.00 mm
