alan9900/Thermal-coupling-analysis-under-drive-control-integration/cad/m3_review/revised_parts/output_gear_key_opposed.step

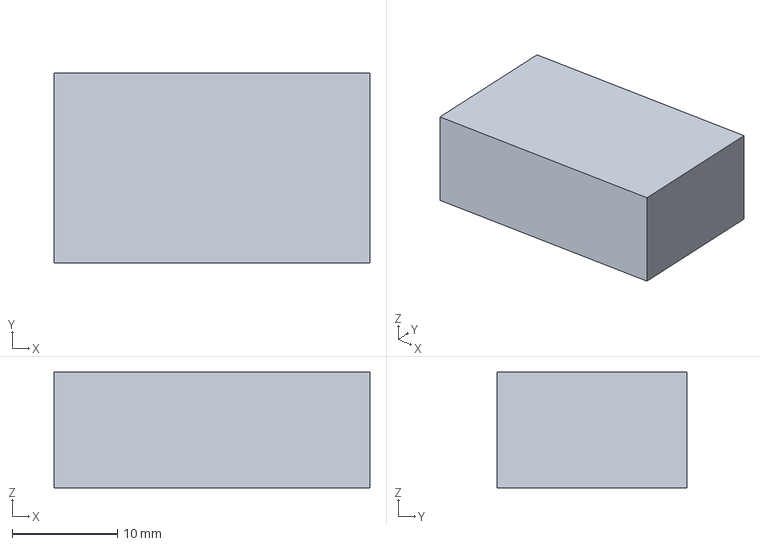
[picture p123: CAD file, 2026-10-21]
cad/m3_review/revised_parts/output_gear_key_opposed.step
30.0 x 18.0 x 11.0 mm
