alan9900/Thermal-coupling-analysis-under-drive-control-integration/cad/m3_review/revised_parts/output_front_retaining_ring.step

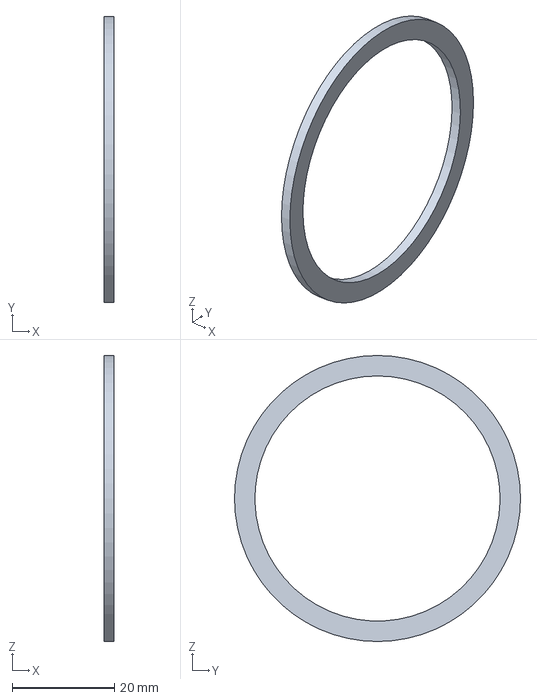
[picture p124: CAD file, 2026-10-21]
cad/m3_review/revised_parts/output_front_retaining_ring.step
2.00 x 56.0 x 56.0 mm
