alan9900/Thermal-coupling-analysis-under-drive-control-integration/cad/m3_review/revised_parts/hub_removable_sleeve.step

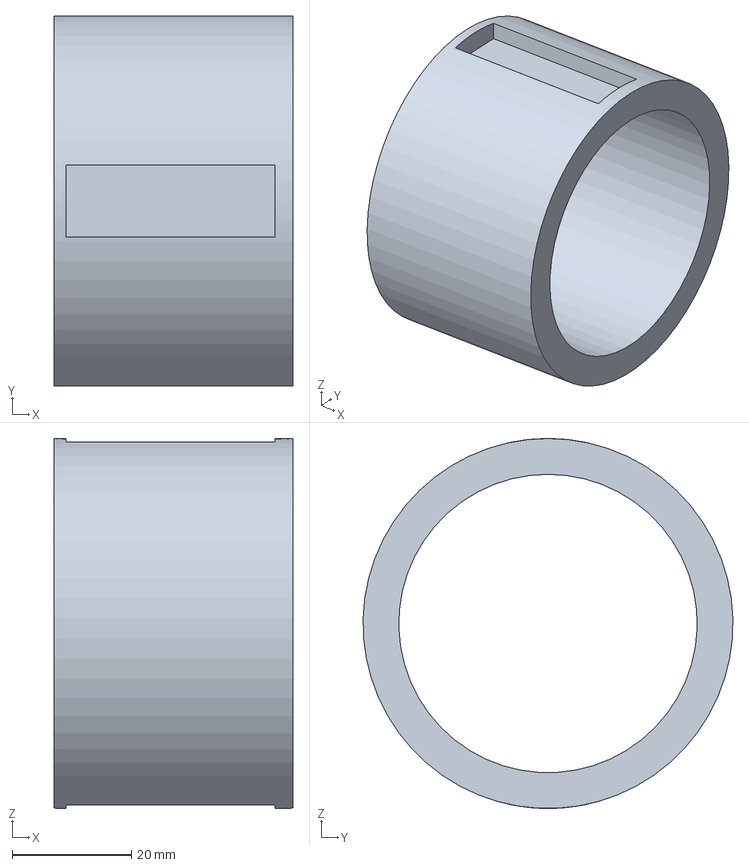
[picture p125: CAD file, 2026-10-21]
cad/m3_review/revised_parts/hub_removable_sleeve.step
40.0 x 62.0 x 62.0 mm
