alan9900/Thermal-coupling-analysis-under-drive-control-integration/cad/m3_review/revised_parts/hub_front_axial_collar.step

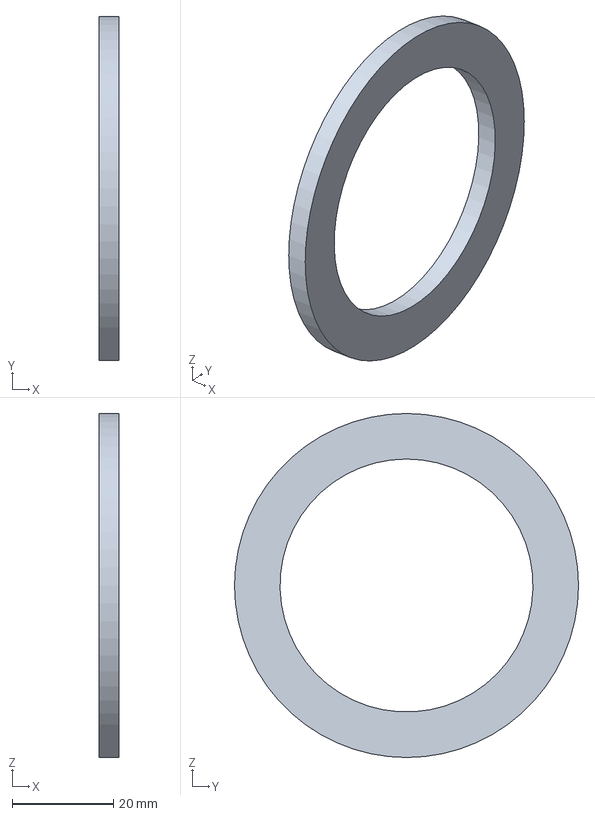
[picture p126: CAD file, 2026-10-21]
cad/m3_review/revised_parts/hub_front_axial_collar.step
4.00 x 68.0 x 68.0 mm
