alan9900/Thermal-coupling-analysis-under-drive-control-integration/cad/m3_review/revised_parts/halfshaft_key_-1.step

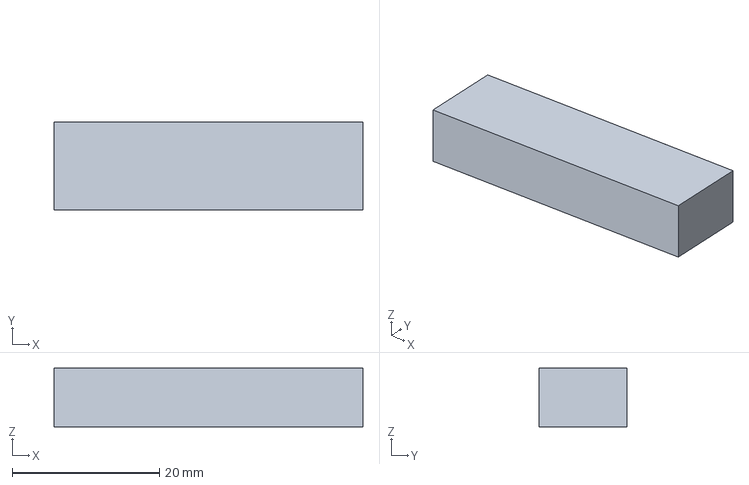
[picture p127: CAD file, 2026-10-21]
cad/m3_review/revised_parts/halfshaft_key_-1.step
42.0 x 12.0 x 8.00 mm
