alan9900/Thermal-coupling-analysis-under-drive-control-integration/cad/m3_review/revised_parts/motor_winding.step

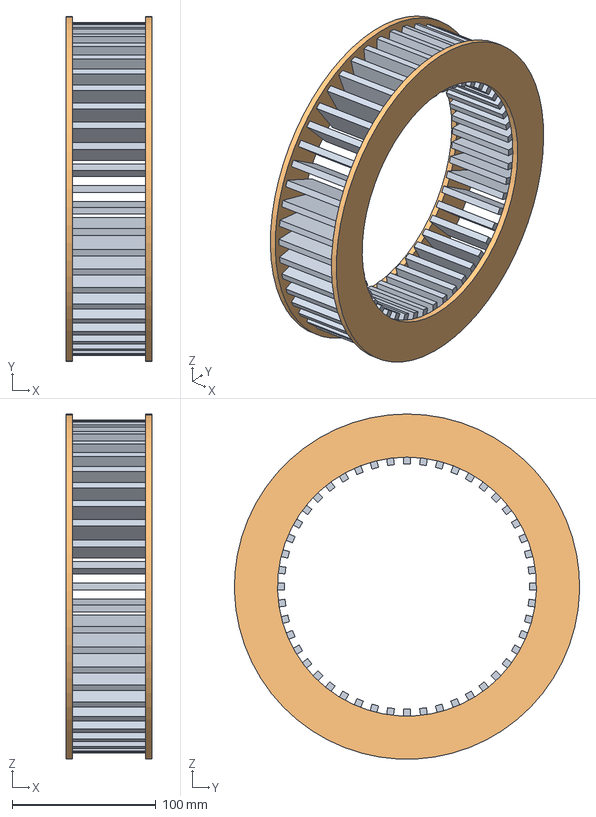
[picture p128: CAD file, 2026-10-21]
cad/m3_review/revised_parts/motor_winding.step
59.6 x 239.9 x 239.8 mm
