alan9900/Thermal-coupling-analysis-under-drive-control-integration/cad/m3_review/revised_parts/coupling_motor_key_1.step

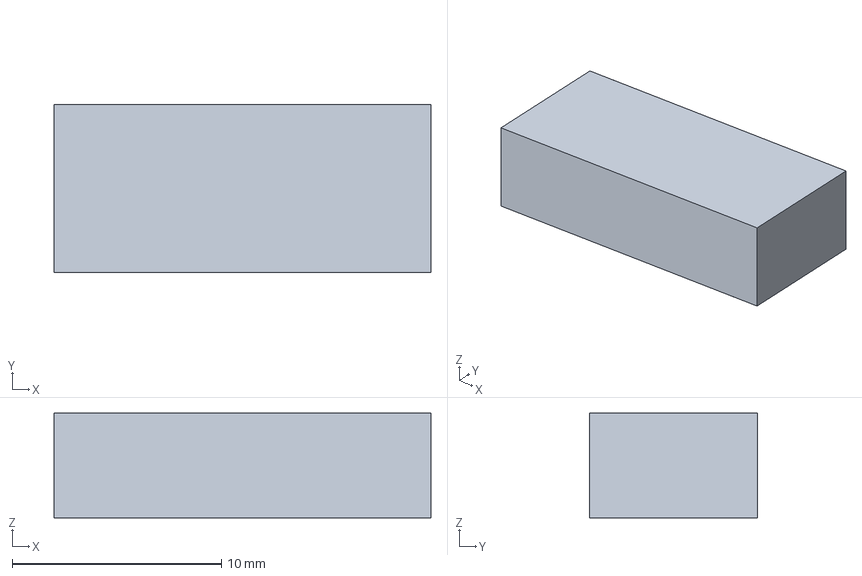
[picture p129: CAD file, 2026-10-21]
cad/m3_review/revised_parts/coupling_motor_key_1.step
18.0 x 8.00 x 5.00 mm
