alan9900/Thermal-coupling-analysis-under-drive-control-integration/cad/m3_review/revised_parts/intermediate_rear_outer_retainer.step

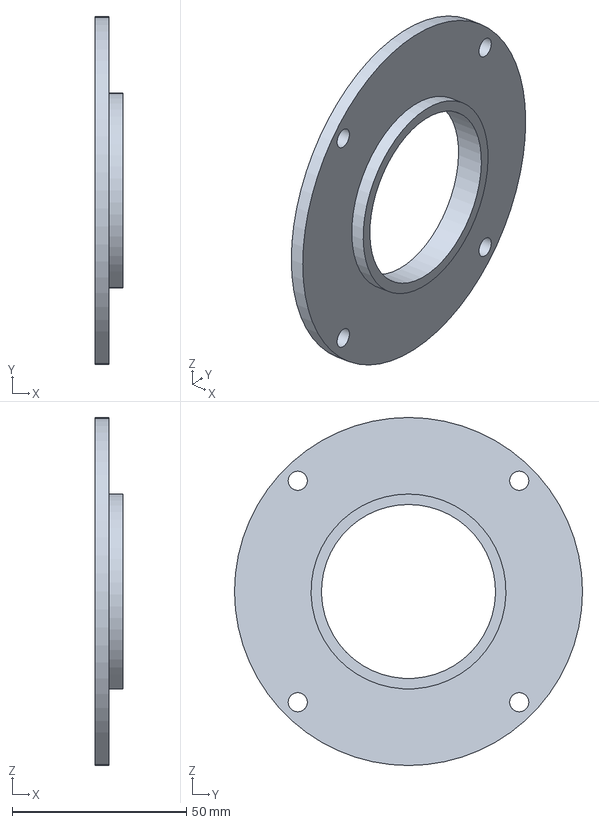
[picture p130: CAD file, 2026-10-21]
cad/m3_review/revised_parts/intermediate_rear_outer_retainer.step
8.00 x 100.0 x 100.0 mm
