alan9900/Thermal-coupling-analysis-under-drive-control-integration/cad/m3_review/revised_parts/halfshaft_removable_sleeve.step

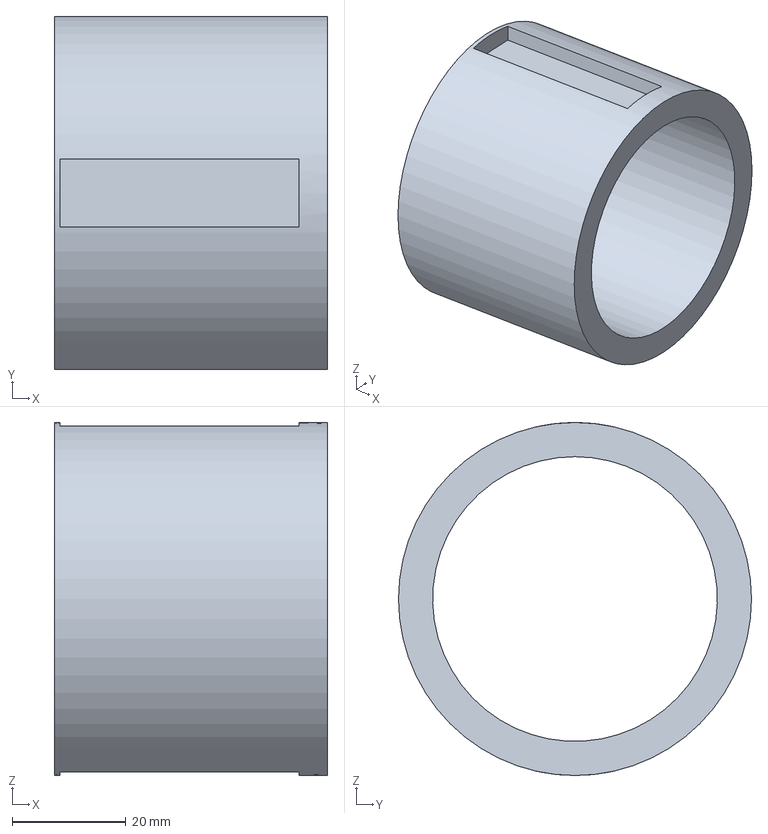
[picture p131: CAD file, 2026-10-21]
cad/m3_review/revised_parts/halfshaft_removable_sleeve.step
48.0 x 62.0 x 62.0 mm
