alan9900/Thermal-coupling-analysis-under-drive-control-integration/cad/m3_review/revised_parts/output_halfshaft_flange.step

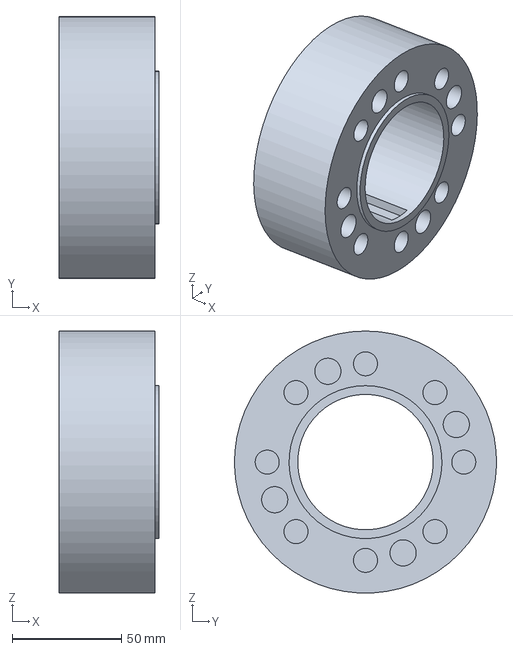
[picture p132: CAD file, 2026-10-21]
cad/m3_review/revised_parts/output_halfshaft_flange.step
46.0 x 120.0 x 119.9 mm
