alan9900/Thermal-coupling-analysis-under-drive-control-integration/(list of files, cad)

Other CAD files:
cad/m3/CaseC/shield_standoff_0_0.step
cad/m3_helical/CaseC_d50_helical_thermal.step
cad/m3_review/CaseB_d50_thermal.step
cad/m3/CaseC/shield_standoff_0_1.step
cad/m3_helical/parts/oil_inventory_thermal.step
cad/m3_review/Case0_d45_thermal.step
cad/m3/base_parts/output_bearing_2.step
cad/m3/base_parts/input_bearing_2.step
cad/m3/base_parts/intermediate_bearing_1.step
cad/m3_review/revised_parts/input_bearing_2.step
cad/m3_review/revised_parts/halfshaft_drive_dowel_1.step
cad/m3_review/revised_parts/motor_rotor_other.step
cad/m3_review/revised_parts/intermediate_gear_key.step
cad/m3_review/revised_parts/output_bearing_1.step
cad/m3_review/revised_parts/halfshaft_drive_dowel_3.step
cad/m3_review/revised_parts/motor_stator.step
cad/m3_review/revised_parts/output_rear_seal.step
cad/m3/base_parts/motor_mount_bolt_3.step
cad/m3/base_parts/motor_mount_bolt_4.step
cad/m3_review/revised_parts/caliper_mount_bolt_head_1.step
cad/m3_review/revised_parts/caliper_mount_bolt_head_2.step
cad/m3_review/revised_parts/disc_hub_bolt_3.step
cad/m3_review/revised_parts/disc_hub_bolt_4.step
cad/m3_review/revised_parts/disc_hub_bolt_head_1.step
cad/m3_review/revised_parts/disc_hub_bolt_head_2.step
cad/m3_review/revised_parts/disc_hub_nut_2.step
cad/m3_review/revised_parts/disc_hub_nut_5.step
cad/m3_review/revised_parts/halfshaft_bolt_2.step
cad/m3_review/revised_parts/halfshaft_bolt_3.step
cad/m3_review/revised_parts/halfshaft_bolt_4.step
cad/m3_review/revised_parts/halfshaft_bolt_6.step
cad/m3_review/revised_parts/halfshaft_key_1.step
cad/m3_review/revised_parts/input_front_cap_bolt_1.step
cad/m3_review/revised_parts/input_front_cap_bolt_2.step
cad/m3_review/revised_parts/input_front_cap_bolt_3.step
cad/m3_review/revised_parts/input_front_cap_bolt_4.step
cad/m3_review/revised_parts/input_rear_cap_bolt_1.step
cad/m3_review/revised_parts/input_rear_cap_bolt_2.step
cad/m3_review/revised_parts/input_rear_cap_bolt_3.step
cad/m3_review/revised_parts/intermediate_front_cap_bolt_1.step
cad/m3_review/revised_parts/intermediate_rear_cap_bolt_3.step
cad/m3_review/revised_parts/motor_mount_bolt_2.step
cad/m3_review/revised_parts/output_front_cap_bolt_1.step
cad/m3_review/revised_parts/output_front_cap_bolt_4.step
cad/m3_review/revised_parts/output_rear_cap_bolt_2.step
cad/m3_review/revised_parts/output_rear_cap_bolt_3.step
cad/m3_review/revised_parts/output_rear_cap_bolt_4.step
