alan9900/Thermal-coupling-analysis-under-drive-control-integration/data/raw/m0/epa_mg2/3c- 2010 Toyota Prius 60kW 650V MG2 EMOT - ORNL Test Data File.xlsx

Sheet: 650V Inv Only
2010 Toyota Prius 60kW 650V MG2 EMOT - ORNL Test Data
Inverter Only - Efficiency Data
The following test data were measured and obtained by Oak Ridge National Laboratory and sent via email communication by T. Burress, Oak Ridge National Labs, personal communication
SUGGESTED CITATION: 2010 Toyota Prius 60kW 650V MG2 EMOT - ALPHA Map Package. Version 2023-04. Ann Arbor, MI: US EPA, National Vehicle and Fuel Emissions Laboratory, National Center for Advanced Technology, 2023.
 |  | Speed (RPM)
 |  | 500 | 1000 | 2000 | 3000 | 4000 | 5000 | 6000 | 7000 | 8000 | 9000 | 10000 | 11000 | 12000 | 13000
Torque (Nm) | 0 | 43.33 | 66.51 | 82.89 | 88.48 | 91.80 | 91.49 | 91.69 | 92.79 | 95.39 | 96.73 | 97.18 | 97.06 | 97.00 | 97.11
 | 10 | 70.11 | 82.47 | 90.01 | 92.89 | 94.40 | 95.73 | 96.35 | 98.06 | 98.51 | 98.78 | 98.48 | 98.73 | 98.66 | 98.72
 | 20 | 77.69 | 87.19 | 92.78 | 94.98 | 95.93 | 96.99 | 98.34 | 98.86 | 98.96 | 99.04 | 99.06 | 99.07 | 99.06 | 99.13
 | 30 | 81.12 | 89.14 | 93.86 | 95.70 | 96.58 | 97.86 | 98.87 | 98.99 | 99.01 | 99.10 | 99.16 | 99.10 | 99.09
 | 40 | 83.01 | 90.39 | 94.59 | 96.02 | 96.94 | 98.80 | 98.93 | 99.08 | 99.10 | 99.07 | 99.10
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
