alan9900/Thermal-coupling-analysis-under-drive-control-integration/results/m0/epa_emot_grid.csv

speed_rpm | torque_Nm | electrical_power_W | mechanical_power_W | combined_loss_W | inside_limits
0.0 | -200.0 | 11028.84258427491 | -0.0 | 11028.84258427491 | False
0.0 | -190.0 | 8480.07166786648 | -0.0 | 8480.07166786648 | True
0.0 | -180.0 | 6851.843612512847 | -0.0 | 6851.843612512847 | True
0.0 | -170.0 | 5710.24995202383 | -0.0 | 5710.24995202383 | True
0.0 | -160.0 | 5019.986854825463 | -0.0 | 5019.986854825463 | True
0.0 | -150.0 | 4771.509352478536 | -0.0 | 4771.509352478536 | True
0.0 | -140.0 | 4353.3683946881765 | -0.0 | 4353.3683946881765 | True
0.0 | -130.0 | 3885.482377043334 | -0.0 | 3885.482377043334 | True
0.0 | -120.0 | 3567.7615691210244 | -0.0 | 3567.7615691210244 | True
0.0 | -110.0 | 3103.3653948322776 | -0.0 | 3103.3653948322776 | True
0.0 | -100.0 | 2581.995196258932 | -0.0 | 2581.995196258932 | True
0.0 | -90.0 | 2111.037500456866 | -0.0 | 2111.037500456866 | True
0.0 | -80.0 | 1725.2786440582886 | -0.0 | 1725.2786440582886 | True
0.0 | -70.0 | 1419.5999931443023 | -0.0 | 1419.5999931443023 | True
0.0 | -60.0 | 1172.7977667503108 | -0.0 | 1172.7977667503108 | True
0.0 | -50.0 | 964.4086623448684 | -0.0 | 964.4086623448684 | True
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
