alan9900/Thermal-coupling-analysis-under-drive-control-integration/results/m0/ornl_paired_drive_efficiency.csv

speed_rpm | torque_Nm | motor_efficiency_norm | inverter_efficiency_norm | combined_efficiency_norm
500 | 10 | 0.8624740759335187 | 0.7011447903609077 | 0.6047192051621246
1000 | 10 | 0.8838080506367644 | 0.8247294224560391 | 0.7289025031636563
2000 | 10 | 0.8913222617334395 | 0.9000533726496048 | 0.8022376077908561
3000 | 10 | 0.8889420343901133 | 0.9289178936840028 | 0.8257541621928365
4000 | 10 | 0.8973446304524437 | 0.9440004854539268 | 0.8470937667665814
5000 | 10 | 0.9061874231885628 | 0.9573033139266371 | 0.8674962232570511
6000 | 10 | 0.8831759988667937 | 0.9635375097365313 | 0.8509732026071839
7000 | 10 | 0.9065175990119537 | 0.9805943608932113 | 0.8889260456415752
8000 | 10 | 0.8905550626334809 | 0.9851474905980662 | 0.8773280851927773
9000 | 10 | 0.8944492694191756 | 0.9877703556208224 | 0.8835104729389637
10000 | 10 | 0.9073291817427515 | 0.9847831004831931 | 0.8935224447555052
11000 | 10 | 0.8970865186088979 | 0.987334055755274 | 0.8857240707815023
12000 | 10 | 0.8812224525339399 | 0.9866239710121522 | 0.8694351954641037
13000 | 10 | 0.8535916772857738 | 0.9872061619688435 | 0.8426709636218364
500 | 20 | 0.8769018823455837 | 0.7769448995841853 | 0.6813044449241726
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
