alan9900/Thermal-coupling-analysis-under-drive-control-integration/results/m0_acceptance/geometry_assumption_sensitivity.csv

static_rear_fraction | cg_height_m | rolling_radius_m | rear_dynamic_fraction | disc_torque_06g_Nm | disc_energy_06g_kJ | motor_rpm_160
0.5 | 0.45 | 0.32 | 0.402350813743219 | 682.052224231465 | 139.70514366084 | 11936.6207318922
0.5 | 0.45 | 0.33 | 0.402350813743219 | 703.366356238698 | 139.70514366084 | 11574.9049521378
0.5 | 0.45 | 0.34 | 0.402350813743219 | 724.680488245931 | 139.70514366084 | 11234.4665711926
0.5 | 0.55 | 0.32 | 0.380650994575045 | 645.26738517179 | 132.170484227446 | 11936.6207318922
0.5 | 0.55 | 0.33 | 0.380650994575045 | 665.431990958409 | 132.170484227446 | 11574.9049521378
0.5 | 0.55 | 0.34 | 0.380650994575045 | 685.596596745027 | 132.170484227446 | 11234.4665711926
0.5 | 0.65 | 0.32 | 0.358951175406872 | 608.482546112116 | 124.635824794053 | 11936.6207318922
0.5 | 0.65 | 0.33 | 0.358951175406872 | 627.497625678119 | 124.635824794053 | 11574.9049521378
0.5 | 0.65 | 0.34 | 0.358951175406872 | 646.512705244123 | 124.635824794053 | 11234.4665711926
0.55 | 0.45 | 0.32 | 0.452350813743219 | 766.810624231465 | 157.066254771951 | 11936.6207318922
0.55 | 0.45 | 0.33 | 0.452350813743219 | 790.773456238698 | 157.066254771951 | 11574.9049521378
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
