alan9900/Thermal-coupling-analysis-under-drive-control-integration/results/m0_acceptance/radius_speed_sensitivity.csv

radius_m | rpm_at_160
0.32 | 11936.6207318922
0.33 | 11574.9049521378
0.34 | 11234.4665711926
