alan9900/Thermal-coupling-analysis-under-drive-control-integration/results/m1/energy_and_independent_sides.png

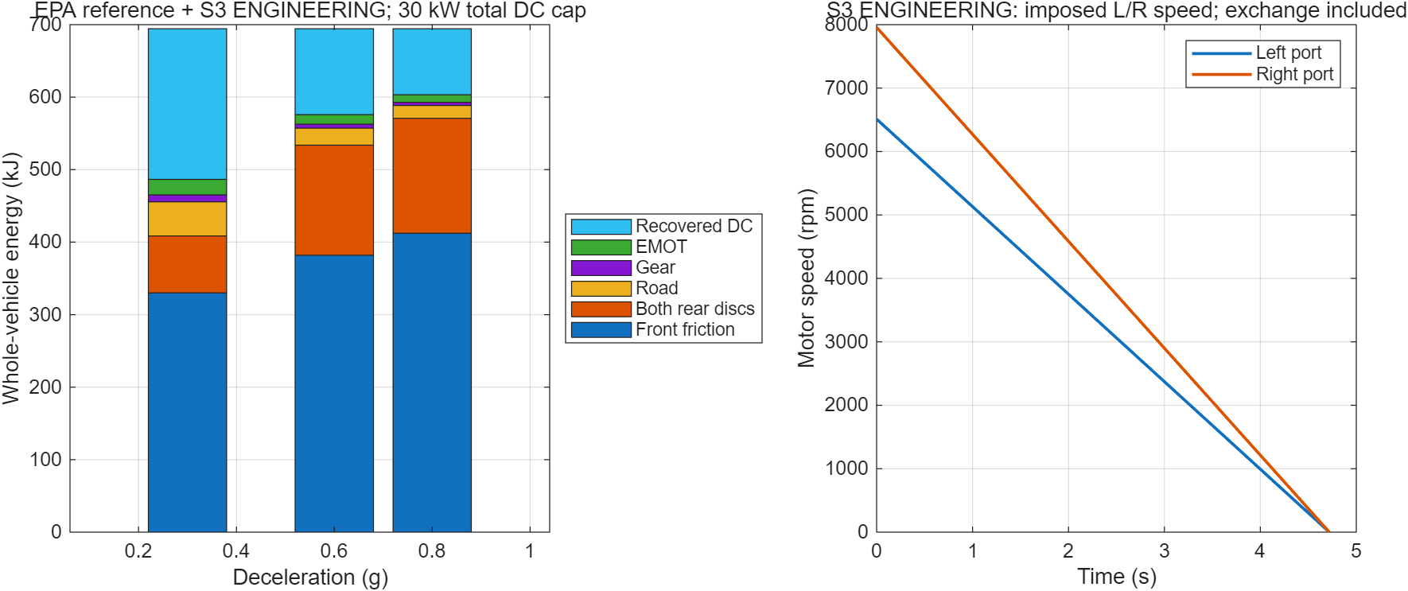
results/m1/energy_and_independent_sides.png
