alan9900/Thermal-coupling-analysis-under-drive-control-integration/results/m1/engineering/oat_sensitivity.png

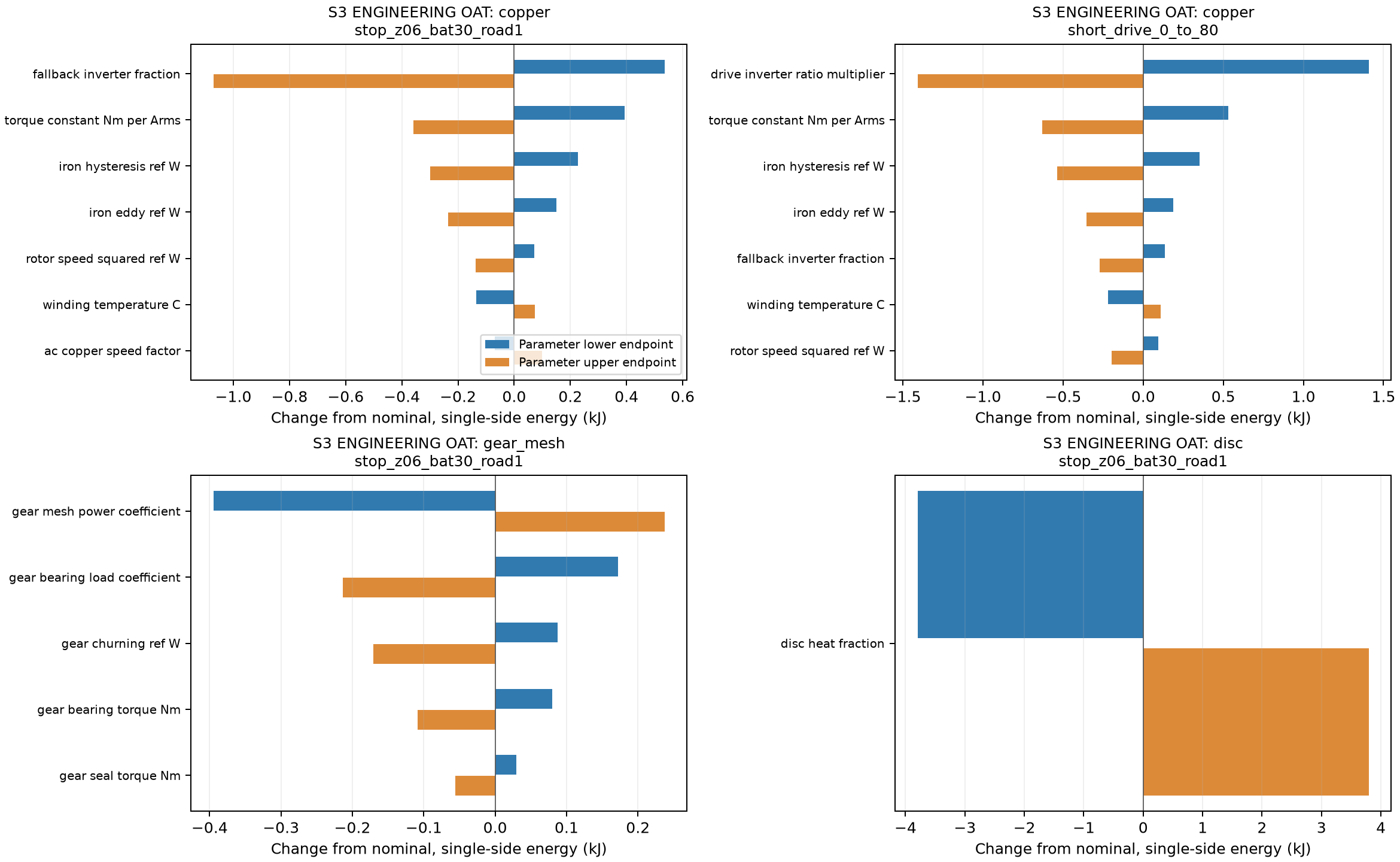
results/m1/engineering/oat_sensitivity.png
