alan9900/Thermal-coupling-analysis-under-drive-control-integration/results/m2/coupling_sensitivity.png

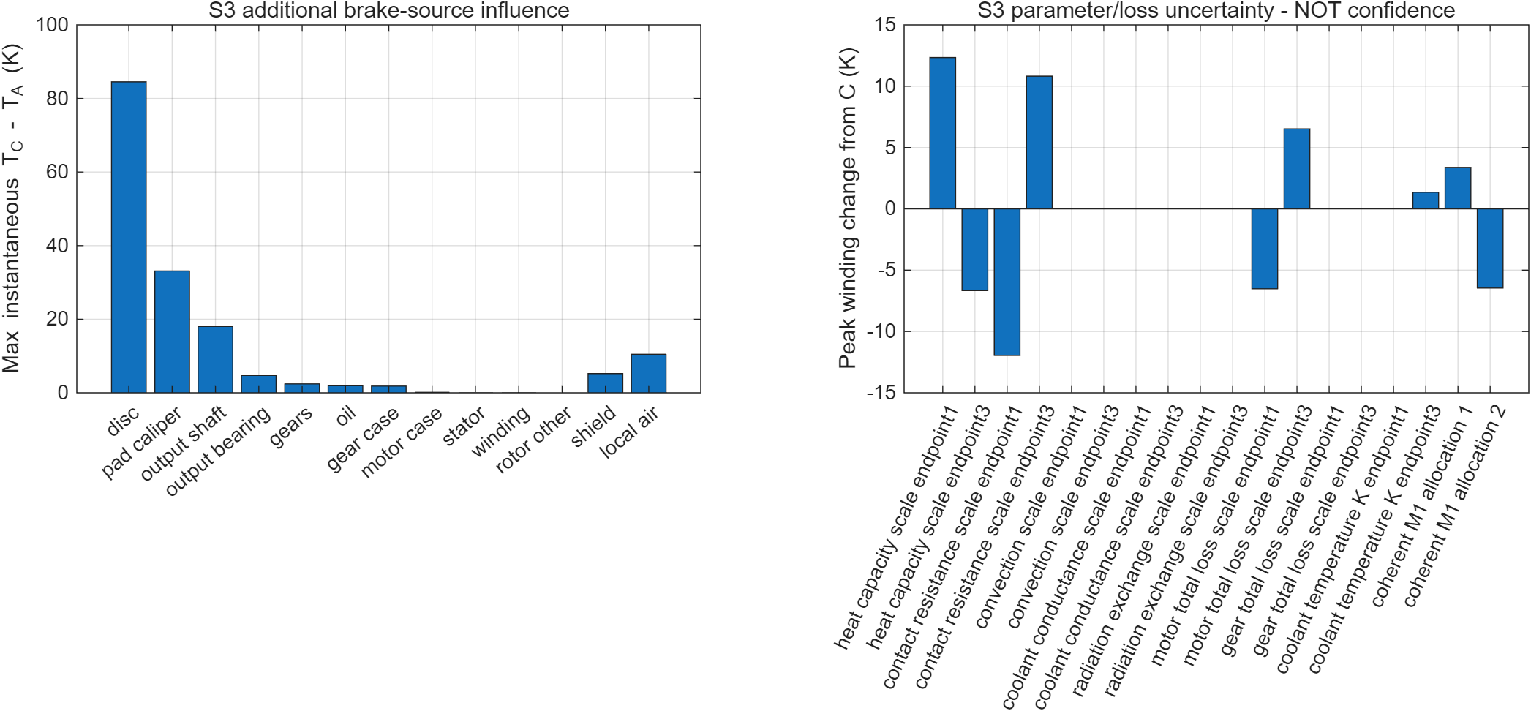
results/m2/coupling_sensitivity.png
