alan9900/Thermal-coupling-analysis-under-drive-control-integration/results/m3_review/capacity_comparison.png

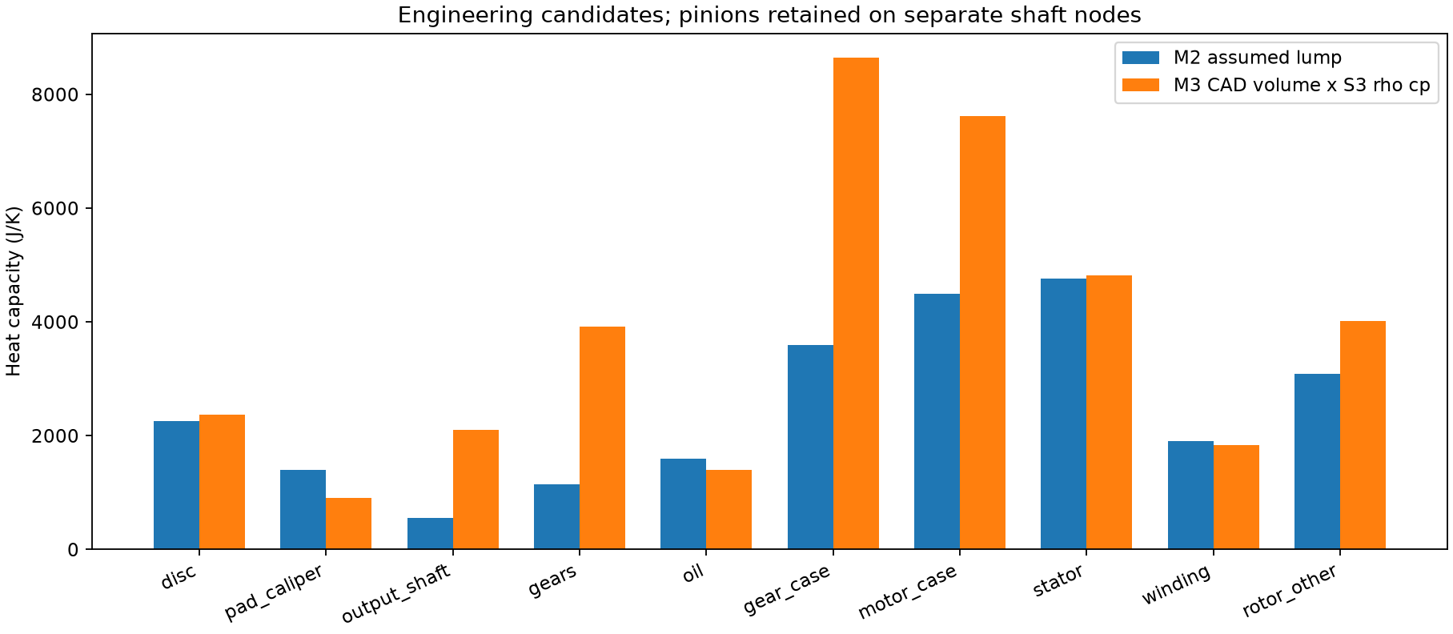
results/m3_review/capacity_comparison.png
