alan9900/Thermal-coupling-analysis-under-drive-control-integration/results/m3_review/contact_network.png

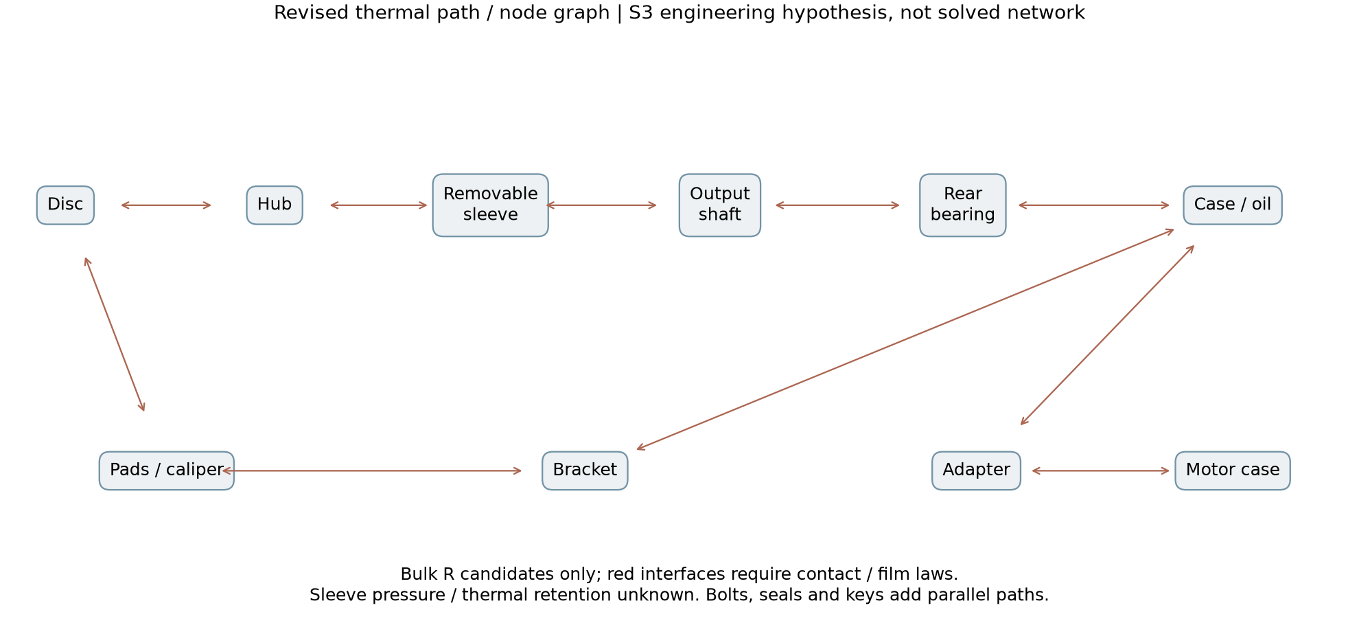
results/m3_review/contact_network.png
