alan9900/Thermal-coupling-analysis-under-drive-control-integration/results/m3_review/output_gear_clearance/dimensioned_sections.png

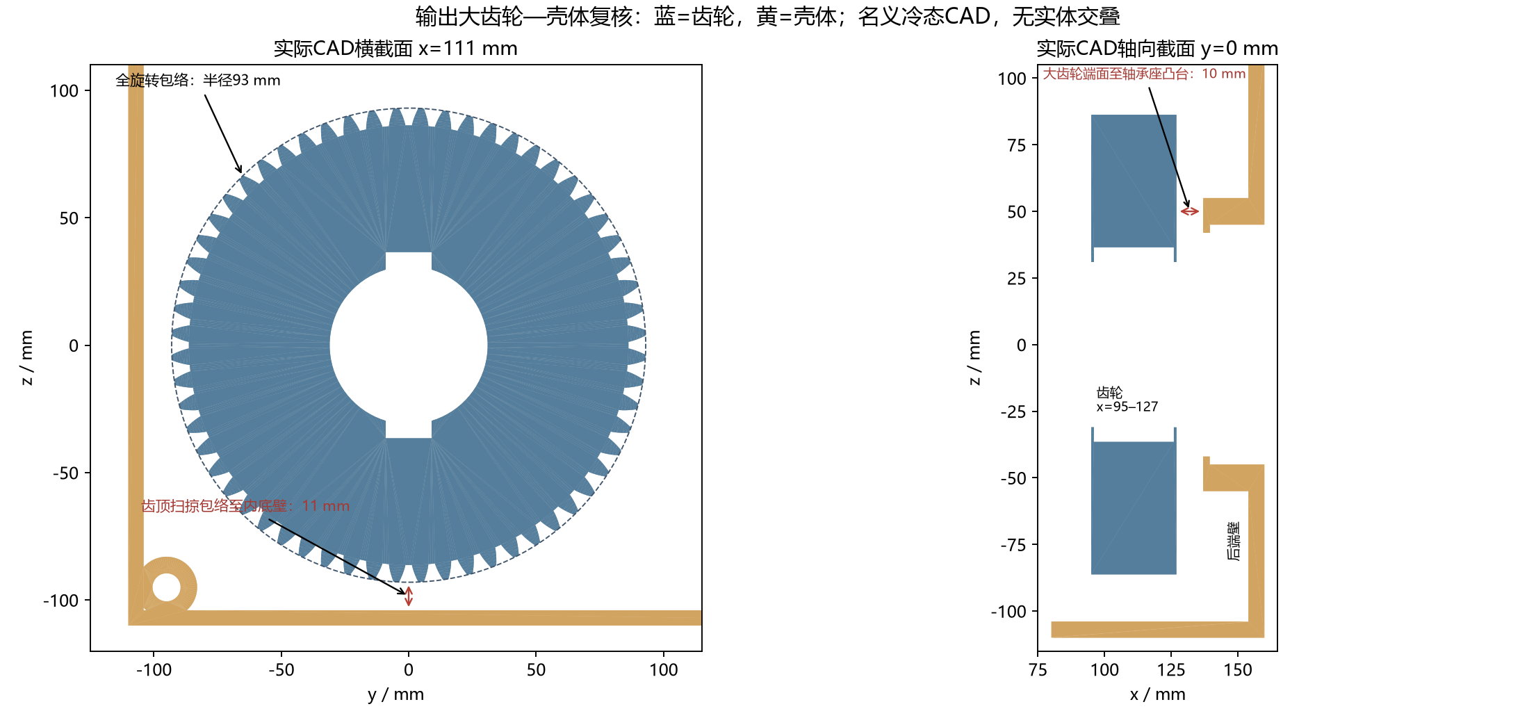
results/m3_review/output_gear_clearance/dimensioned_sections.png
