alan9900/Thermal-coupling-analysis-under-drive-control-integration/results/m3_review/shaft_sections.png

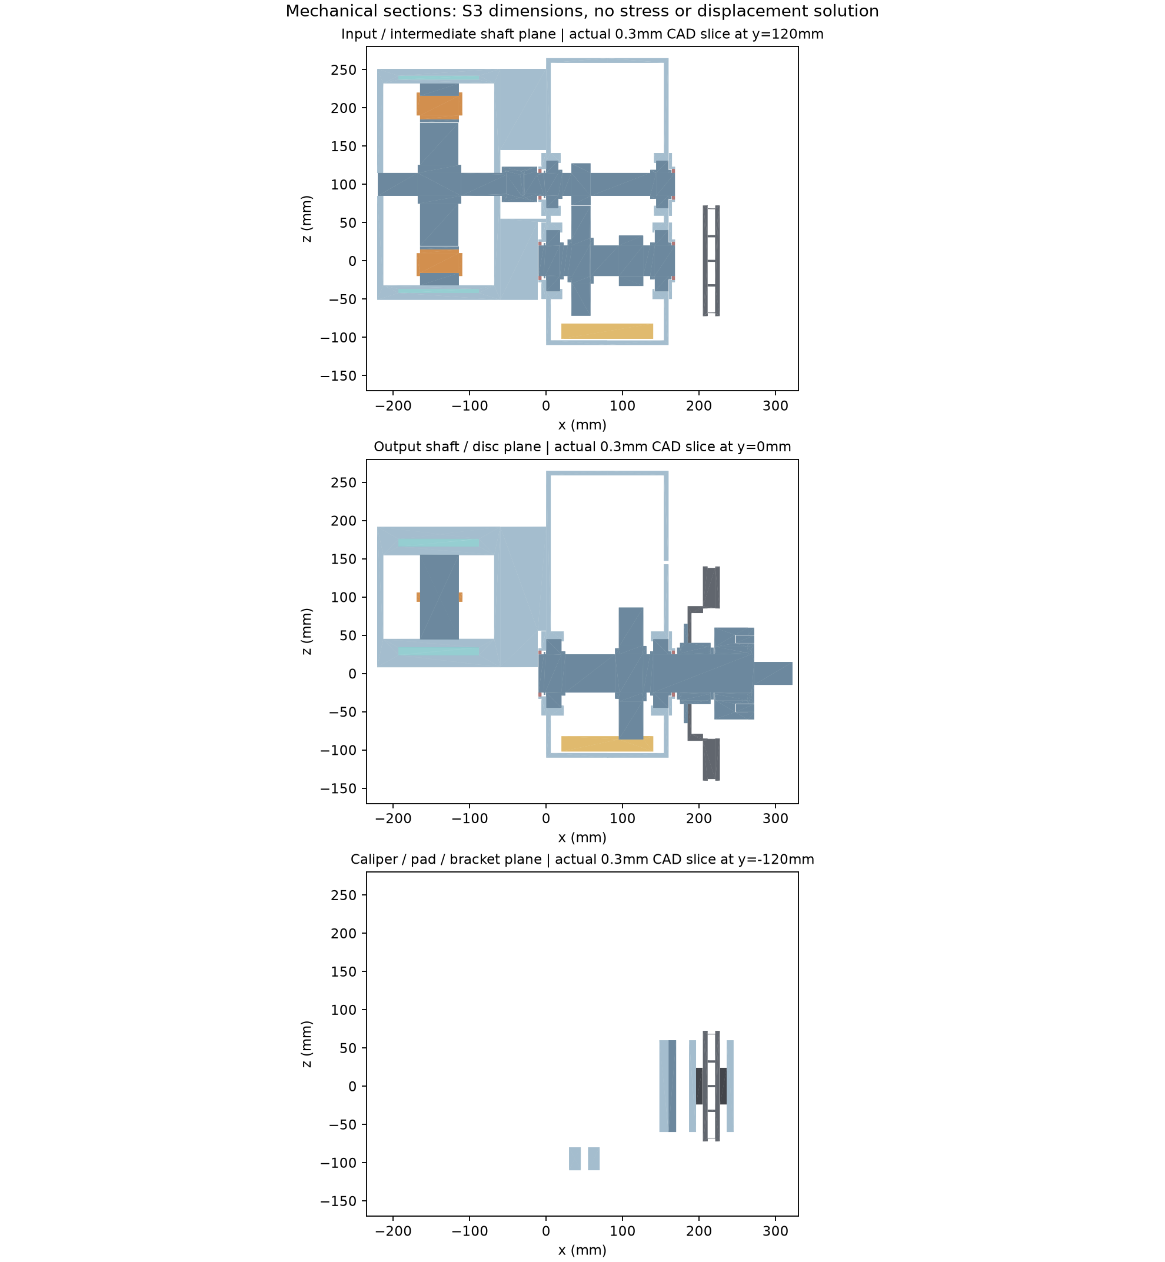
results/m3_review/shaft_sections.png
