alan9900/Thermal-coupling-analysis-under-drive-control-integration/results/m4/attempts/case0_mesh.png

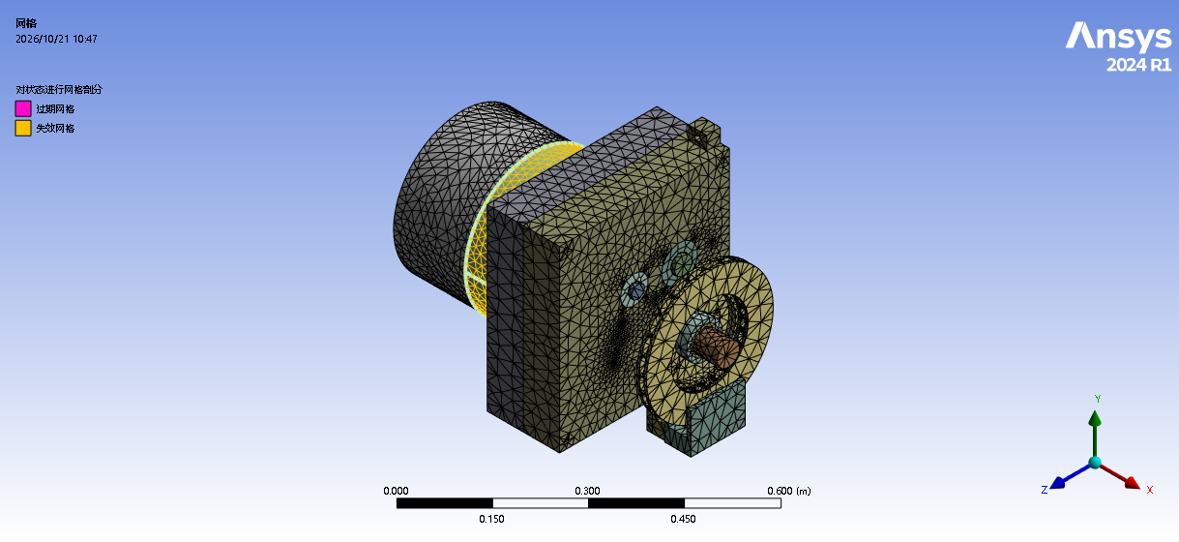
results/m4/attempts/case0_mesh.png
