alan9900/Thermal-coupling-analysis-under-drive-control-integration/results/m4/meshes/mesh_normal24/actual_mesh.png

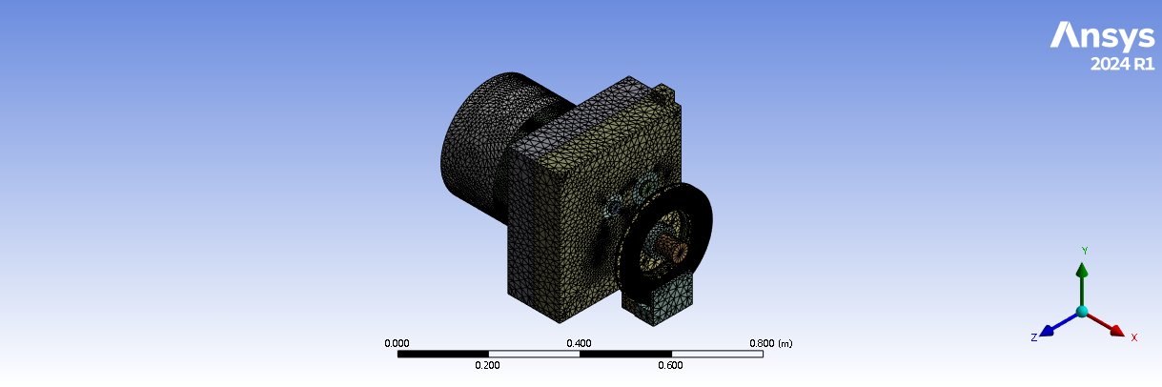
results/m4/meshes/mesh_normal24/actual_mesh.png
