alan9900/Thermal-coupling-analysis-under-drive-control-integration/results/m4/pilot_disc_actual_FE.png

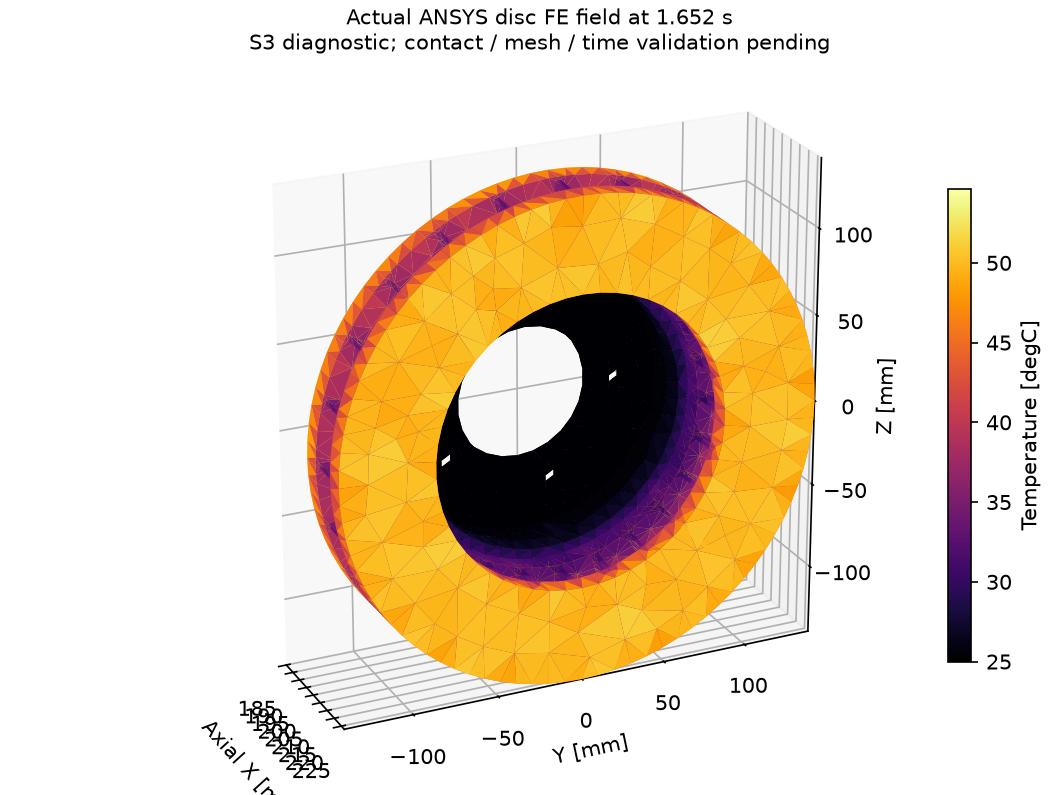
results/m4/pilot_disc_actual_FE.png
