alan9900/Thermal-coupling-analysis-under-drive-control-integration/results/m4/pilot_temperature_curves.png

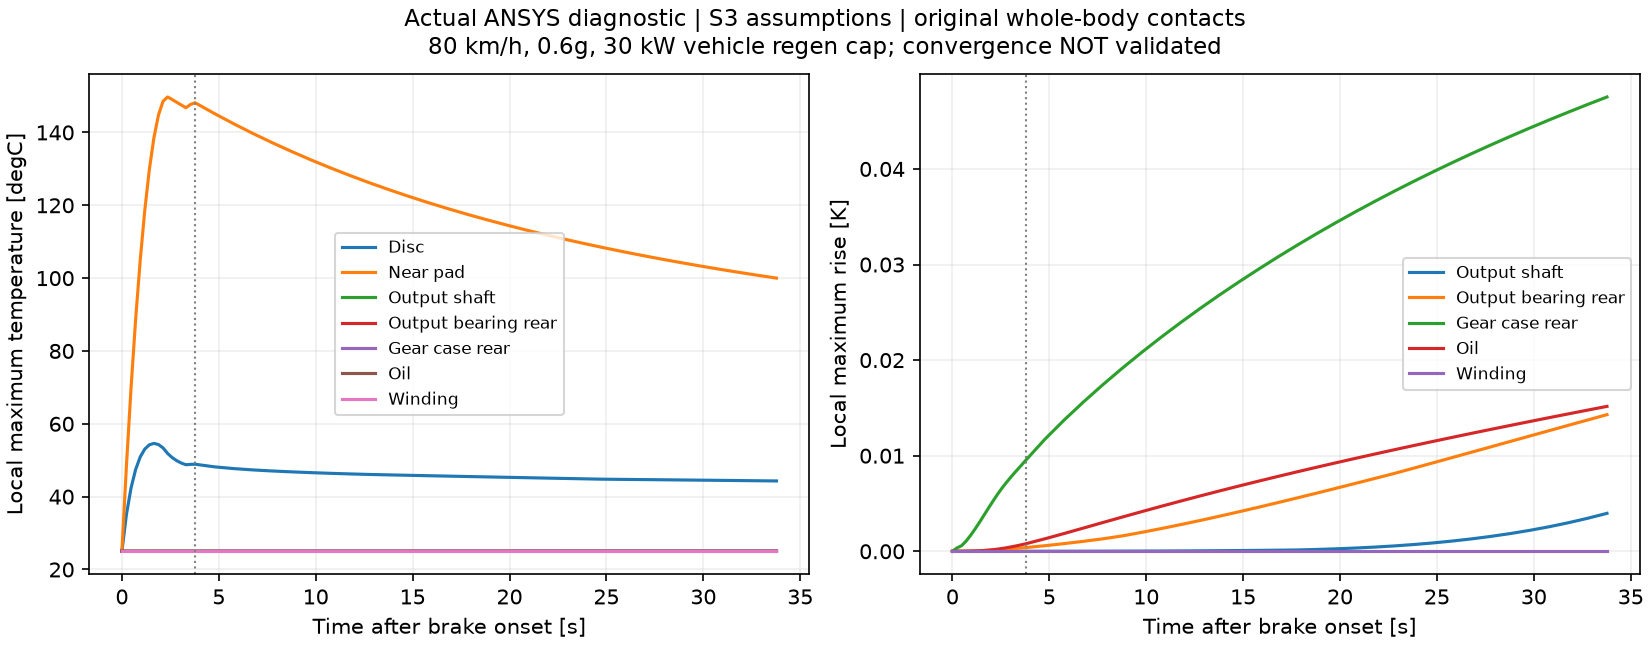
results/m4/pilot_temperature_curves.png
