alan9900/Thermal-coupling-analysis-under-drive-control-integration/results/m4/studies/A_normal12_rd95_dt1_retry1/pilot_disc_actual_FE.png

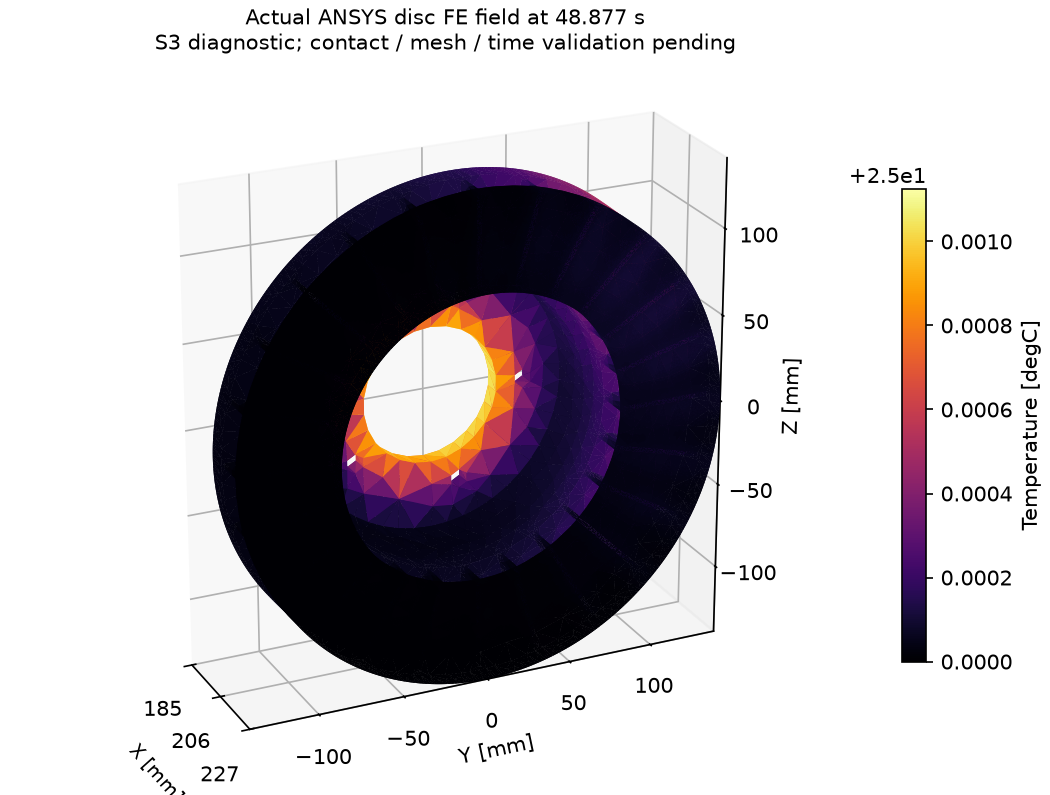
results/m4/studies/A_normal12_rd95_dt1_retry1/pilot_disc_actual_FE.png
