alan9900/Thermal-coupling-analysis-under-drive-control-integration/results/m4/studies/A_normal12_rd95_dt1_retry1/signed_heat_paths.png

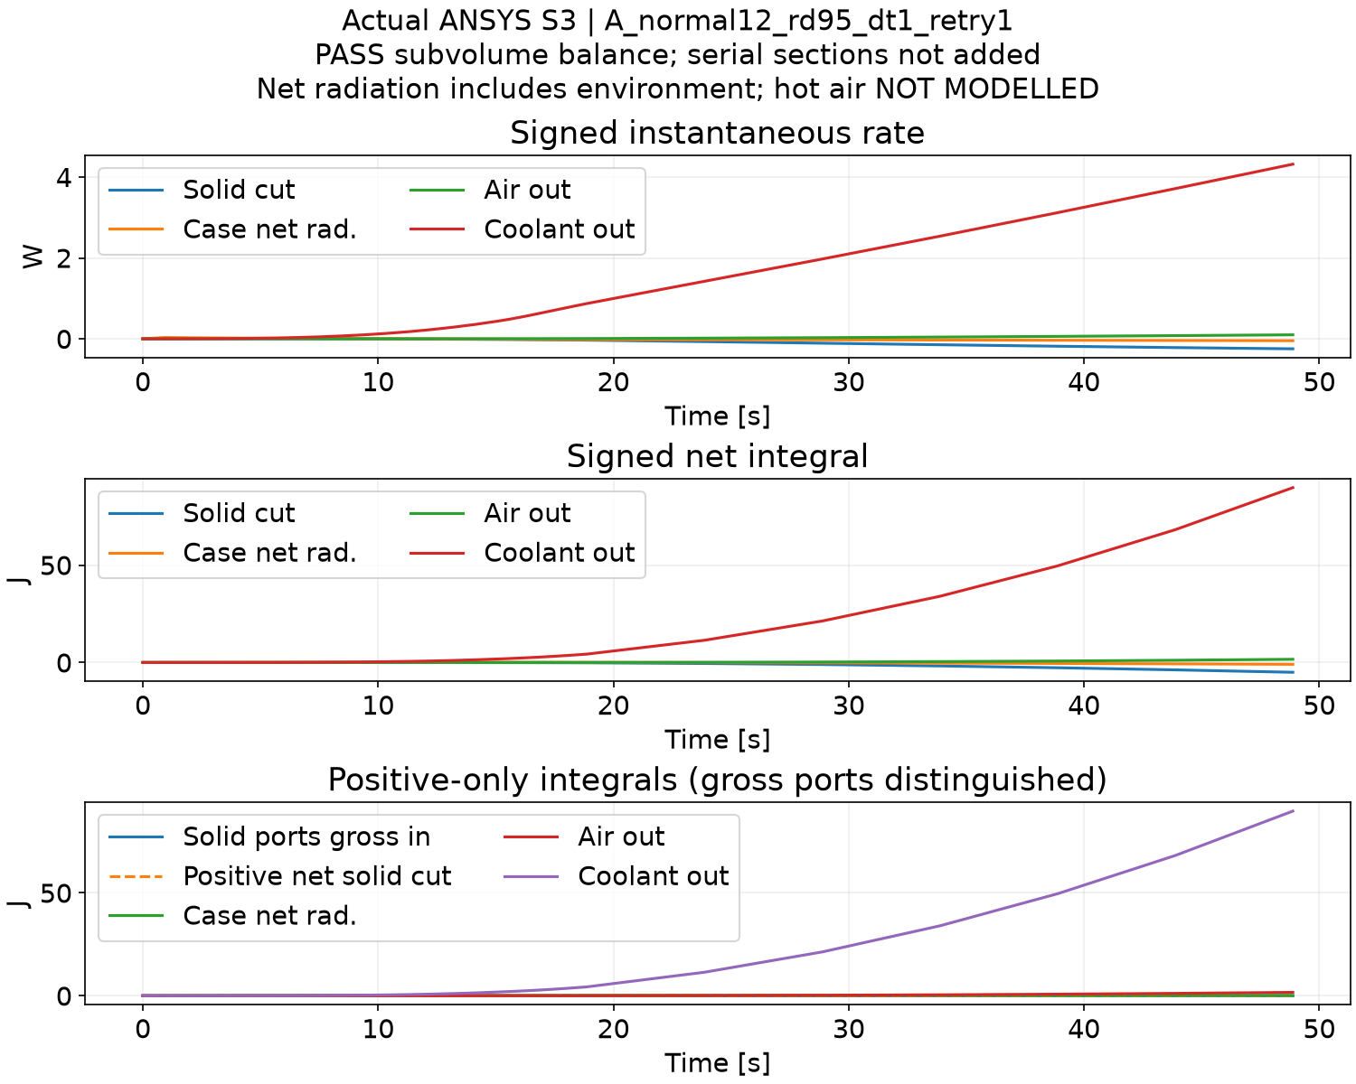
results/m4/studies/A_normal12_rd95_dt1_retry1/signed_heat_paths.png
