alan9900/Thermal-coupling-analysis-under-drive-control-integration/results/m4/studies/B_face_scoped_full/signed_heat_paths.png

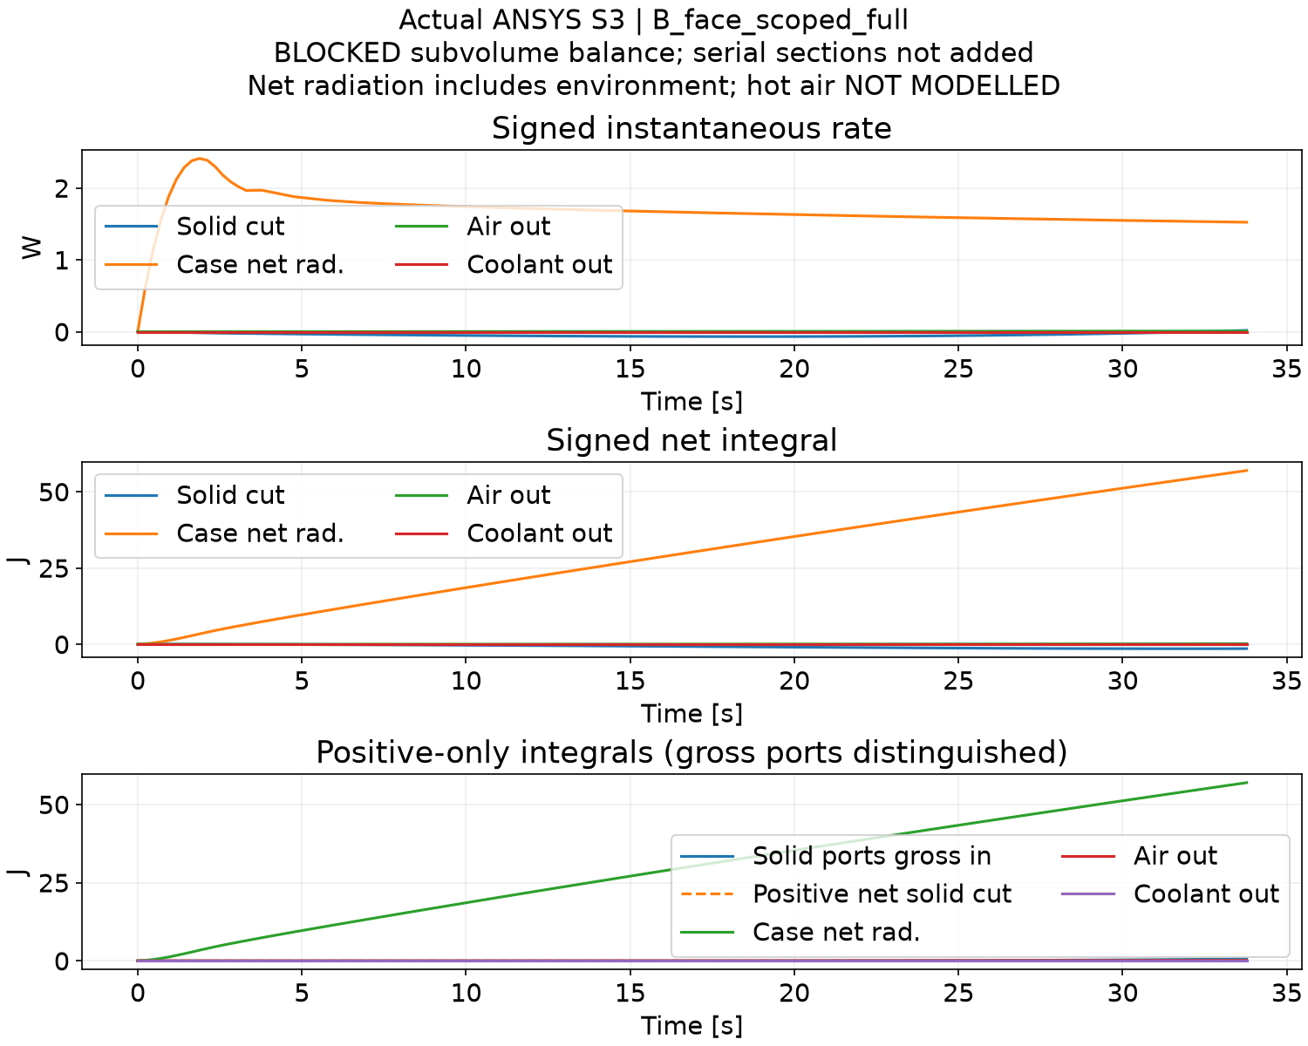
results/m4/studies/B_face_scoped_full/signed_heat_paths.png
