alan9900/Thermal-coupling-analysis-under-drive-control-integration/results/m4/studies/B_normal12_dt1_retry1/pilot_temperature_curves.png

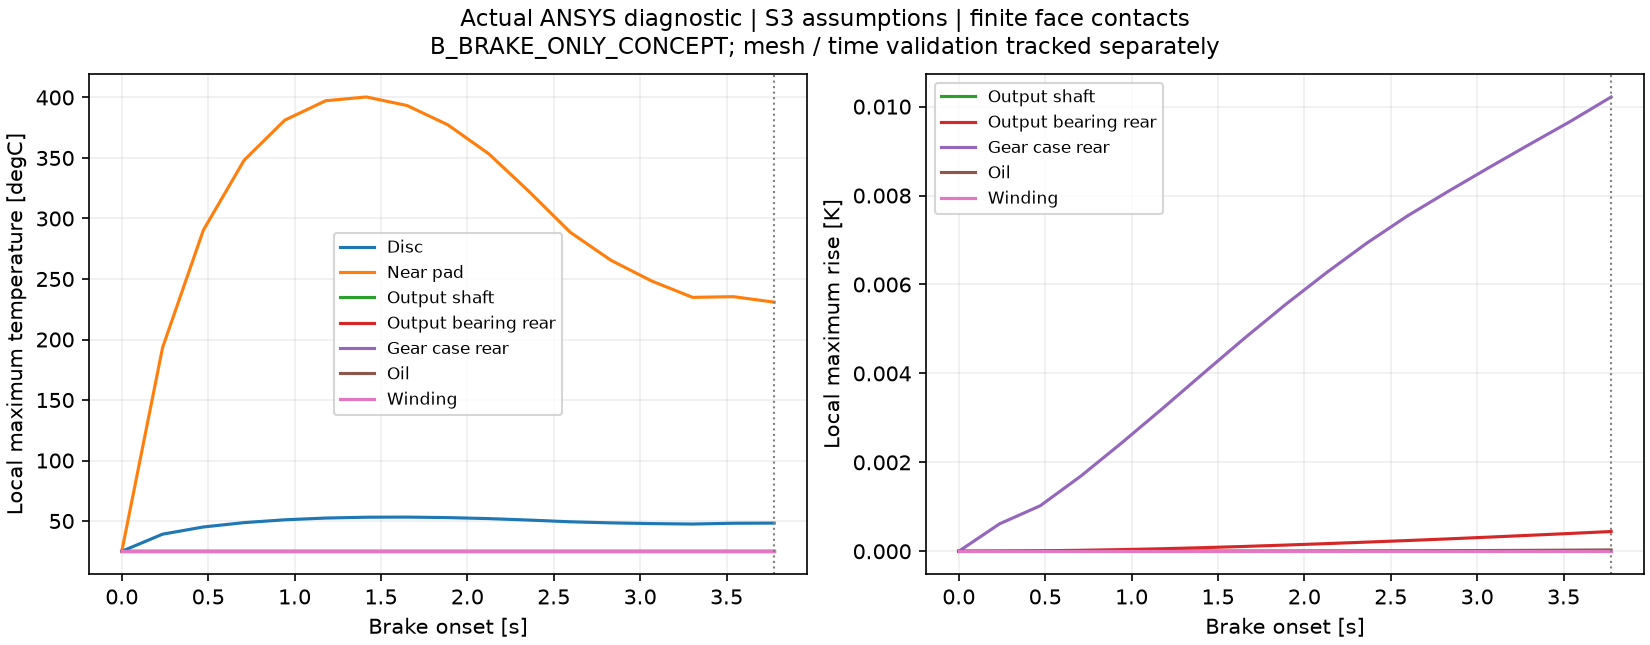
results/m4/studies/B_normal12_dt1_retry1/pilot_temperature_curves.png
