alan9900/Thermal-coupling-analysis-under-drive-control-integration/results/m4/studies/B_normal24_rd90h_dt1/pilot_FE_energy_balance.png

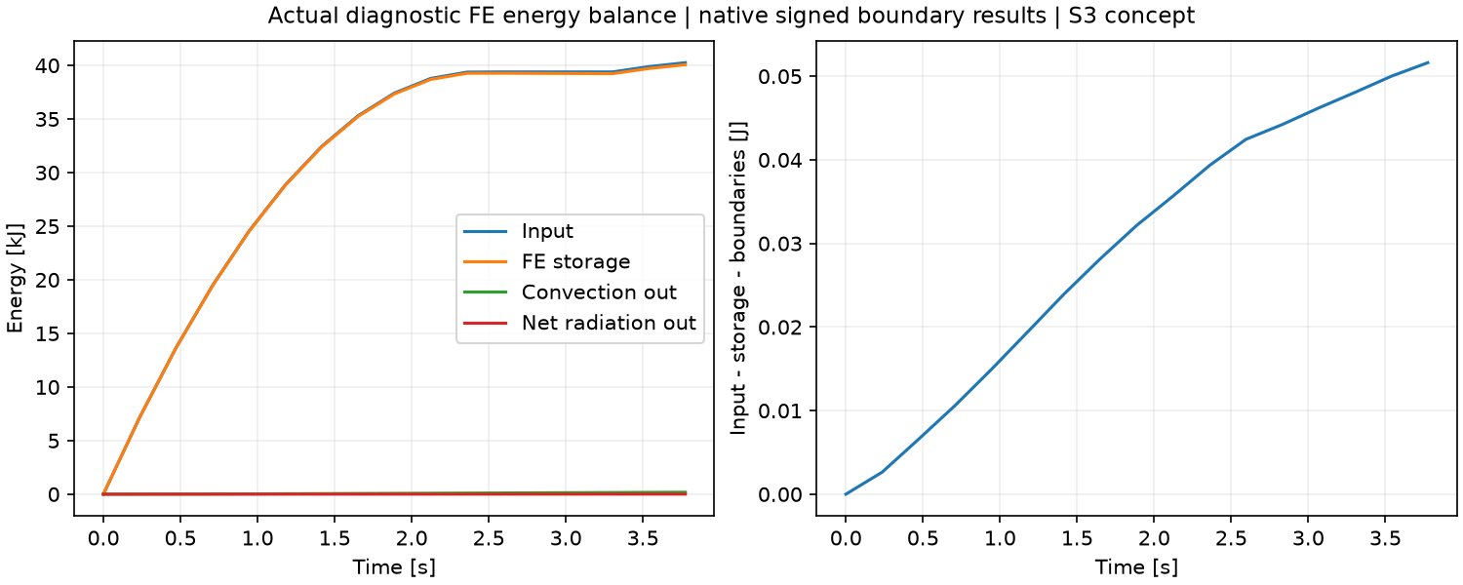
results/m4/studies/B_normal24_rd90h_dt1/pilot_FE_energy_balance.png
