alan9900/Thermal-coupling-analysis-under-drive-control-integration/results/m4/studies/B_normal24_rd95h_dt1/signed_heat_paths.png

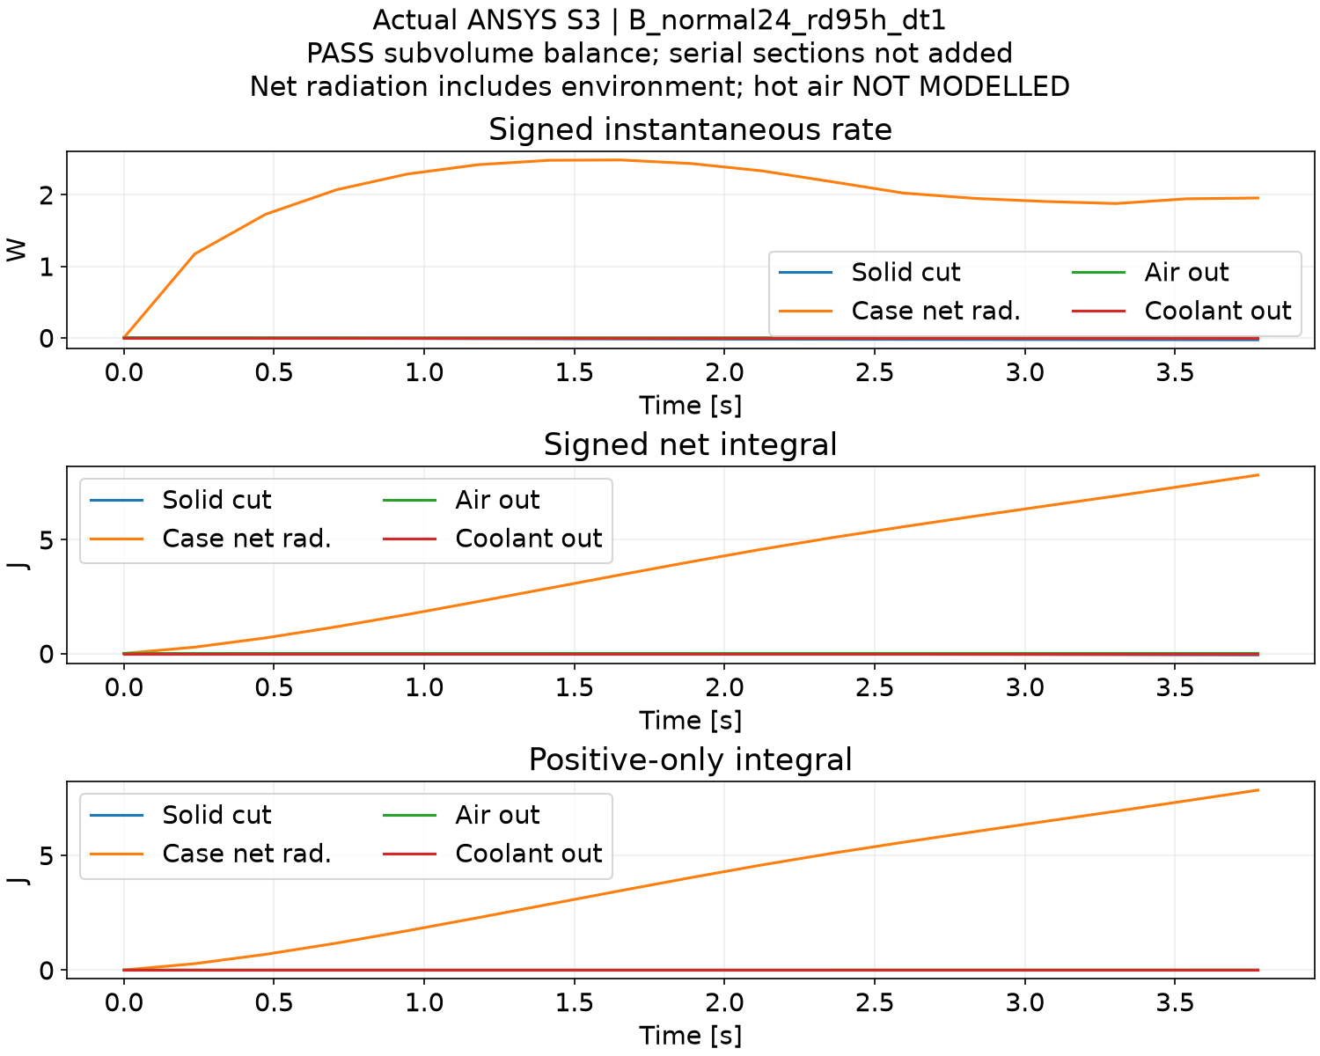
results/m4/studies/B_normal24_rd95h_dt1/signed_heat_paths.png
