alan9900/Thermal-coupling-analysis-under-drive-control-integration/results/m4/studies/C_normal12_rd95_dt1/signed_heat_paths.png

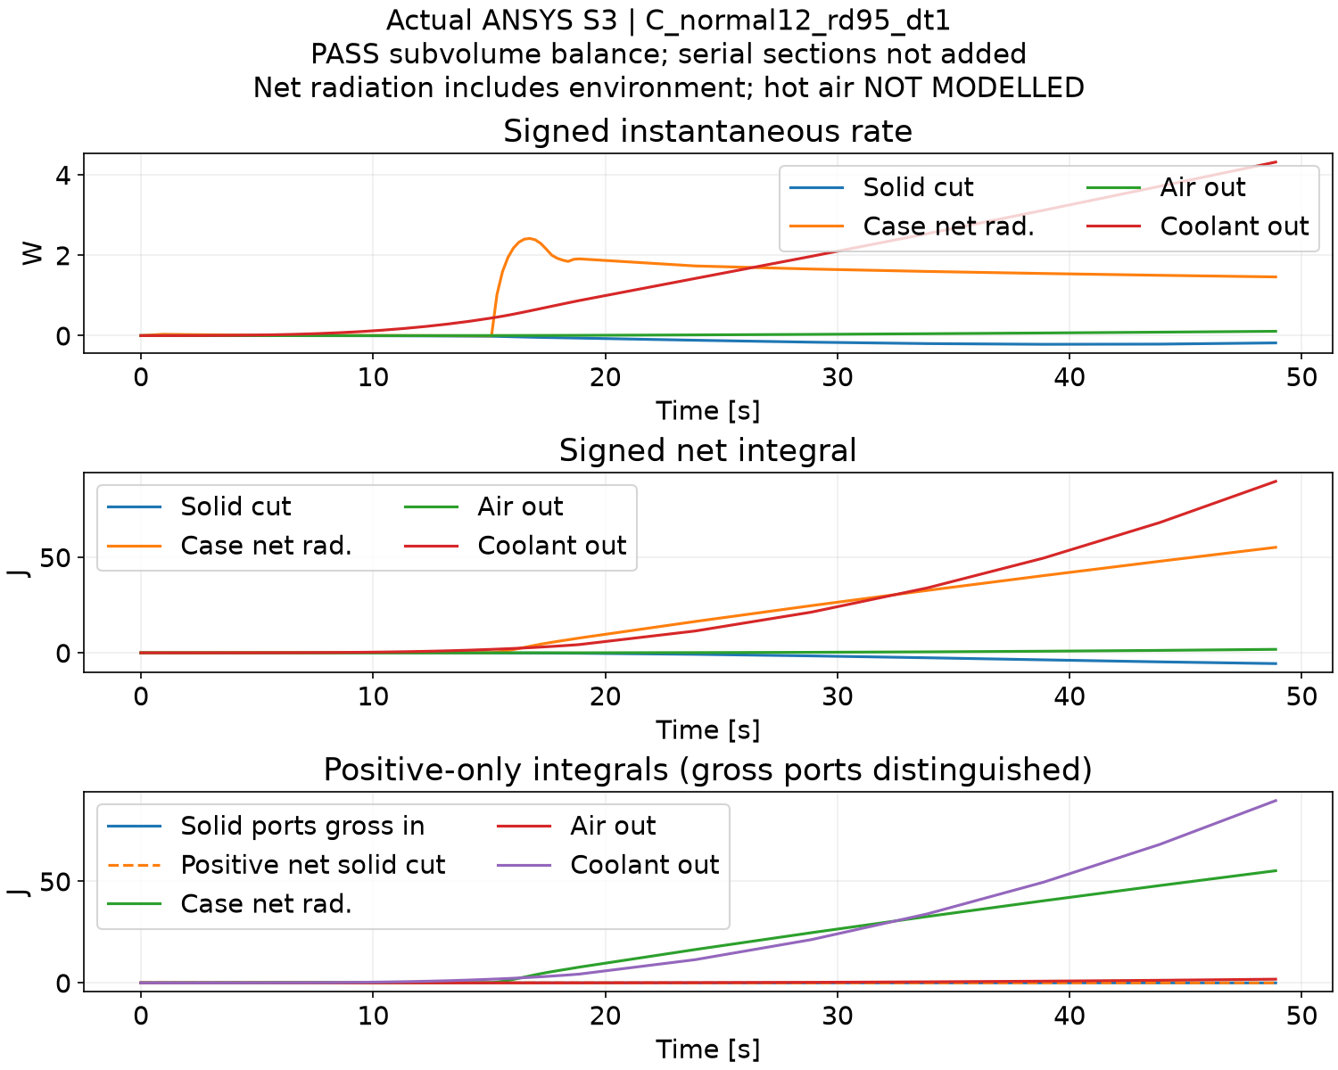
results/m4/studies/C_normal12_rd95_dt1/signed_heat_paths.png
