alan9900/Thermal-coupling-analysis-under-drive-control-integration/data/raw/m0/epa_mg2/1- Package Content & Revision History.docx

1- Package Content & Revision History

2010 Toyota Prius 60kW 650V MG2 EMOT

The following is a listing of the contents of this ALPHA Map Data Package along with the suggested citation format and revision history of the material. Use of any NCAT documents listed below, included as part of the complete test data package, should reference the suggested citation provided. Note that SAE Papers included in the package should utilize the designated SAE CITATION format.

SUGGESTED CITATION:

2010 Toyota Prius 60kW 650V MG2 EMOT – ALPHA Map Package. Version 2023-04. Ann Arbor, MI: US EPA, National Vehicle and Fuel Emissions Laboratory, National Center for Advanced Technology, 2023.

TEST PACKAGE CONTENTS:

1– Package Content & Revision History.docx | Brief overview document listing the contents, revision history & suggested citation format of the package
2– Related NCAT Packages.docx | Listing of related NCAT Test Data and ALPHA Engine Map Packages
3a– 2010 Toyota Prius 60kW 650V MG2 EMOT – ALPHA Generation Process.html | NCAT summary report describing the process followed to generate full efficiency and power loss maps
3b– 2010 Toyota Prius 60kW 650V MG2 EMOT – NCAT Test Report.docx | NCAT report outlining the test method and results for mapping the electric motor
3c– 2010 Toyota Prius 60kW 650V MG2 EMOT – ORNL Test Data File.xlsx | A variable file containing data collected during testing by ORNL
3d– Benchmarking of Competitive Technologies Presentation by ORNL May 2011.pdf [1] | Final presentation prepared by ORNL describing the test procedures and featured aspects of this system - Reference [1] in the NCAT Test Report
3e– FY2011 DOE Annual Progress Report Advanced Power Electronics and Electric Motors Program.pdf [2] | Report provided to DOE outlining the status update by ORNL for the testing and featured aspects of this system - Reference [2] in the NCAT Test Report
3f– Evaluation of the 2010 Toyota Prius Hybrid Synergy Drive System by ORNL March 2011.pdf [3] | Paper prepared by ORNL describing the specific overall testing approach utilized when testing electric motors and hybrid systems - Reference [3] in the NCAT Test Report
4a– 2010 Toyota Prius 60kW 650V MG2 EMOT – Efficiency.pdf | Contour plot of the Efficiency results of the mapping over the full operational area
5a– 2010 Toyota Prius 60kW 650V MG2 EMOT – Power Loss.pdf | Contour plot of the Power Loss results of the mapping over the full operational area
6– 2010 Toyota Prius 60kW 650V MG2 EMOT – Electrical Power Consumption Data.xlsx | Electrical power consumption and efficiency data over the operating range of the emotor extracted from the NCAT generated final power loss and efficiency contour plots (Package Contents 4a and 5a)
7– emachine_2010_Toyota_Prius_ 60kW_650V_MG2_EMOT.m | ALPHA output result text file

REVISION HISTORY:

Version 2023-04: Initial release

NCAT – National Center for Advanced Technology National Vehicle and Fuel Emissions Laboratory – Office of Transportation and Air Quality U.S. Environmental Protection Agency
