alan9900/Thermal-coupling-analysis-under-drive-control-integration/results/m3/structure_comparison.pdf

## Case0 | S3 concept, transparent casings

## CaseA | S3 concept, transparent casings

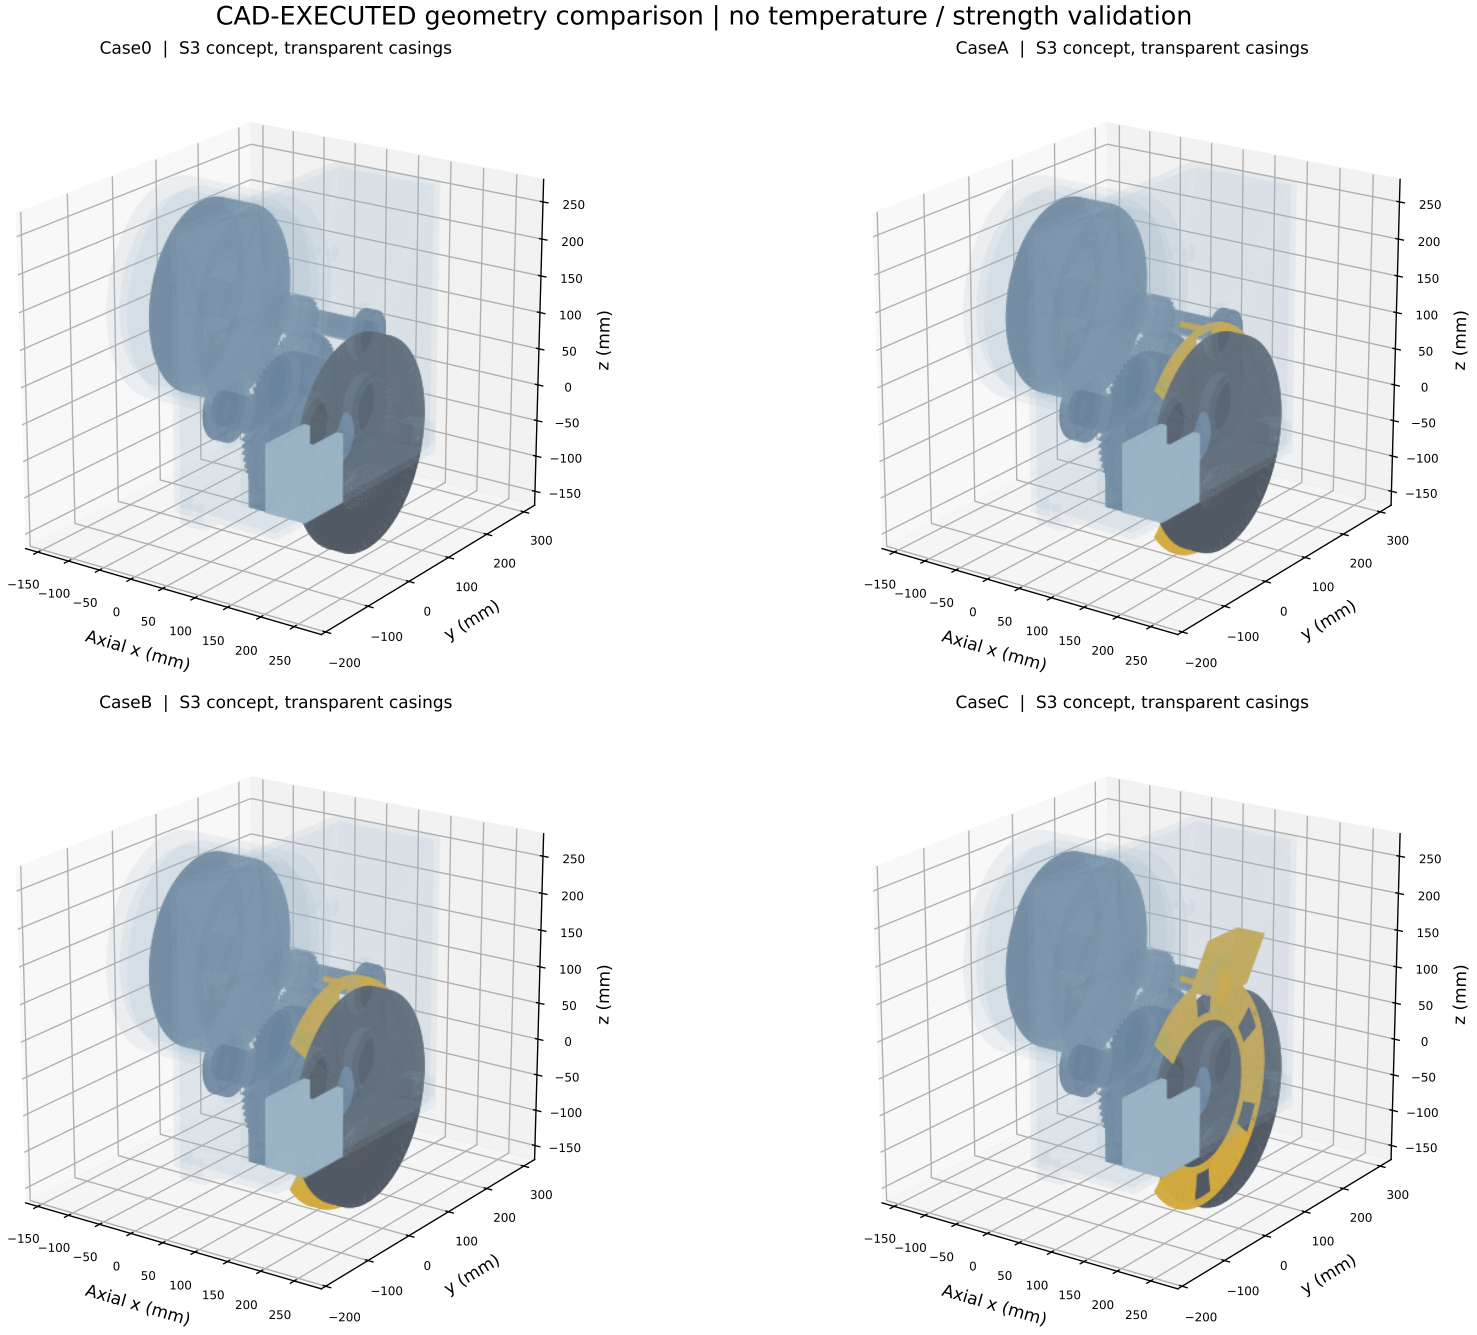
[picture p168: page 1]
250 Axial x (mm)

CAD-EXECUTED geometry comparison | no temperature / strength validation

CaseB | S3 concept, transparent casings

CaseC | S3 concept, transparent casings
