alan9900/Thermal-coupling-analysis-under-drive-control-integration/configs/m3_geometry.yaml

metadata:
  version: m3-geometry-concept-1.0
  vehicle_version: v0.4
  baseline_tag: M2-v1.0
  baseline_commit: 1d51c22d94577ff8f52be785300b5f6b4aadee37
  classification: S3_CONCEPT_CAD_NOT_MANUFACTURING_RELEASE
  length_unit: mm
  side: left
unknown_actual:
  production_motor_stub_and_mount: null
  production_reducer_geometry: null
  caliper_product_and_mount: null
  rotor_friction_inner_radius: null
  bearing_fits_preload_life: null
  shaft_spline_and_fatigue: null
  thermal_contact_resistance: null
  vehicle_installation_envelope: null
  coolant_flow_and_ports: null
motor_reference: # ORNL table 2.7, PDF page55/printed46. Do not scale.
  casing_diameter_mm: 302
  casing_length_mm: 161
  stator_od_mm: 264
  stator_id_mm: 161.9
  stator_stack_mm: 50.8
  rotor_od_mm: 160.4
  rotor_lamination_id_mm: 51
  rotor_stack_mm: 50.165
motor_design: # S3 equivalent features, not OEM water jacket or winding reconstruction.
  mounting_angles_deg: [20, 100, 180, 300] # cardinal pattern collided with intermediate bearing; staggered after B-rep check
  stub_diameter_mm: 30
  endcap_mm: 8
  core_start_x_mm: -105
  slot_count: 48
  slot_radial_start_mm: 85
  slot_depth_mm: 30.9
  slot_width_mm: 5.2
  copper_width_mm: 4.8
  end_winding_length_mm: 4.4
  jacket_inner_radius_mm: 137
  jacket_outer_radius_mm: 142
  jacket_start_x_mm: -133
  jacket_end_x_mm: -28
reducer: # S3 new parallel-axis two-stage spur reducer, not Toyota planetary transaxle.
  module_stage1_mm: 2.5
  module_stage2_mm: 3
  teeth_pinion: 20
  teeth_gear: 60
  pressure_angle_deg: 20
  backlash_mm: 0.15
  face_stage1_mm: 25
  face_stage2_mm: 32
  stage1_start_x_mm: 33
  stage2_start_x_mm: 95
  intermediate_shaft_diameter_mm: 35
  output_shaft_diameter_mm: 45
  output_shaft_start_x_mm: 0 # initial -5mm protrusion interfered with motor endcap; retracted, motor unchanged
  case_length_mm: 160
  case_wall_mm: 6
  case_y_limits_mm: [-110, 285]
  case_z_limits_mm: [-110, 265]
  output_bearing: {designation: SKF_6209_envelope_only, bore_mm: 45, od_mm: 85, width_mm: 19}
  intermediate_bearing: {designation: SKF_6207_envelope_only, bore_mm: 35, od_mm: 72, width_mm: 17}
  input_bearing: {designation: SKF_6206_envelope_only, bore_mm: 30, od_mm: 62, width_mm: 16}
brake_reference: # Brembo09.9908.21 envelope only; modified internal geometry is S3.
  outer_diameter_mm: 280
  thickness_mm: 22
  total_height_mm: 42
  pilot_diameter_mm: 68
brake_design:
  near_face_x_mm: 205
  friction_inner_radius_mm: 85
  face_plate_mm: 6
  vane_count: 24
  vane_width_mm: 2.8
  hub_pcd_mm: 112 # S3: NOT verified OEM PCD
  hub_bolt_count: 5
  hub_bolt_hole_mm: 11
  pad_running_gap_mm: 0.5
  rotor_hot_delta_K: 400 # expansion screening scenario, not predicted M2 temperature
  assembly_tolerance_mm: 1.0
  axial_runout_budget_mm: 0.1 # S3 candidate; 1mm runout is explicitly rejected in range checks
  pad_axial_tolerance_mm: 0.1
shield_design:
  thickness_mm: 1.5
  disc_gap_mm: 10
  double_air_gap_mm: 10
  inner_radius_mm: 95
  outer_radius_mm: 150
  caliper_cutout_deg: 80
  opening_fraction: 0.15 # vent AREA / available annular area after caliper cutout; bridge bands retained
  vent_inner_radius_mm: 105
  vent_outer_radius_mm: 140
  vent_angles_deg: [30, 90, 270, 330]
  outlet_angle_deg: 20
  duct_height_mm: 70
  duct_width_x_mm: 40
  duct_width_y_mm: 70
ranges:
  disc_case_gap_mm: [25, 45, 65]
  shaft_diameter_mm: [40, 45, 50]
  shield_gap_mm: [5, 10, 15]
  shield_thickness_mm: [1, 1.5, 2]
  double_air_gap_mm: [5, 10, 15]
  opening_fraction: [0.10, 0.15, 0.30]
  outlet_angle_deg: [0, 20, 35]
  contact_area_fraction: [0.10, 0.5, 1.0]
materials: # All equivalent properties S3; M2 generic material references reused read-only.
  aluminium: {rho_kg_m3: 2710, cp_J_kgK: 900, k_W_mK: 170, alpha_per_K: 0.000023}
  steel: {rho_kg_m3: 7800, cp_J_kgK: 460, k_W_mK: 45, alpha_per_K: 0.000012}
  cast_iron: {rho_kg_m3: 7100, cp_J_kgK: 500, k_W_mK: 45, alpha_per_K: 0.000011}
  copper: {rho_kg_m3: 8960, cp_J_kgK: 385, k_W_mK: 390, alpha_per_K: 0.000017}
  stainless: {rho_kg_m3: 7800, cp_J_kgK: 500, k_W_mK: 15, alpha_per_K: 0.000017}
  pad: {rho_kg_m3: 2500, cp_J_kgK: 800, k_W_mK: 2, alpha_per_K: 0.000012}
  oil: {rho_kg_m3: 850, cp_J_kgK: 2000, k_W_mK: 0.13, alpha_per_K: 0.0007}
  water_equivalent: {rho_kg_m3: 1000, cp_J_kgK: 4180, k_W_mK: 0.6, alpha_per_K: 0.0002}
screening: # Limits below are assumptions, not allowable stresses from certified materials.
  software_motor_torque_Nm: 130
  transmission_efficiency_drive: 0.96
  brake_torque_Nm: 752.84
  shaft_notch_factor: 1.5
  shaft_screen_limit_MPa: 180
  bracket_screen_limit_MPa: 160
  friction_mu: 0.35
  radiation_samples: 32768
  radiation_seed: 20261020
