alan9900/Thermal-coupling-analysis-under-drive-control-integration/(commit log)

2026-10-18 docs: introduce drive-brake thermal research roadmap
2026-10-18 research: audit 1800kg baseline consistency and add v0.2 screening scenarios
2026-10-18 archive: preserve original central-motor baseline before dual-motor conversion
2026-10-18 config: switch canonical baseline to twin 60kW independent motors and one-side thermal model
2026-10-18 research: define dual-independent-motor single-side thermal study and sizing verification
2026-10-18 docs: migrate README.md to dual-motor v0.3 canonical architecture
2026-10-18 docs: migrate AGENTS.md to dual-motor v0.3 canonical architecture
2026-10-18 docs: flag obsolete centralized motor assumptions and link canonical V0.3
2026-10-18 docs: clarify heat source terminology in Codex instructions
2026-10-18 archive: preserve V0.3 front-drive dual-motor configuration
2026-10-18 config: adopt sourced V0.4 RWD twin motor single-side baseline
2026-10-18 research: document literature-grounded rear twin-motor reference and calculations
2026-10-18 docs: set V0.4 sourced rear-wheel-drive architecture as canonical
2026-10-18 docs: add mandatory per-stage Git branches PR approvals and immutable milestone tags
2026-10-18 docs: enforce Git versioning and user approval at stage gates in AGENTS.md
2026-10-18 docs: enforce Git versioning and user approval at stage gates in docs/CODEX_EXECUTION.md
2026-10-18 docs: enforce Git versioning and user approval at stage gates in README.md
2026-10-19 docs(m0): add eight-stage research work plan image
2026-10-19 feat(m1): add independent rear heat-source and power-ledger models
2026-10-19 test(m1): add independent ledger audit and remove grid-query warnings
2026-10-19 fix(m1): report drive heat-split coverage only during traction
2026-10-19 docs(m1): archive verified results and partial-stage report
2026-10-19 feat(m1): add traceable engineering source partitions and bounded uncertainty
2026-10-19 refactor(m2): bound result archive size and document material assumptions
2026-10-20 feat(m3): add sourced dimensions and parameterized single-side CAD generator
2026-10-20 fix(m3): resolve shaft-end interference and stabilize vented-disc STEP topology
2026-10-20 docs(m3): document CAD replay, geometry interfaces and design limitations
2026-10-20 results(m3): archive validated STEP assemblies, geometry checks and reviewed reports
2026-10-20 docs(m3): register full CAD evidence commit and blob integrity verification
2026-10-20 M3: add independent mechanical refinement and thermal CAD audit
2026-10-20 M3: resolve coupling clashes and model bearing retention and float gaps
2026-10-20 M3: move shield anchor away from bearing cap and add matching fasteners
2026-10-20 M3: strengthen keyed joints and halfshaft engagement after failed screens
2026-10-20 M3: make bearing assembly possible with removable sleeves and supported seals
2026-10-20 M3: preserve sleeve uncertainty and add explicit assembly/contact regressions
2026-10-20 M3: finalize traceability checks and include removable sleeve in thermal path diagram
2026-10-20 M3: archive refined CAD, thermal interfaces and partial geometry review evidence
2026-10-20 M3: register review evidence SHA and verify committed bytes and remote stage refs
2026-10-20 M3: verify suspected output gear case interference in STEP and SolidWorks
2026-10-20 M3: register output gear clearance recheck evidence SHA
2026-10-20 feat(m3): add transverse-system helical gear concept generator
2026-10-20 test(m3): verify actual helical edges, mesh phases and thermal capacities
2026-10-20 feat(m3): complete bounded helical heat interface and reproducible audit workflow
2026-10-20 feat(m3): deliver validated two-stage helical CAD and thermal equivalents
2026-10-21 feat(m4): scope friction heat, finite interfaces and expose mesh rejection
2026-10-21 feat(m4): audit actual contact heat paths and completed source studies
2026-10-22 feat(m4): archive preheat fields, audit native materials and resume interrupted verification
2026-10-22 docs(plan): adopt no-regeneration thermal coupling plan; keep research paused
2026-10-23 feat(m4): add audited P1-A zero-regen single-brake source baseline
